Tylenoler/Hyperion/视觉素材/无标题的项目 (2).png

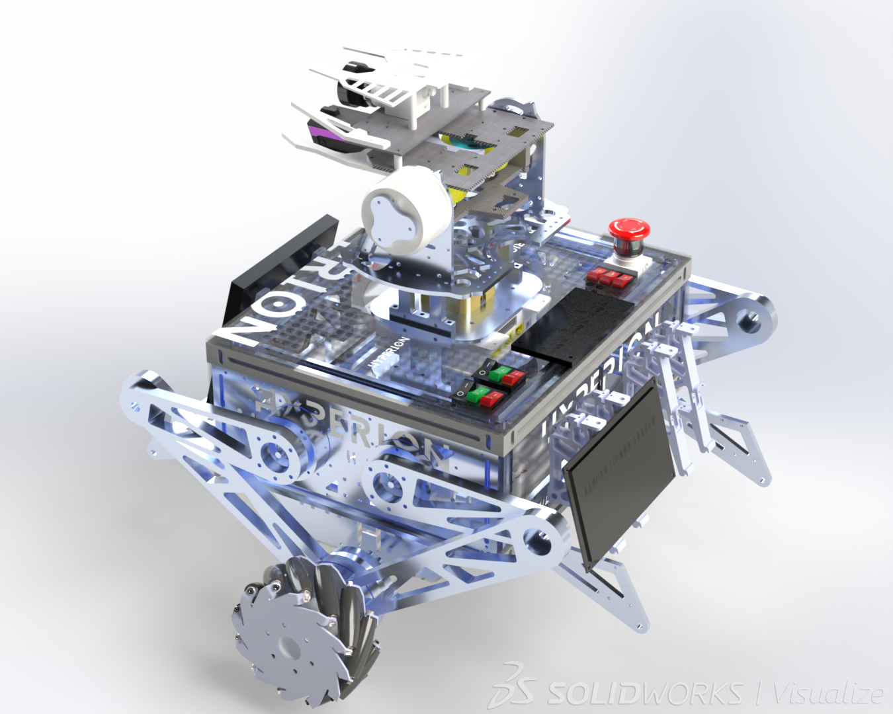
视觉素材/无标题的项目 (2).png
