Tylenoler/Hyperion/机械方面/电气部分/emergency-stop-switch-2.snapshot.23/EMERGENCY-STOP-STOP.fw.png

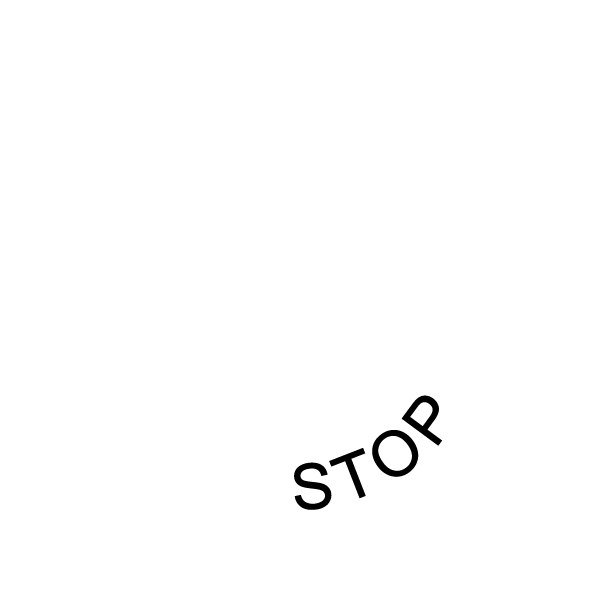
机械方面/电气部分/emergency-stop-switch-2.snapshot.23/EMERGENCY-STOP-STOP.fw.png
