Tylenoler/Hyperion/机械方面/电气部分/rocker-switch-34.snapshot.8 (2)/Rocker Switch_Render.png

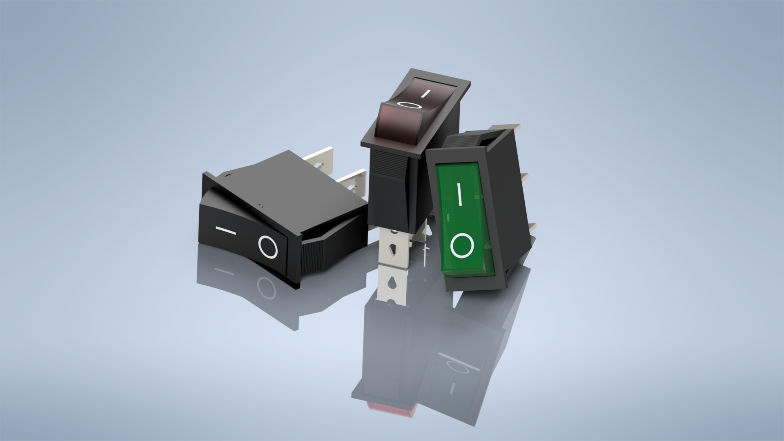
机械方面/电气部分/rocker-switch-34.snapshot.8 (2)/Rocker Switch_Render.png
