Tylenoler/Hyperion/机械方面/配图/24V电池-质量与官方相同.png

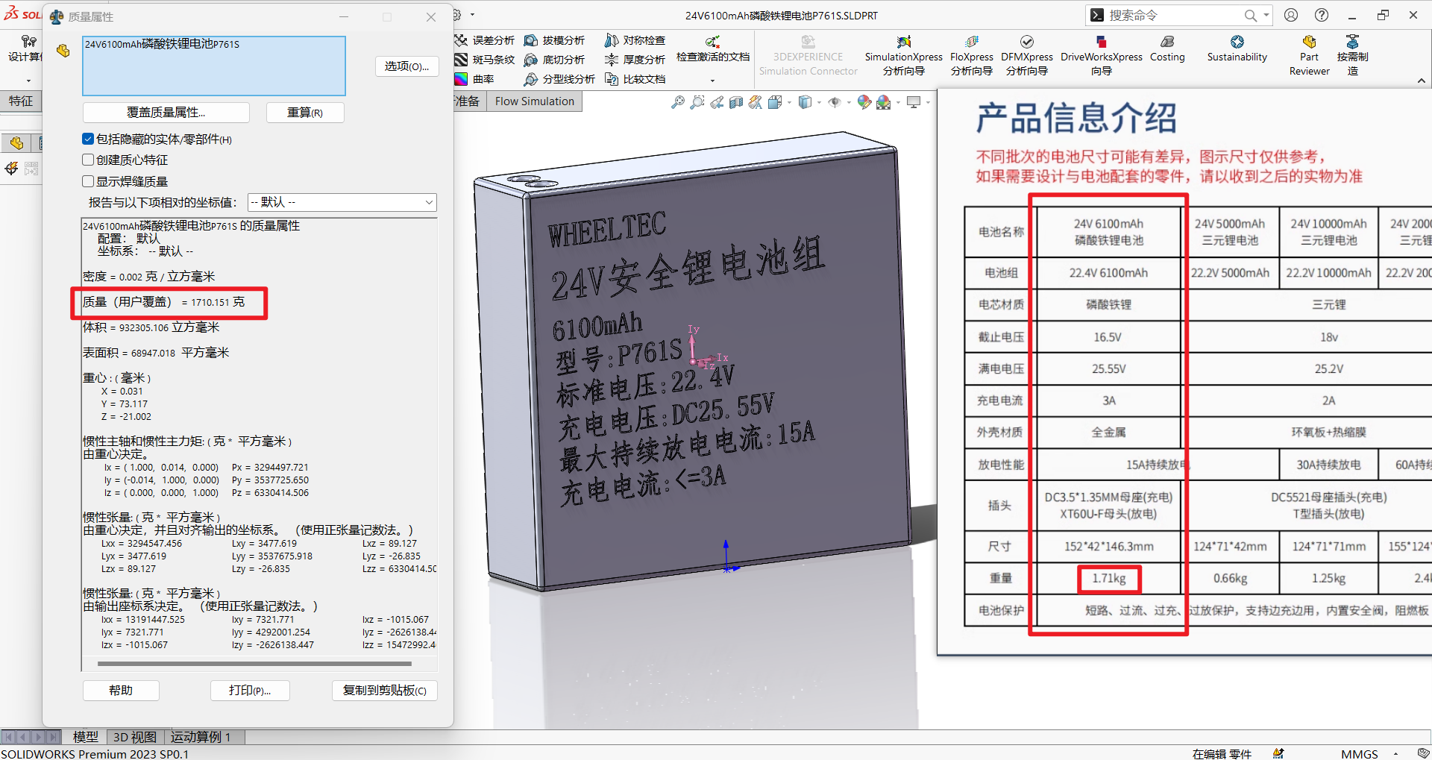
机械方面/配图/24V电池-质量与官方相同.png
