Tylenoler/Hyperion/机械方面/配图/稀土磁三相内转子57无刷电机-质量与官方一致.png

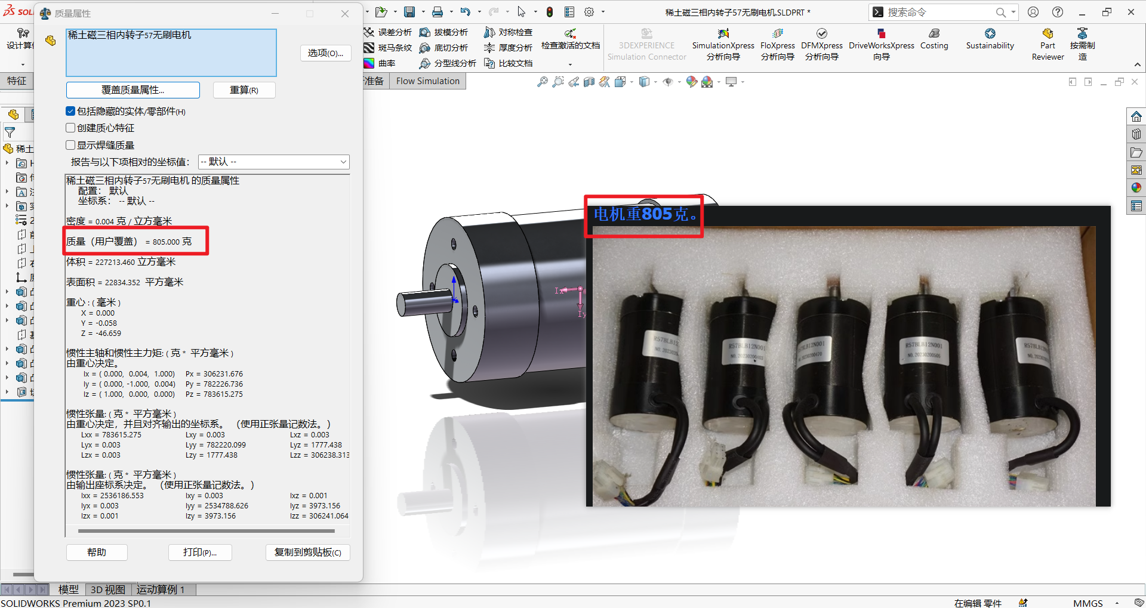
机械方面/配图/稀土磁三相内转子57无刷电机-质量与官方一致.png
