Tylenoler/Hyperion/视觉素材/DJI/R-C.png

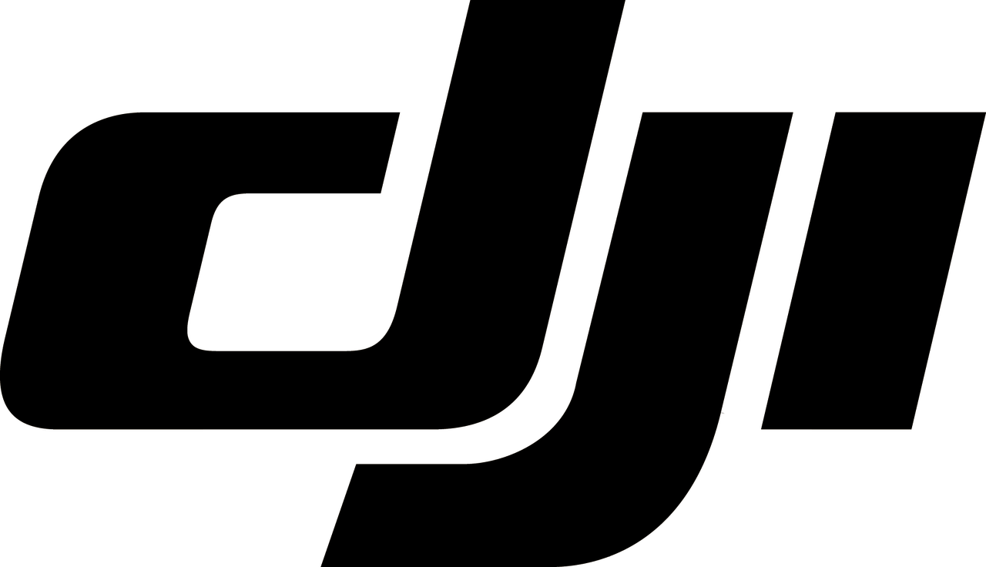
视觉素材/DJI/R-C.png
