Tylenoler/Hyperion/视觉素材/DJI/未标题-4.png

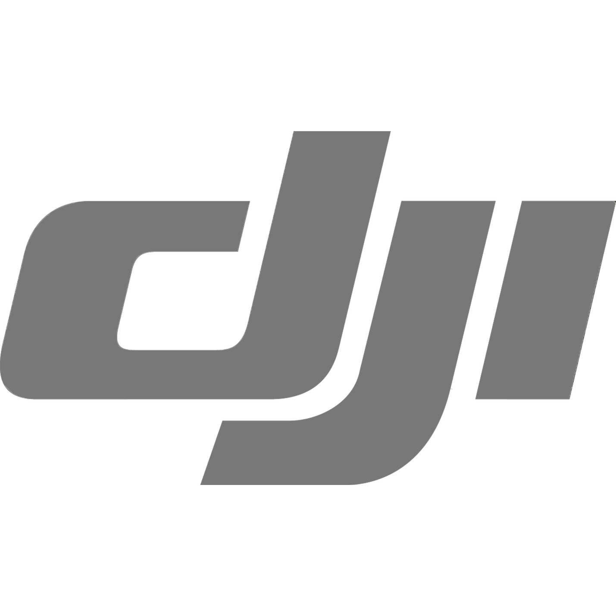
视觉素材/DJI/未标题-4.png
