Tylenoler/Hyperion/视觉素材/mmexport1707235157882.png

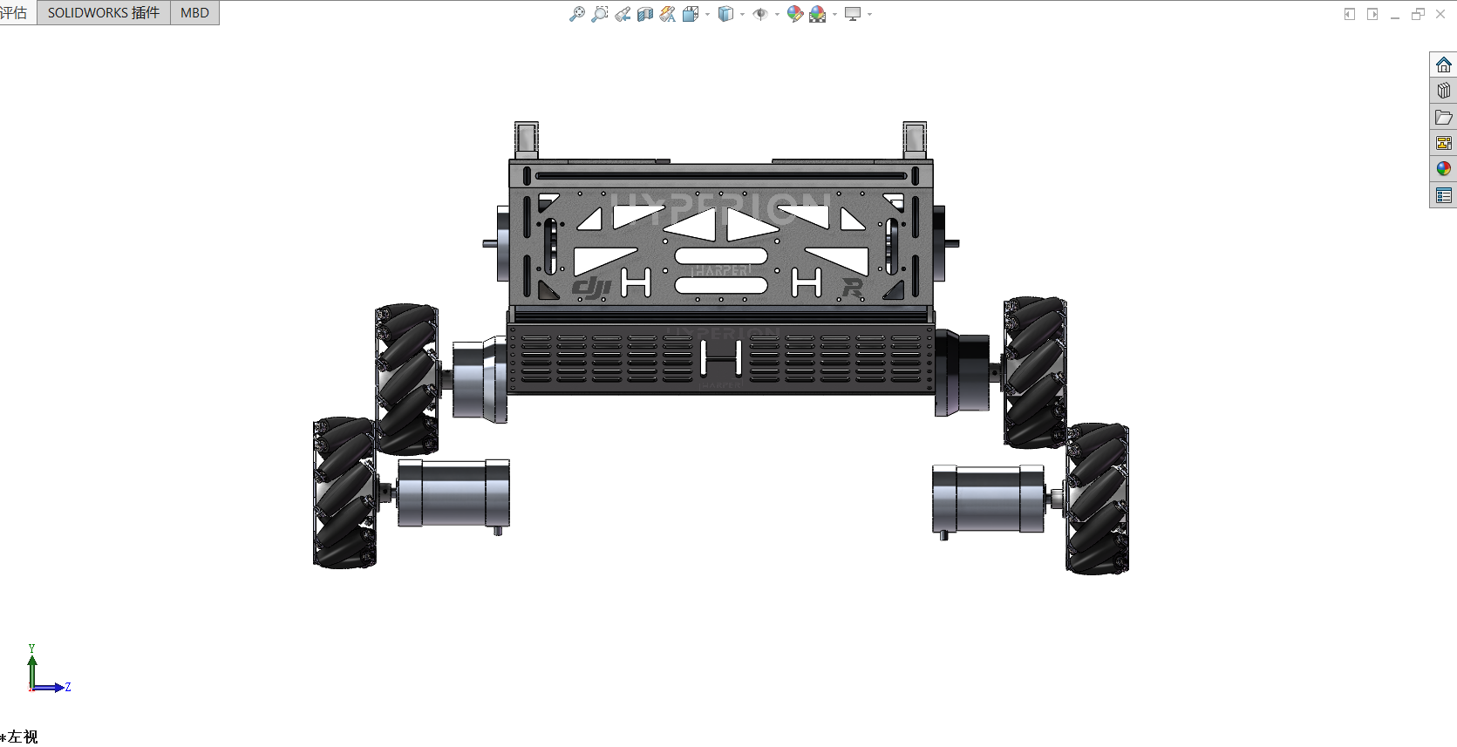
视觉素材/mmexport1707235157882.png
