Tylenoler/Hyperion/视觉素材/mmexport1707281538152.png

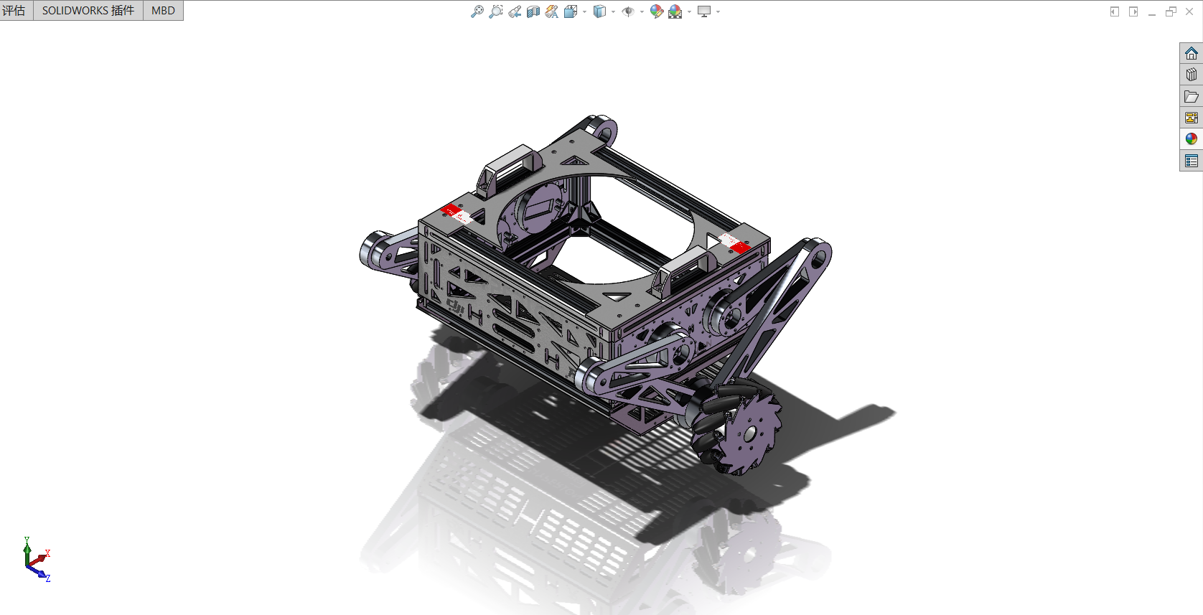
视觉素材/mmexport1707281538152.png
