Tylenoler/Hyperion/视觉素材/mmexport1707281540015.png

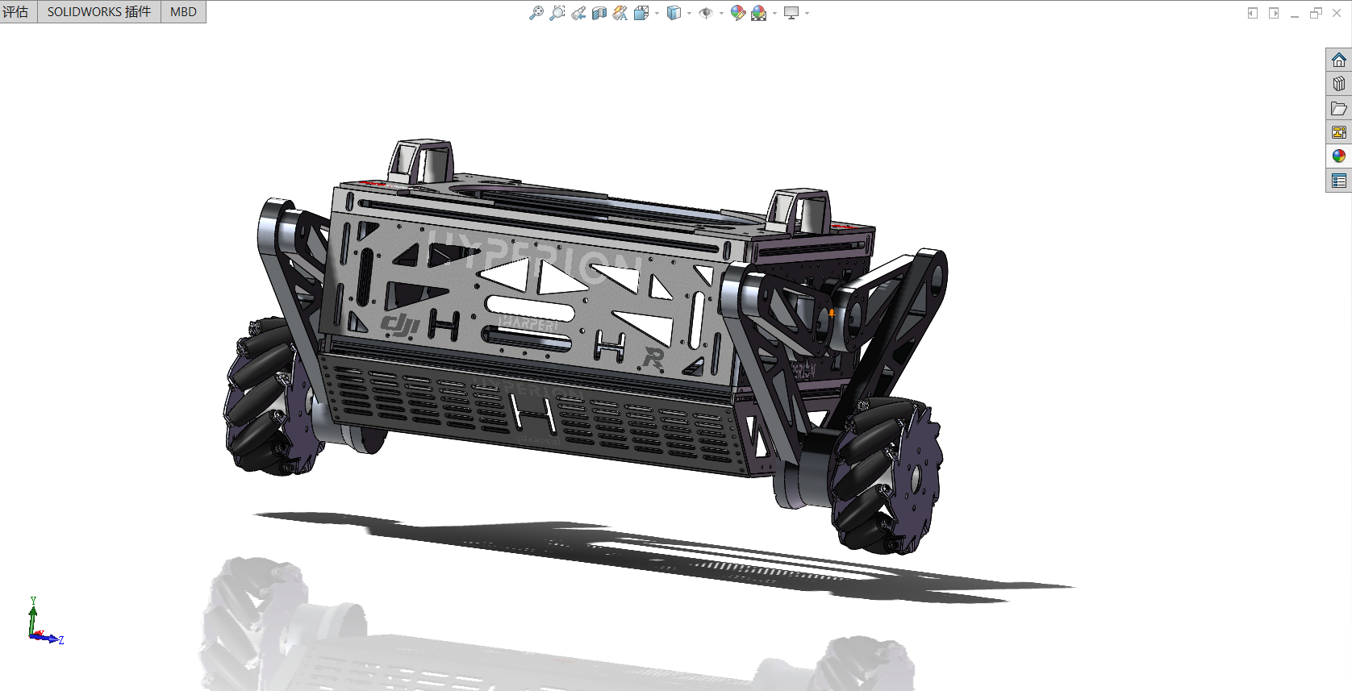
视觉素材/mmexport1707281540015.png
