Tylenoler/Hyperion/视觉素材/mmexport1707281541714.png

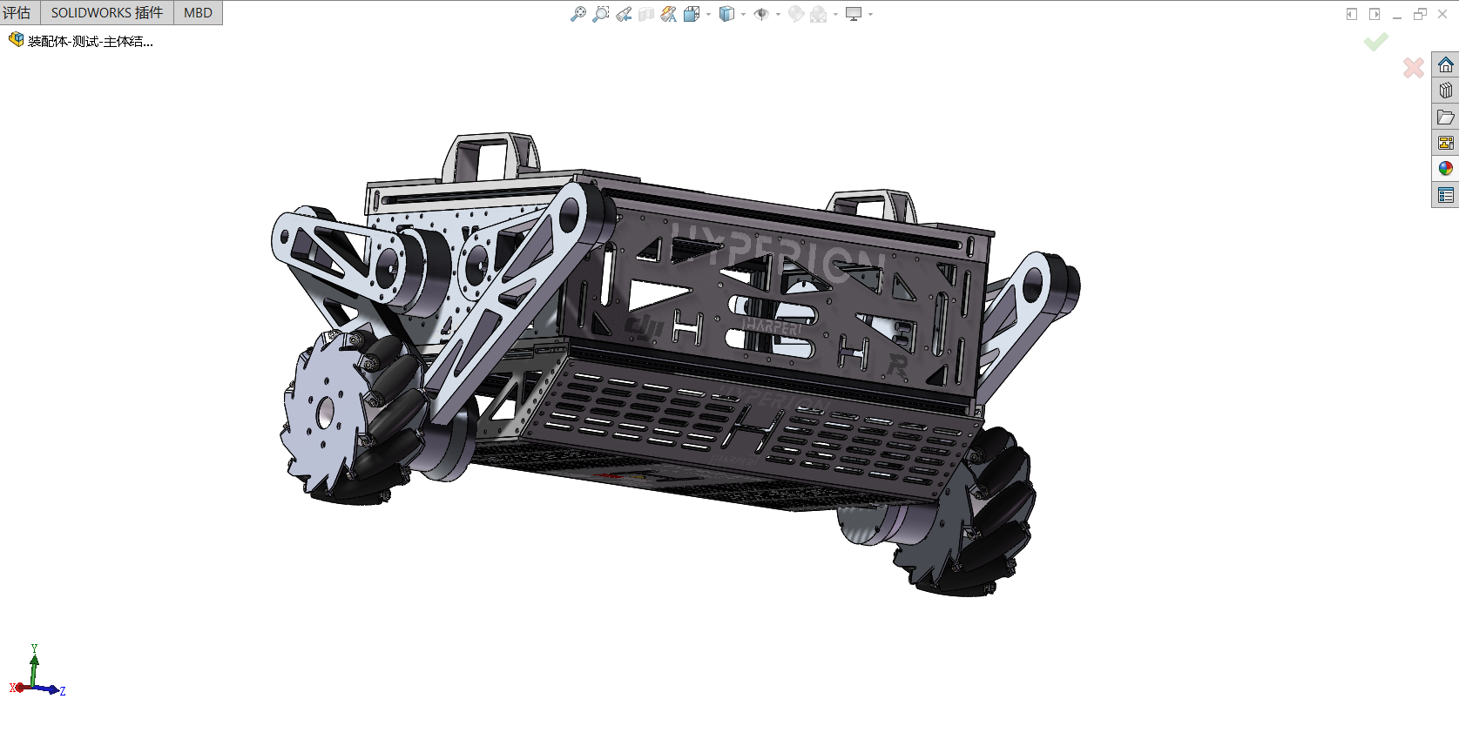
视觉素材/mmexport1707281541714.png
