Tylenoler/Hyperion/视觉素材/mmexport1707281543466.png

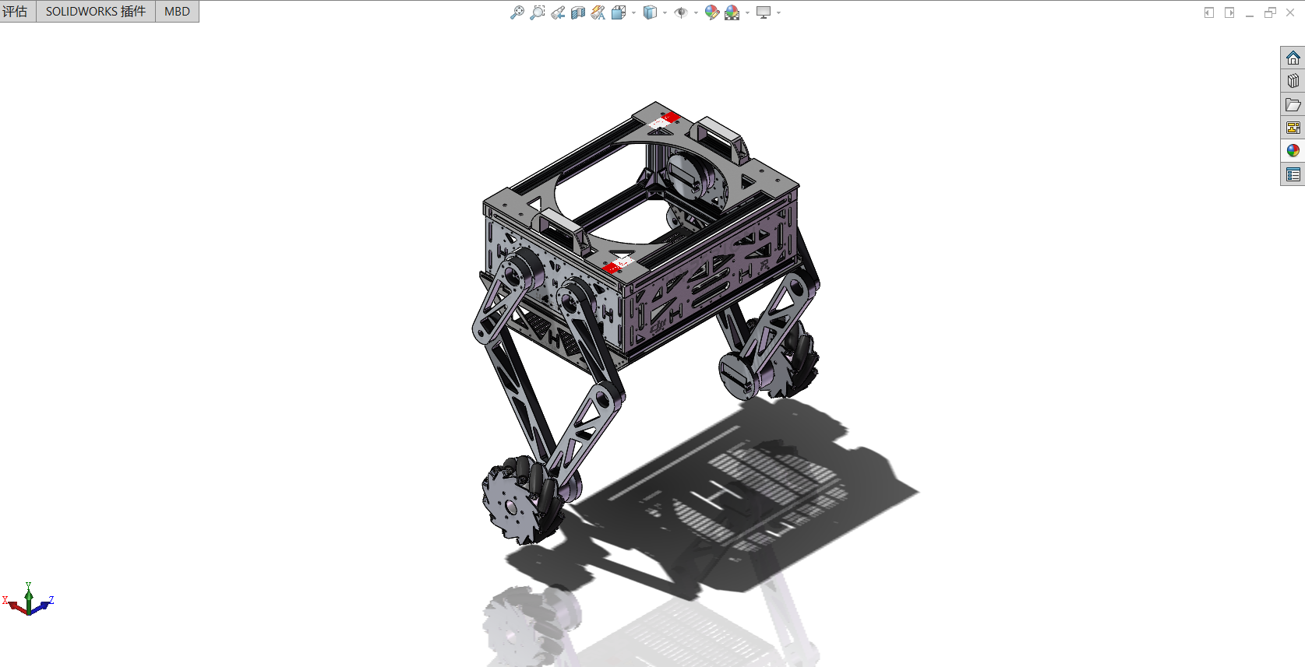
视觉素材/mmexport1707281543466.png
