Tylenoler/Hyperion/视觉素材/mmexport1707281544917.png

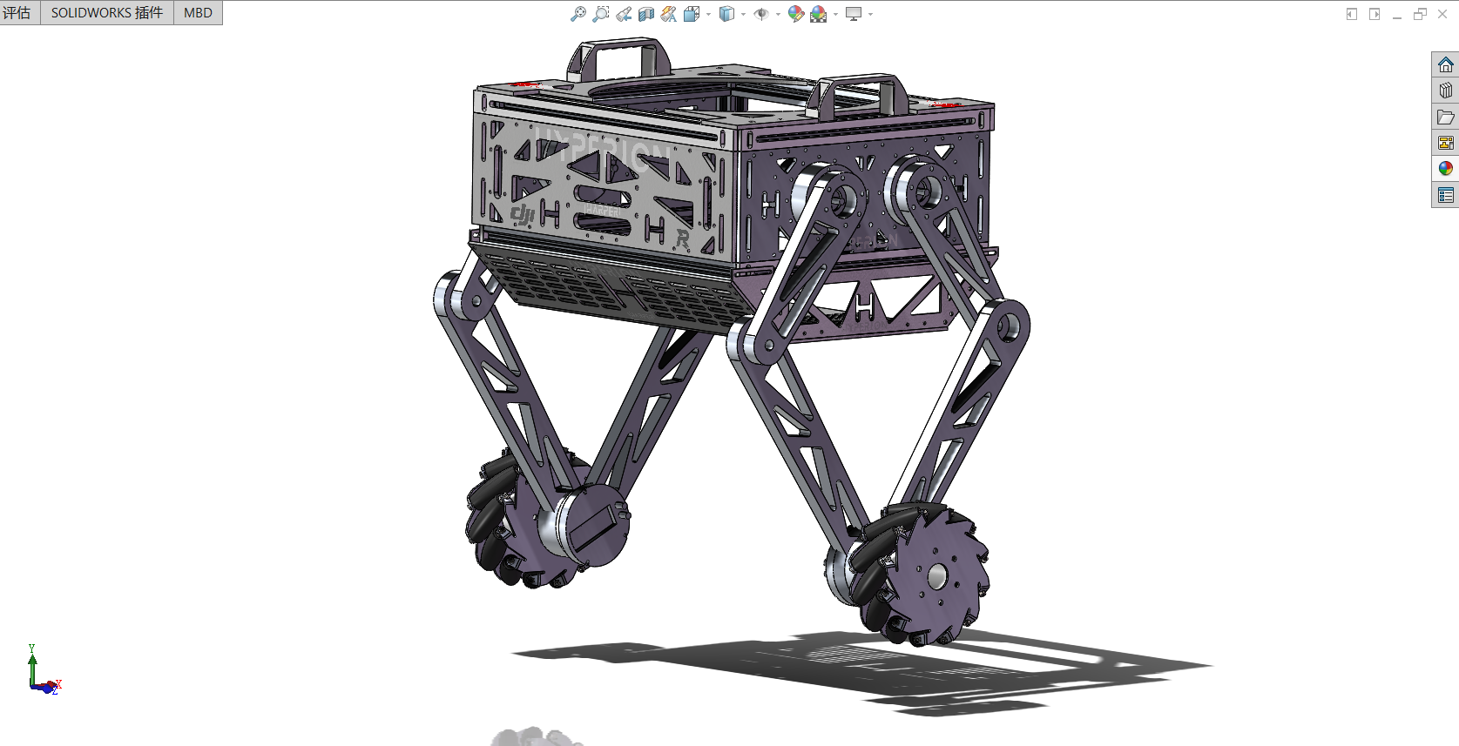
视觉素材/mmexport1707281544917.png
