Tylenoler/Hyperion/视觉素材/mmexport1707289371114.jpg

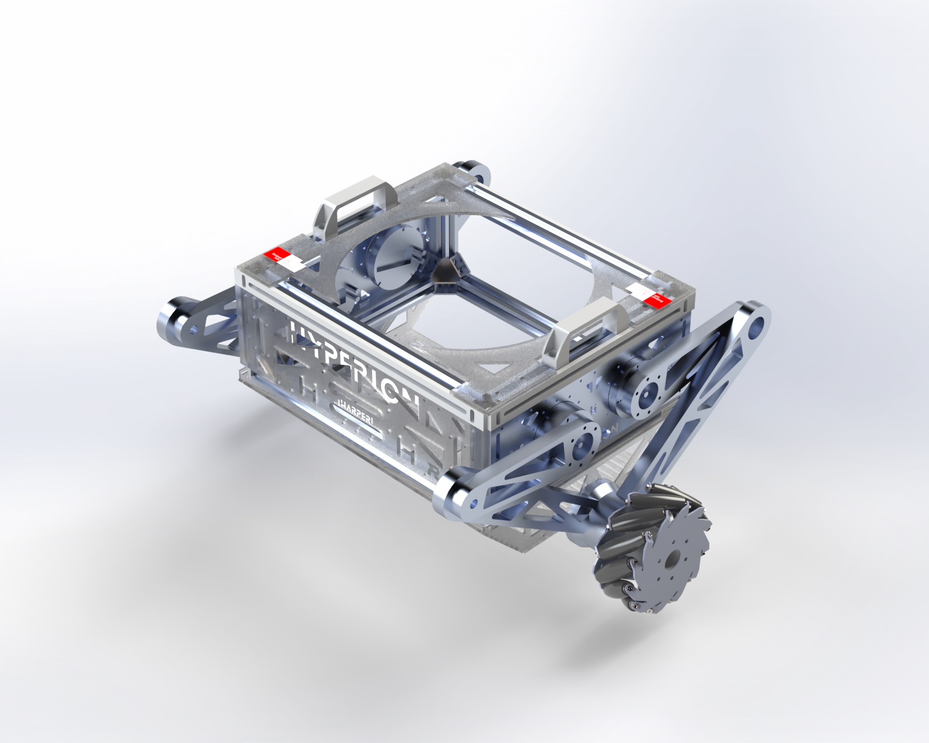
视觉素材/mmexport1707289371114.jpg
