Tylenoler/Hyperion/视觉素材/mmexport1707289372315.jpg

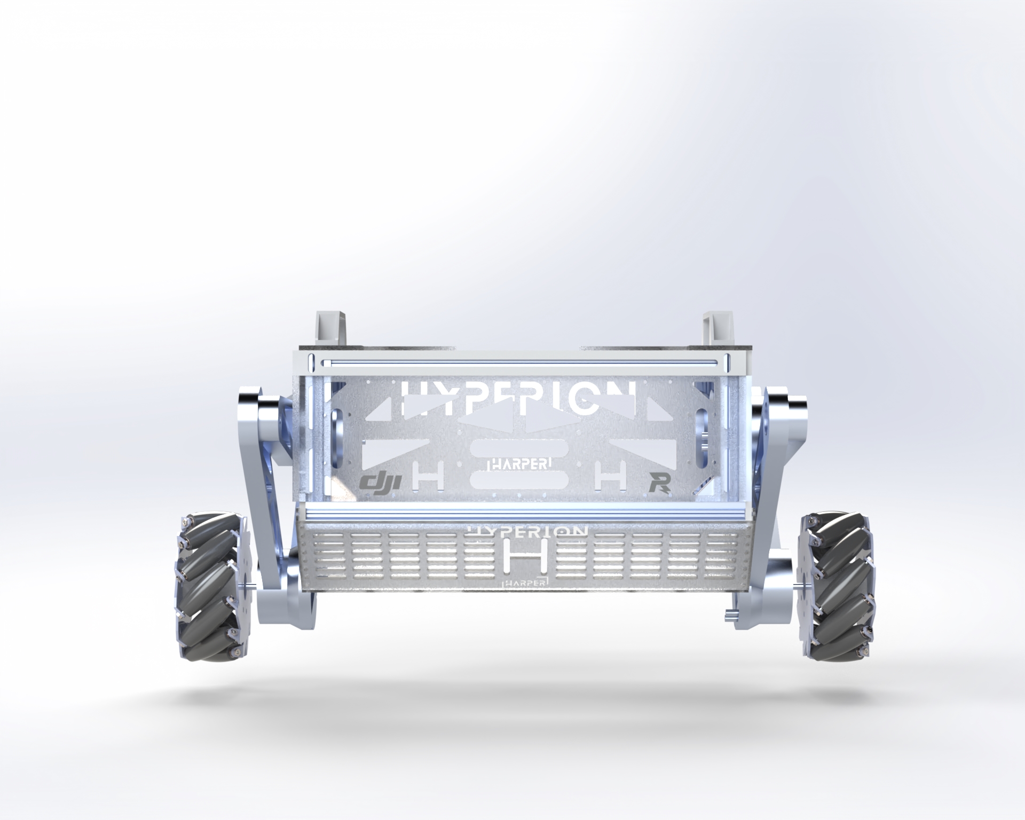
视觉素材/mmexport1707289372315.jpg
