Tylenoler/Hyperion/视觉素材/mmexport1707289373260.jpg

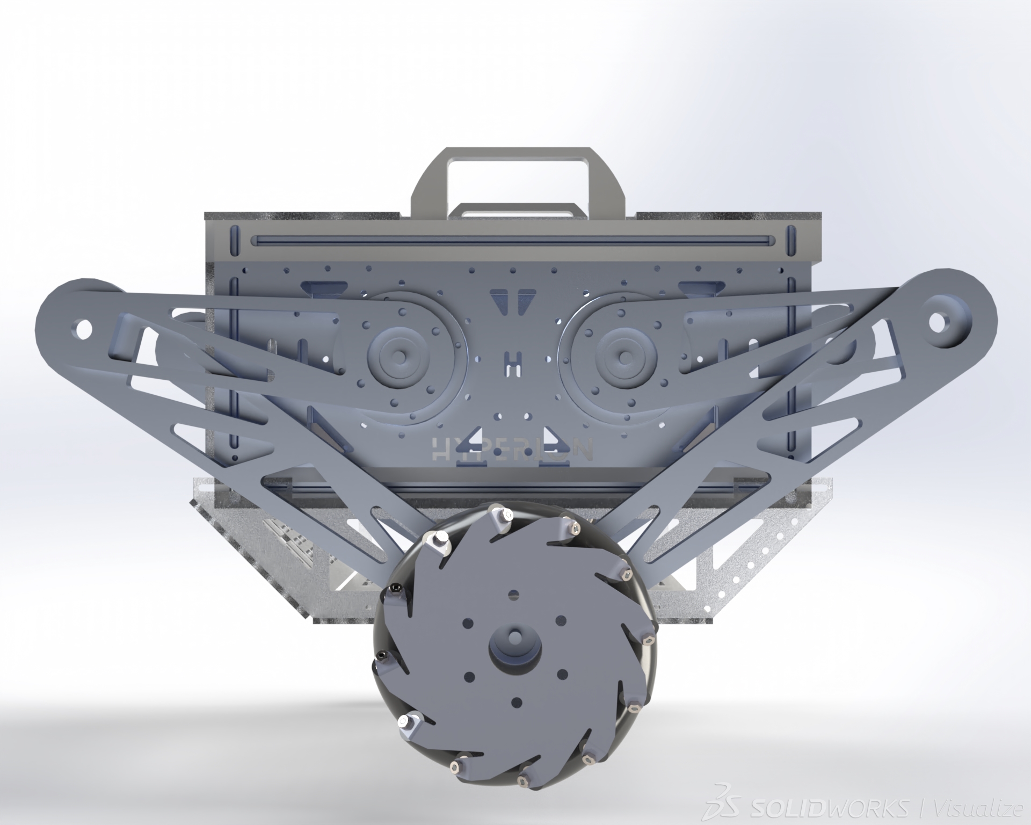
视觉素材/mmexport1707289373260.jpg
