Tylenoler/Hyperion/视觉素材/mmexport1707289374171.jpg

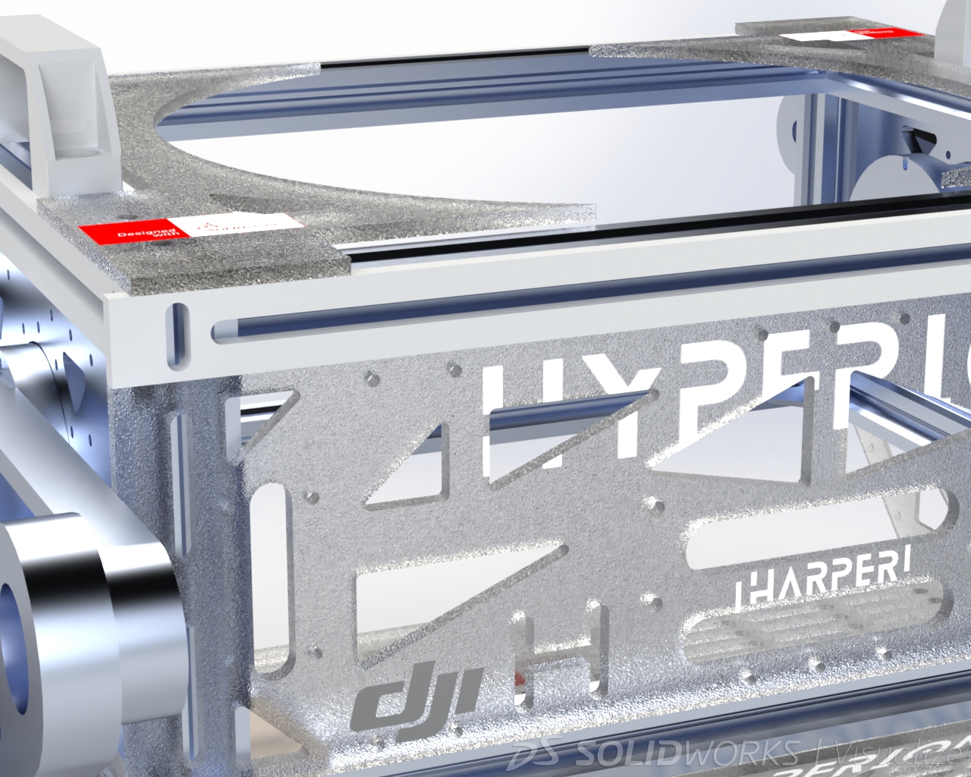
视觉素材/mmexport1707289374171.jpg
