Tylenoler/Hyperion/视觉素材/mmexport1707310739543.jpg

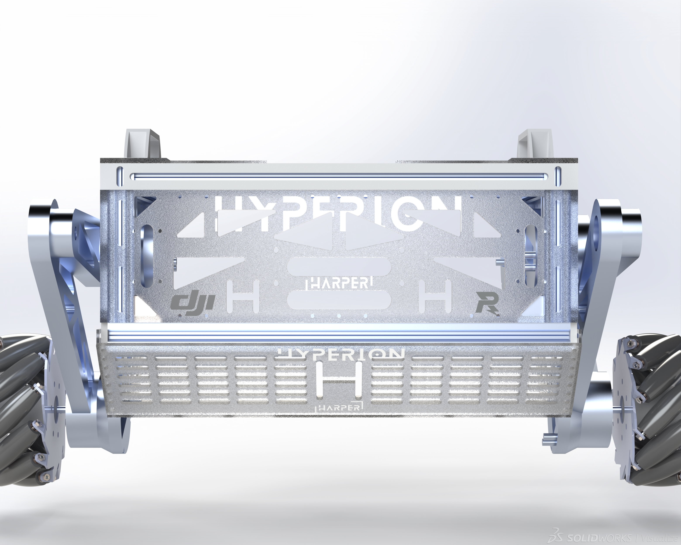
视觉素材/mmexport1707310739543.jpg
