Tylenoler/Hyperion/视觉素材/mmexport1707310748048.jpg

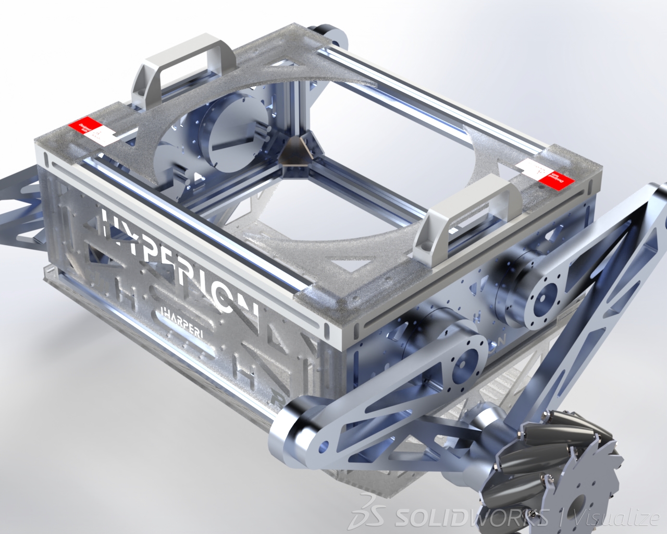
视觉素材/mmexport1707310748048.jpg
