Tylenoler/Hyperion/视觉素材/Robomaster/未标题-2 - 副本.png

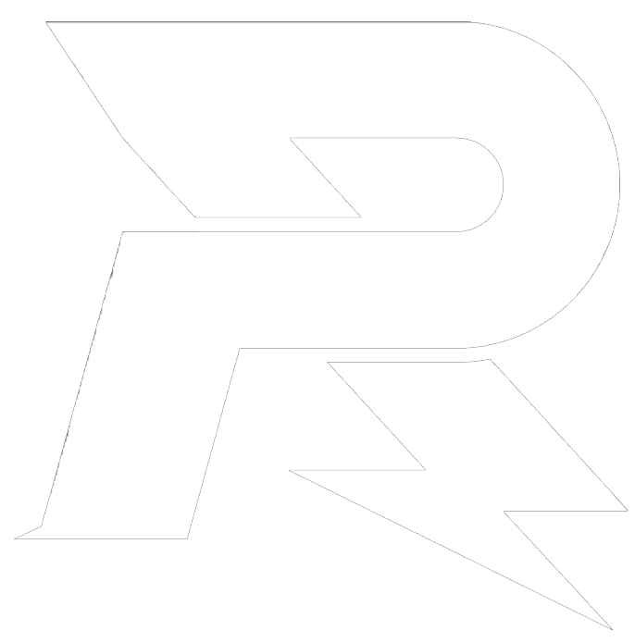
视觉素材/Robomaster/未标题-2 - 副本.png
