Tylenoler/Hyperion/视觉素材/Robomaster/未标题-2.png

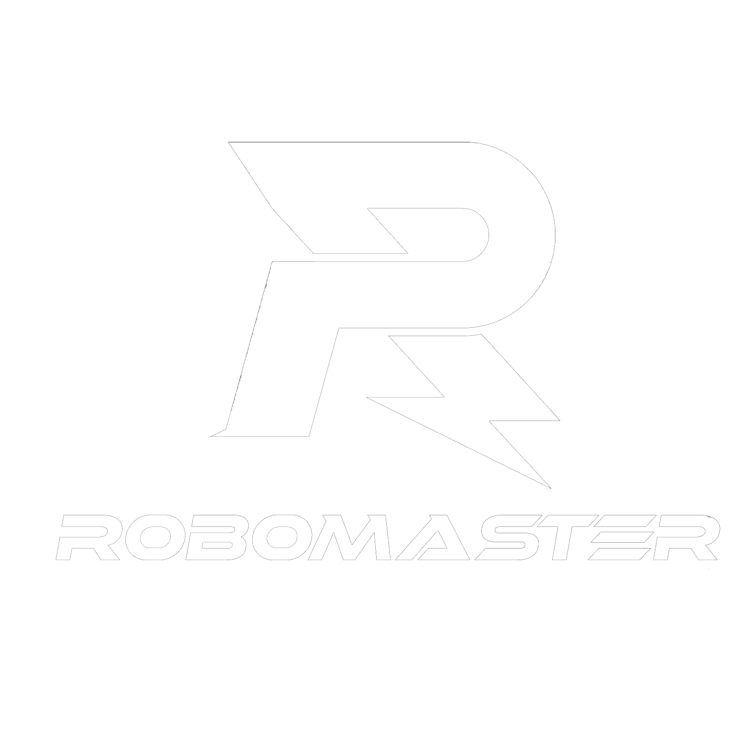
视觉素材/Robomaster/未标题-2.png
