Tylenoler/Hyperion/视觉素材/Snipaste_2024-02-10_00-50-37.png

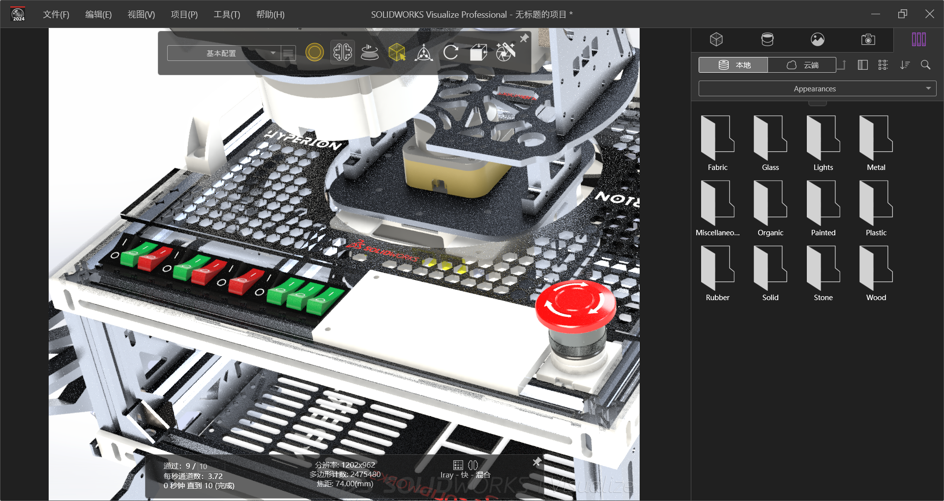
视觉素材/Snipaste_2024-02-10_00-50-37.png
