Tylenoler/Hyperion/视觉素材/无标题的项目2215.png

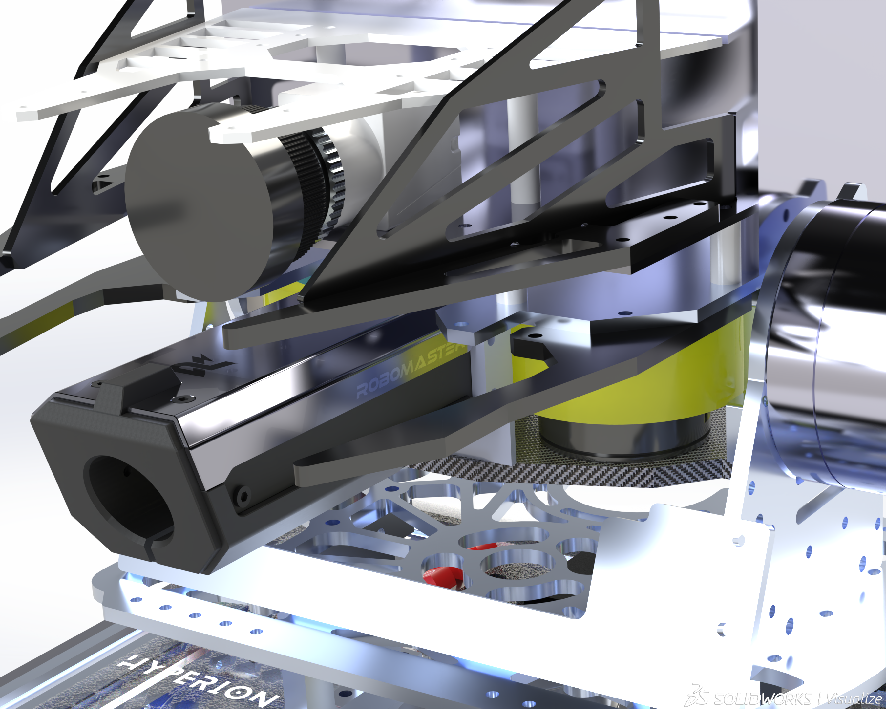
视觉素材/无标题的项目2215.png
