Tylenoler/Hyperion/视觉素材/无标题的项目2309.png

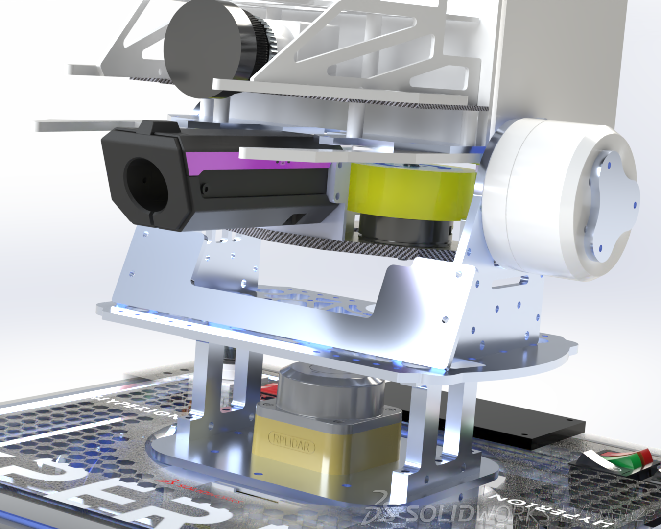
视觉素材/无标题的项目2309.png
