Tylenoler/Hyperion/规划购买物品清单.xlsx

规划购买物品清单
 |  |  |  |  |  | 202401272155
分组 | 购买批次 | 类别 | 物品名称 | 物品型号 | 购买渠道 | 购买链接 | 已买 | 个数 | 单价 | 运费 | 已花费 | 总价 | 备注
电控 | TB-20240225103155 | 控制器 | 触想RK3568开发板 | RK3568[4G+128G] | 淘宝 | https://m.tb.cn/h.5rhroDwYNpdvMTq?tk=WwFsW82kTrk CZ0001 「触想RK3568/RK3588/I3/I5/I7工控主板双网口工业级智能自动化设备」 | 1 | 1 | 358 | 20 | 378 | 358
 | NO | 控制器 | 正点原子STM32F103RCT6 |  | 无 | 无 | 1 | 1 | 0 | 0 | 0 | 0
 |  | 控制器 | RT-thread ART-PI开发板(STM32H750XBH6) | ART-PI | 淘宝 | https://m.tb.cn/h.5JtJTWvxy74sQGD?tk=0ZWCW82O1yg CZ0001 「RT-Thread ART-Pi STM32H750XBH6开发板 H750开发板」 |  | 1 | 338 |  | 0 | 338
 |  | 扩展板 | RT-thread ART-PI 工业扩展板 | ART-PI | 淘宝 | https://m.tb.cn/h.5JtrkfJJTXbez5p?tk=cFZOW82NhZV CZ0001 「RT-Thread ART-Pi 工业扩展板」 |  | 1 | 168 |  | 0 | 168
 |  | 控制器 | STM32F407VET6 | STM32F407VET6 | 淘宝 | https://m.tb.cn/h.5Ip2N8qNzeaMJ1B?tk=L0p9W82oVz3 CZ0001 「STM32F407VET6开发板带CAN嵌入式RS485学习USB核心WiFi阿里云魔女」 |  | 1 | 115 |  | 0 | 115
 |  | 供电 | E326S大容量电池 | 12V5000mah | 淘宝 | https://m.tb.cn/h.5szMvq20eVcioYR?tk=ABDxWjjro8Y CA6496 「E326S带保护外壳12V智能小车机器人18650锂电池组2600mah E318S」 |  | 1 | 114 |  | 0 | 114
 |  | 供电 | E327S大容量电池 | 24V6100mah | 淘宝 | https://m.tb.cn/h.5szotgjRpqZJSQA?tk=VCCnWjjsZNx CZ3452 「24V 6100mah磷酸铁锂电池10000mah锂电池组防过充过放保护A品电芯」 |  | 1 | 305 |  | 0 | 305
 |  | 雷达 | 思岚激光雷达RPLIDAR C1 | RPLIDAR C1 | 淘宝 | https://m.tb.cn/h.5Ip9rH7C4OnzRTp?tk=PcpkW82zRmB CZ0000 「思岚官方RPLIDAR激光雷达传感器ROS小车SLAM导航建图测距A1 S2 C1」 |  | 1 | 371 |  | 0 | 371
 |  | 屏幕 | 微雪LED点阵显示屏RGB全彩 | LED-RGB-P2.5-64×64 | 淘宝 | https://m.tb.cn/h.5rSfaOEwPQ36tKw?tk=w3dPW8dZJTe CZ0000 「微雪 树莓派LED点阵显示屏 RGB全彩显示模块 亮度可调 支持级联」 |  | 1 | 119 |  | 0 | 119
 |  | 屏幕 | 陶晶驰串口屏T14.3寸 | T1-4.3寸电阻触摸 | 淘宝 | https://m.tb.cn/h.5rEIOPdba05Em6L?tk=Uuf9W8LrcYl CZ0000 「淘晶驰T1系列4.3寸串口屏IPS全视角tft液晶屏HMI触摸屏tft显示屏」 |  | 1 | 43 |  | 0 | 43
 |  | 屏幕 | 陶晶驰串口屏X5-10.1寸 | X5-10.1寸电阻触摸 | 淘宝 | https://m.tb.cn/h.5sdM6KuLke7JtPQ?tk=pyghW8LJKjd CZ0001 「X5系列淘晶驰10.1寸触摸屏 高清串口显示屏 HMI触摸屏 支持音视频」 |  | 1 | 241 |  | 0 | 241
 |  | 深度相机 | 奥比中光大白PRO | 大白pro | 闲鱼 | https://m.tb.cn/h.5IJf5qT?tk=CiDFWjjrcTY CZ3456 「快来捡漏【全新奥比中光大白pro深度相机DaBai 3D双目结构光深度】」 |  | 1 | 280 |  | 0 | 280
 |  |  |  |  |  |  | 已买 | 总 |  |  | 已花费 | 总价
 |  |  |  |  |  |  | 2 | 12 |  |  | 378 | 2452
分组 | 购买批次 | 类别 | 物品名称 | 物品型号 | 购买渠道 | 购买链接 | 已买 | 个数 | 单价 | 运费 | 已花费 | 总价 | 备注
机械 |  | 轮子 | 麦克纳姆轮-127mm×4 | 麦克纳姆轮 | 淘宝 | https://m.tb.cn/h.5rhBTrlZoYVPzyP?tk=57C3W82tnQa CZ0000 「一组4个麦克纳姆轮 麦轮60mm 75 100 127 152mm轮子mecanum wheel」 |  | 0 | 520 |  | 0 | 0
 |  | 轮子 | 麦克纳姆轮-152mm×4 | 麦克纳姆轮 | 淘宝 | https://m.tb.cn/h.5rhBTrlZoYVPzyP?tk=57C3W82tnQa CZ0000 「一组4个麦克纳姆轮 麦轮60mm 75 100 127 152mm轮子mecanum wheel」 |  | 0 | 690 |  | 0 | 0
 |  | 轮子 | 汽车工艺实心橡胶承重轮-125mm×2 |  | 淘宝 | https://m.tb.cn/h.5GJ7UreAPAjxVxJ?tk=t0VWWPviCrL CZ3458 「实心橡胶承重轮主动轮智能小车轮子机器人耐磨驱动轮胎无人车AGV」 |  | 0 | 59 |  | 0 | 0
 |  | 电机 | 5065-320kv有感无刷直流电机 | 5065 | 淘宝 | https://m.tb.cn/h.5sWdzUG7bvV0BkN?tk=yhH1W8pfbVf CZ0001 「5065-320KV有感无感无刷大功率直流减速电机四轮遥控滑板调速马达」 |  | 0 | 154 |  | 0 | 0
 |  | 联轴器 | 抱紧式联轴器 |  | 淘宝 | https://m.tb.cn/h.5GswZzrbuvSMmMQ?tk=wE7eWPDsA2h HU9196 「抱紧式联轴器外径28mm可选孔径5 6 8mm56.8mm可选孔径6 8 10 12mm」 |  | 6 | 54 |  | 0 | 324
 |  | 电调 | ROBOMASTER萝马集市电调中心板2 | ROBOMASTER | 淘宝 | https://m.tb.cn/h.5rEvEikoK7E0kCC?tk=fEqDW82qbS5 CZ0001 「ROBOMASTER萝马集市 电调中心板2」 |  | 1 | 95 |  | 0 | 95
 |  | 电机 | B5665M内转子无刷电机 | B5665M | 淘宝 | https://m.tb.cn/h.5siwf7WFewdej7e?tk=FWqgW8wqEnG CZ0000 「赛车游戏 B5665M 内转子无刷电机 DC24V 3600转 带主动散热风扇」 |  | 0 | 36.8 |  | 0 | 0
 | TB-20240225102803 | 电机 | 空心杯转子铷强磁无刷电机 | 74mm×45.5mm | 淘宝 | https://m.tb.cn/h.5ILcqkBR3QIzFJA?tk=lDPnW8wBjKT CZ0000 「空心杯转子钕强磁无刷电机 12-24V大扭矩静音大功率密封无刷电机」 | 2 | 6 | 45 | 7 | 97 | 270
 |  | 电机 | 稀土磁三相内转子57无刷电机 | 57 | 淘宝 | https://m.tb.cn/h.5I2HBYvbfIyoIdH?tk=Abu5WjjzSQZ CZ3458 「稀土磁三相内转子57无刷电机 24V-60V带霍尔低速无刷电机DIY发电」 |  | 2 | 38 |  | 0 | 76
 |  |  |  |  |  |  | 已买 | 总 |  |  | 已花费 | 总价
 |  |  |  |  |  |  | 2 | 15 |  |  | 97 | 765
分组 | 购买批次 | 类别 | 物品名称 | 物品型号 | 购买渠道 | 购买链接 | 已买 | 个数 | 单价 | 运费 | 已花费 | 总价 | 备注
其他 | TB-20240225102803 | 散热 | 静音散热风机 |  | 淘宝 | https://m.tb.cn/h.5FkFmDnrCNANyk2?tk=yQgCWPvmQOH CZ8908 「全新5010静音散热风机 5V-12V无刷风机风扇带散热铝合金散热片组」 | 1 | 1 | 4.5 | 0 | 4.5
 |  | 护目镜 | ROBOMASTER防冲击安全护目镜 | ROBOMASTER | 淘宝 | https://m.tb.cn/h.5Ip4ZQNvcaKcnFQ?tk=T5vpW82rN5K CZ0000 「ROBOMASTER RoboMaster S1防冲击安全护目镜」 |  | 1 | 29 |  | 0 | 29
 |  | RFID | ROBOMASTER-RFID标签卡TC02 | ROBOMASTER | 淘宝 | https://m.tb.cn/h.5rhCgpH82en7P4O?tk=b7RdW82rL5F CZ0001 「ROBOMASTER萝马集市 RFID 标签卡TC02（2张）」 |  | 1 | 45 |  | 0 | 45
 |  |  |  |  |  |  | 已买 | 总 |  |  | 已花费 | 总价
 |  |  |  |  |  |  | 1 | 2 |  |  | 4.5 | 74
分组 | 购买批次 | 类别 | 物品名称 | 物品型号 | 购买渠道 | 购买链接 | 已买 | 个数 | 单价 | 运费 | 已花费 | 总价 | 备注
3D打印
 |  |  |  |  |  |  | 已买 | 总数 |  |  | 已花费 | 总价
 |  |  |  |  |  |  |  | 29 |  |  | 479.5 | 3291
