Tylenoler/Hyperion/机械方面/轮腿结构/麦克纳姆轮组部分/装配体-152mm麦克纳姆轮组.SLDASM

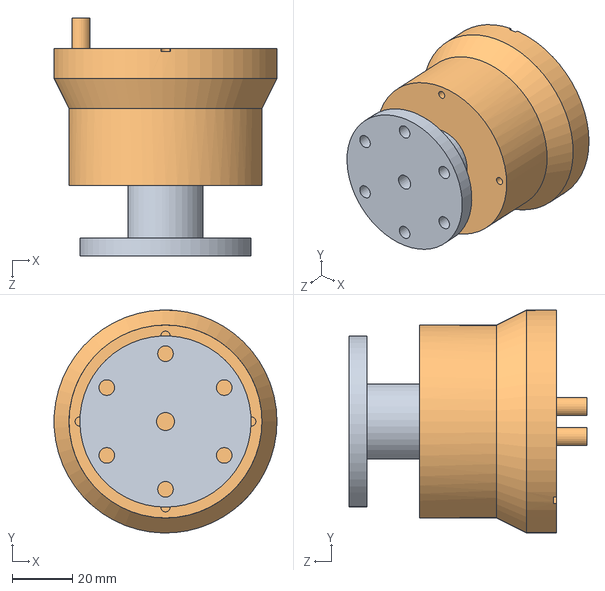
[picture p165: CAD file, 2024-02-28]
机械方面/轮腿结构/麦克纳姆轮组部分/装配体-152mm麦克纳姆轮组.SLDASM
74.0 x 74.0 x 78.9 mm
零件-电机-12-24V空心杯转子钕强磁无刷电机
零件-联轴器-6-56.8mm
