Tylenoler/Hyperion/机械方面/轮腿结构/麦克纳姆轮组部分/装配体-127mm麦克纳姆轮.SLDASM

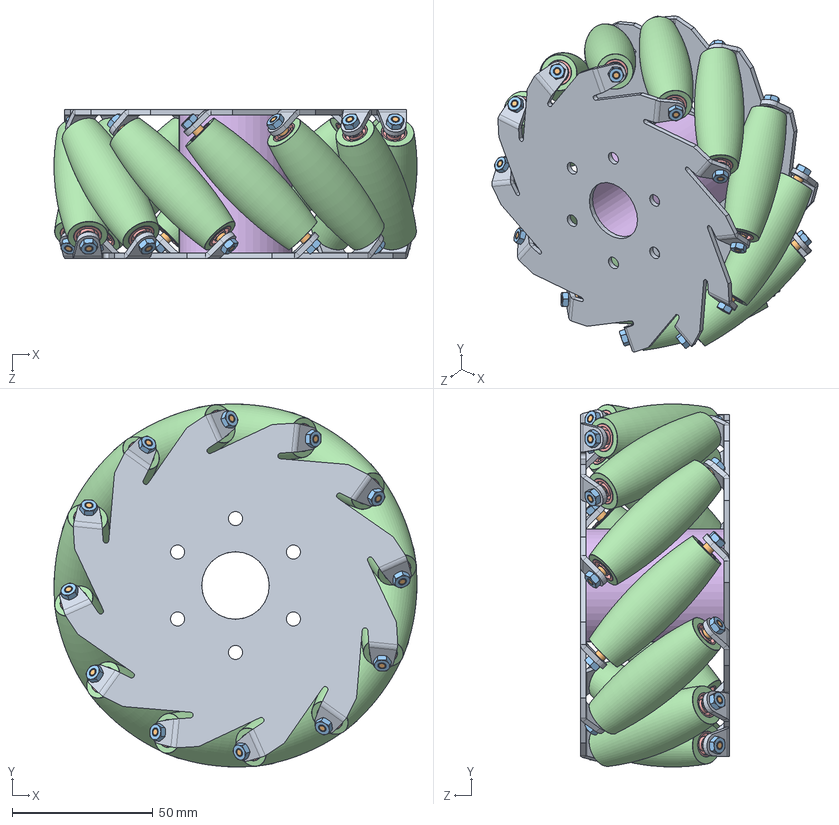
[picture p166: CAD file, 2024-02-06]
机械方面/轮腿结构/麦克纳姆轮组部分/装配体-127mm麦克纳姆轮.SLDASM
128.9 x 128.9 x 52.9 mm
Mecanum Sneh plate x 2
Rollers-Axis x 12
hex nut style 1_am x 24
Rollers x 12
radial ball bearing_68_am x 24
Spacer
