Tylenoler/Hyperion/机械方面/云台机构/发射机构(对抗赛通用单枪)/舵机装配体.SLDASM

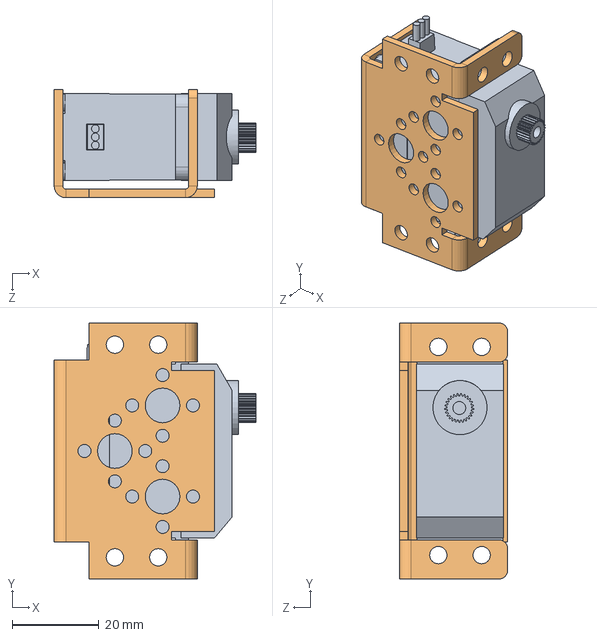
[picture p167: CAD file, 2024-02-18]
机械方面/云台机构/发射机构(对抗赛通用单枪)/舵机装配体.SLDASM
46.5 x 59.0 x 25.0 mm
单轴舵机
多功能支架
