Tylenoler/Hyperion/机械方面/主架部分/零件-车架-快装板20X290.SLDPRT

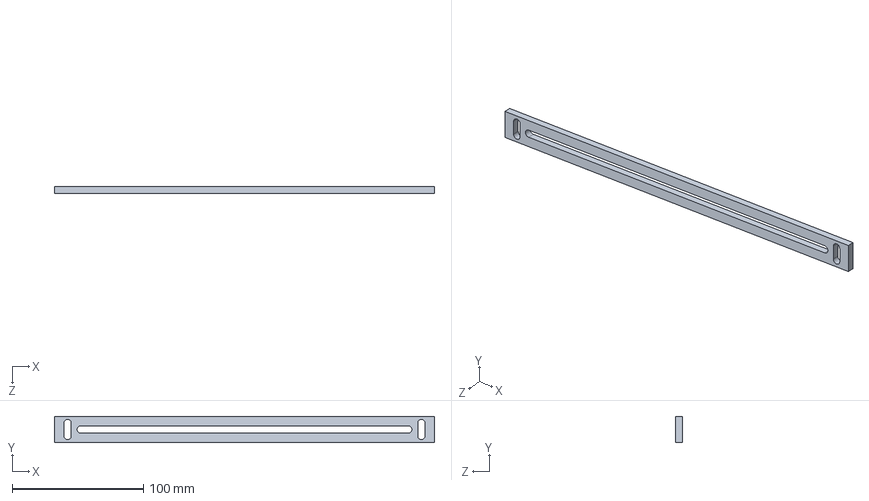
[picture p168: CAD file, 2024-02-28]
机械方面/主架部分/零件-车架-快装板20X290.SLDPRT
290.0 x 20.0 x 5.00 mm
