Tylenoler/Hyperion/机械方面/云台机构/Pitch轴/零件-电机-6020 直流无刷电机.SLDPRT

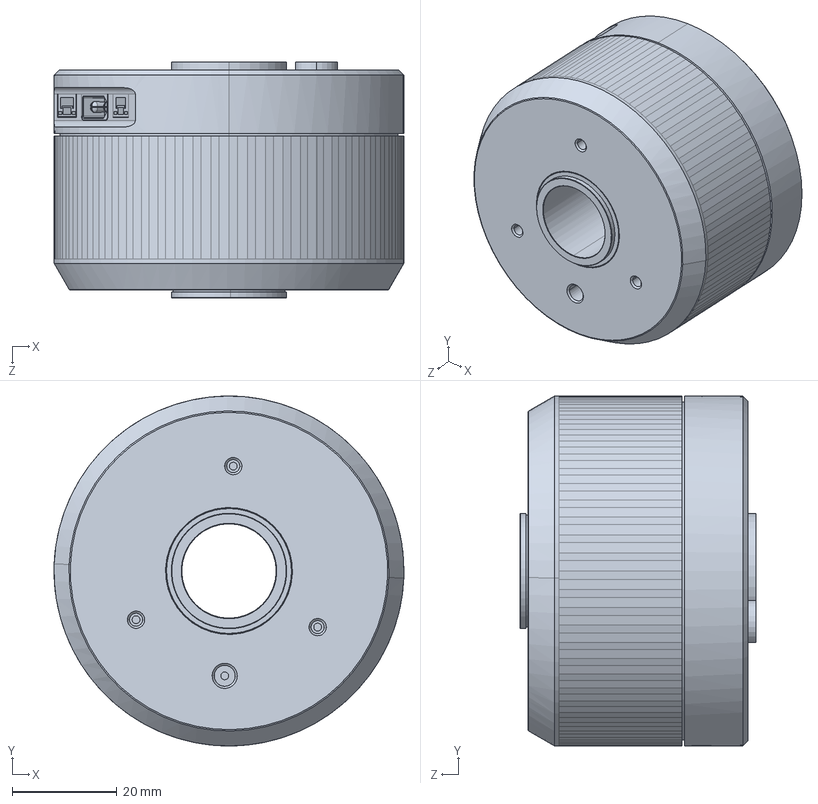
[picture p169: CAD file, 2024-02-18]
机械方面/云台机构/Pitch轴/零件-电机-6020 直流无刷电机.SLDPRT
66.7 x 66.7 x 45.0 mm
