Tylenoler/Hyperion/机械方面/云台机构/walksnail-avatar-hd-pro-camera-1.snapshot.2/Walksnail HD Pro Camera v1.step

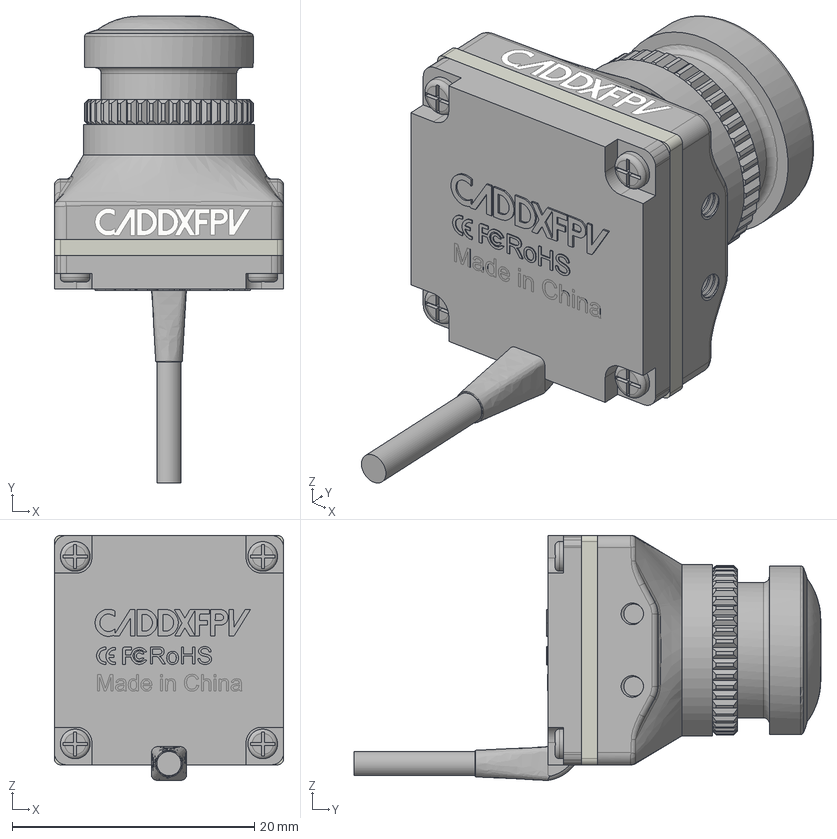
[picture p170: CAD file, 2024-02-25]
机械方面/云台机构/walksnail-avatar-hd-pro-camera-1.snapshot.2/Walksnail HD Pro Camera v1.step
19.0 x 38.6 x 20.2 mm
Lens Unit
Board
Back Plate
Main Housing
9cm MIPI Cable
