Tylenoler/Hyperion/机械方面/云台机构/发射机构(对抗赛通用单枪)/零件-发射机构-5mm基板.SLDPRT

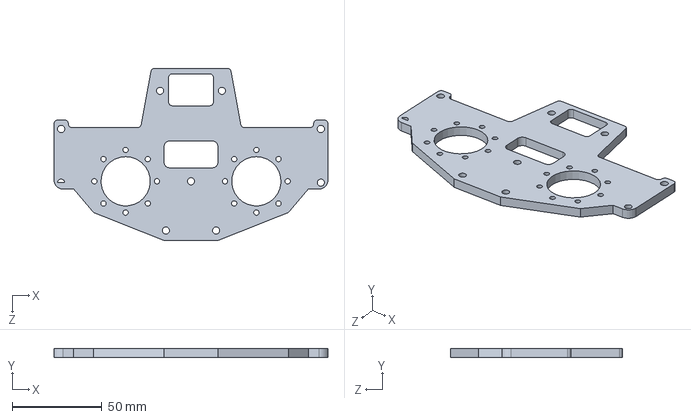
[picture p171: CAD file, 2024-02-28]
机械方面/云台机构/发射机构(对抗赛通用单枪)/零件-发射机构-5mm基板.SLDPRT
153.0 x 5.00 x 96.1 mm
