Tylenoler/Hyperion/机械方面/供电部分/零件-电池-24V6100mAh磷酸铁锂电池P761S.SLDPRT

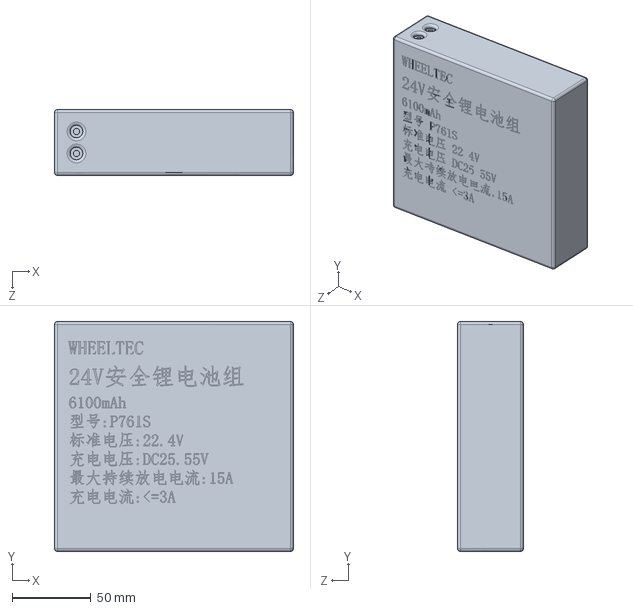
[picture p172: CAD file, 2024-02-03]
机械方面/供电部分/零件-电池-24V6100mAh磷酸铁锂电池P761S.SLDPRT
152.0 x 146.3 x 42.0 mm
