Tylenoler/Hyperion/机械方面/电机/零件-电机-稀土磁三相内转子57无刷电机.SLDPRT

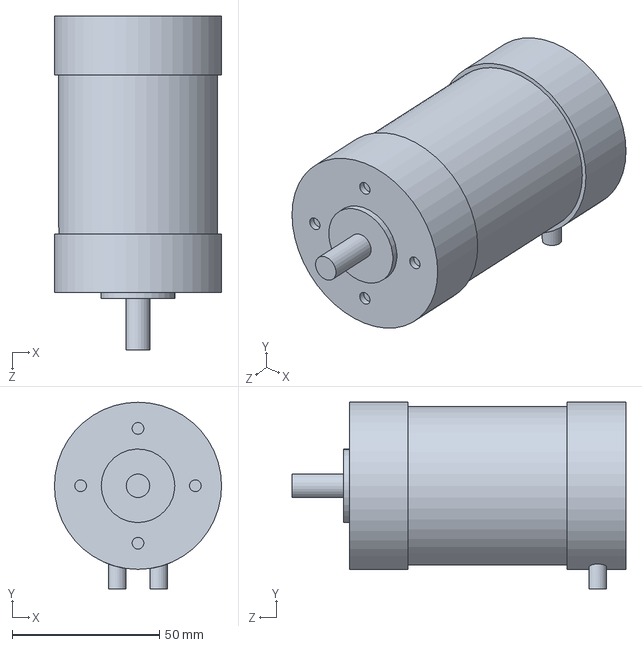
[picture p173: CAD file, 2024-02-05]
机械方面/电机/零件-电机-稀土磁三相内转子57无刷电机.SLDPRT
56.8 x 63.4 x 113.5 mm
