Tylenoler/Hyperion/机械方面/电气部分/emergency-stop-switch-2.snapshot.23/EMERGENCY-STOP.SLDPRT

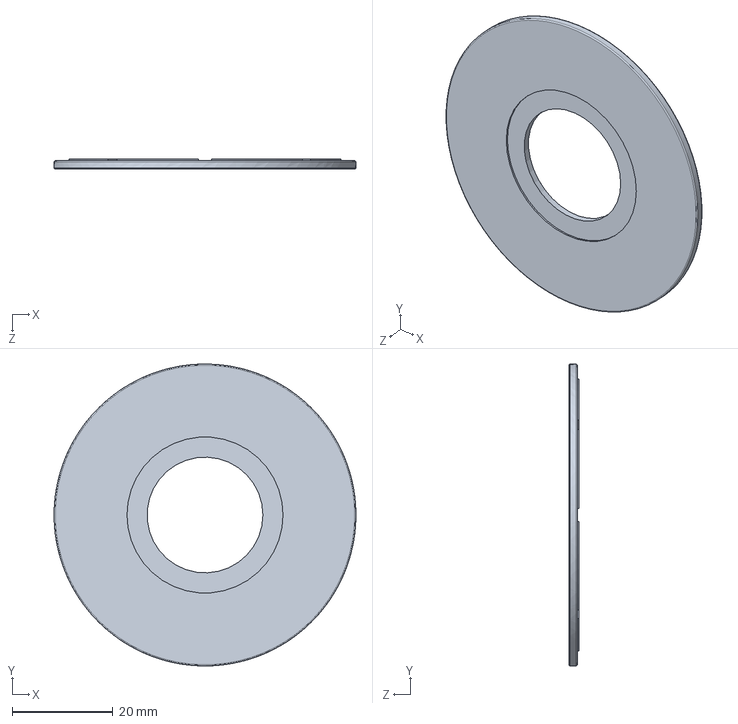
[picture p174: CAD file, 2024-02-10]
机械方面/电气部分/emergency-stop-switch-2.snapshot.23/EMERGENCY-STOP.SLDPRT
60.0 x 60.0 x 2.00 mm
