Tylenoler/Hyperion/机械方面/电气部分/rocker-switch-34.snapshot.8 (2)/Rocker Switch_Black.stp

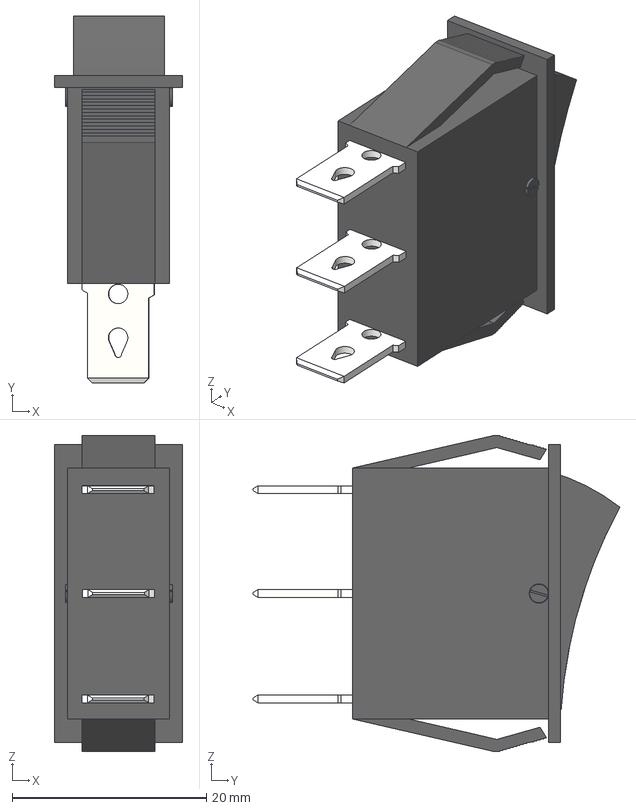
[picture p175: CAD file, 2024-02-10]
机械方面/电气部分/rocker-switch-34.snapshot.8 (2)/Rocker Switch_Black.stp
13.2 x 37.7 x 32.5 mm
Rocker Switch1
Rocker Switch2 x 3
Rocker Switch3_Black
