Tylenoler/Hyperion/机械方面/电气部分/零件-屏幕-淘晶驰X5系列 7寸IPS触摸屏 全视角显示屏.SLDPRT

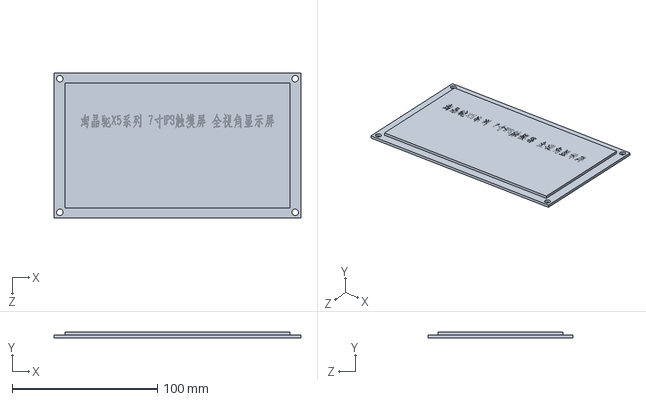
[picture p176: CAD file, 2024-02-18]
机械方面/电气部分/零件-屏幕-淘晶驰X5系列 7寸IPS触摸屏 全视角显示屏.SLDPRT
170.0 x 4.00 x 100.0 mm
