Tylenoler/Hyperion/机械方面/轮腿结构/零件-联轴器-6-56.8mm.SLDPRT

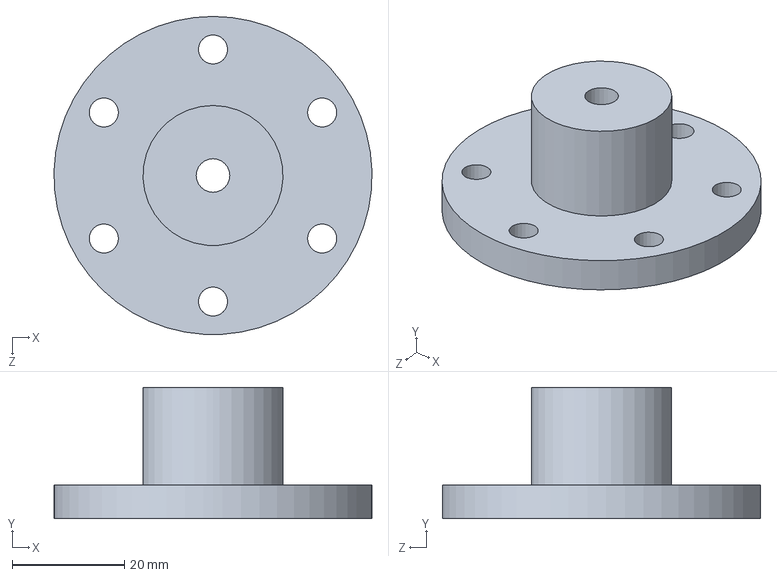
[picture p177: CAD file, 2024-02-28]
机械方面/轮腿结构/零件-联轴器-6-56.8mm.SLDPRT
56.8 x 23.4 x 56.8 mm
