Tylenoler/Hyperion/机械方面/轮腿结构/麦克纳姆轮组部分/Mecanum Final/Rollers-Axis.SLDPRT

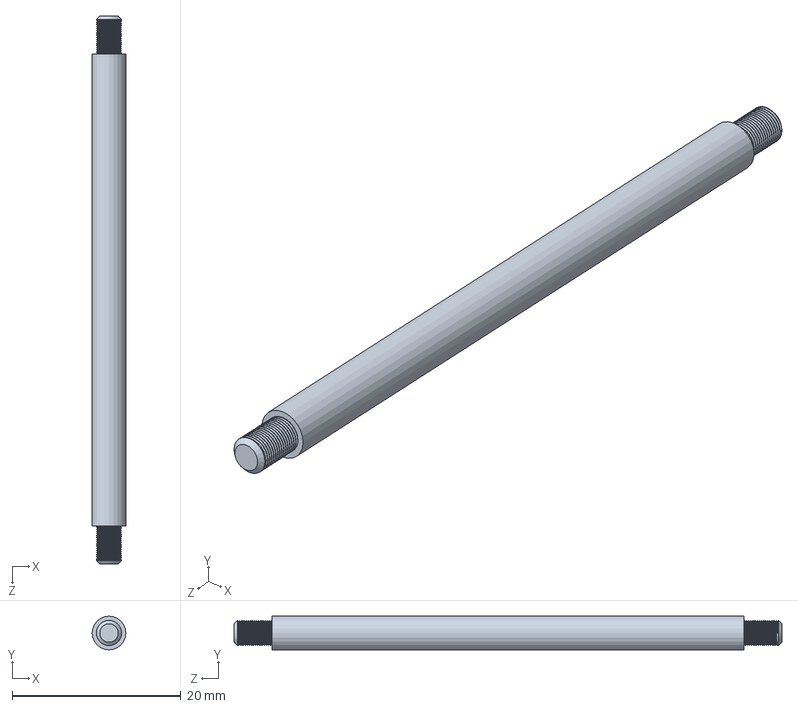
[picture p178: CAD file, 2024-02-08]
机械方面/轮腿结构/麦克纳姆轮组部分/Mecanum Final/Rollers-Axis.SLDPRT
4.00 x 4.00 x 65.0 mm
