Tylenoler/Hyperion/机械方面/主架部分/零件-车架-底部-后斜装甲板.SLDPRT

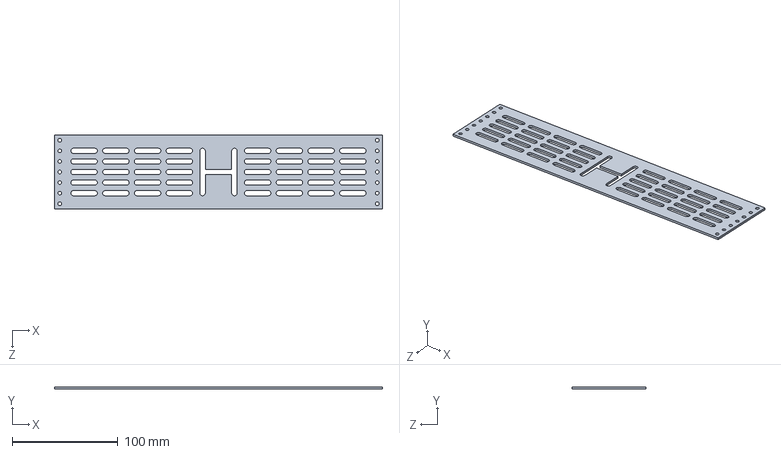
[picture p179: CAD file, 2024-02-28]
机械方面/主架部分/零件-车架-底部-后斜装甲板.SLDPRT
310.0 x 2.00 x 70.0 mm
