Tylenoler/Hyperion/机械方面/云台机构/yaw轴/轴承内圈加工.SLDPRT

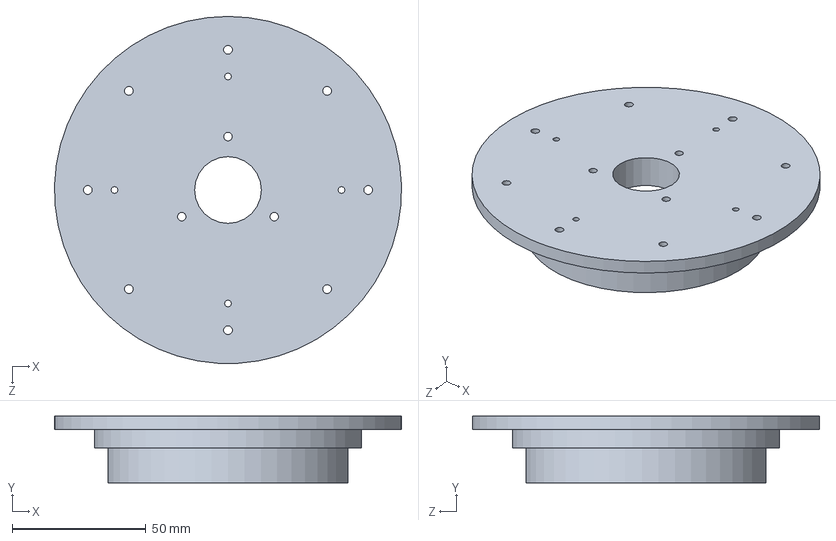
[picture p180: CAD file, 2024-02-18]
机械方面/云台机构/yaw轴/轴承内圈加工.SLDPRT
129.9 x 25.0 x 130.0 mm
