Tylenoler/Hyperion/机械方面/云台机构/发射机构(对抗赛通用单枪)/图传底板.SLDPRT

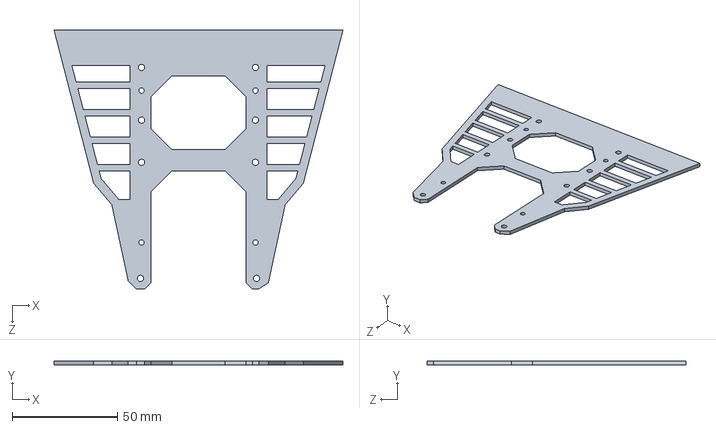
[picture p181: CAD file, 2024-02-28]
机械方面/云台机构/发射机构(对抗赛通用单枪)/图传底板.SLDPRT
137.0 x 2.00 x 122.7 mm
