Tylenoler/Hyperion/机械方面/云台机构/电气/NUC/M3×16铜柱-2.SLDPRT

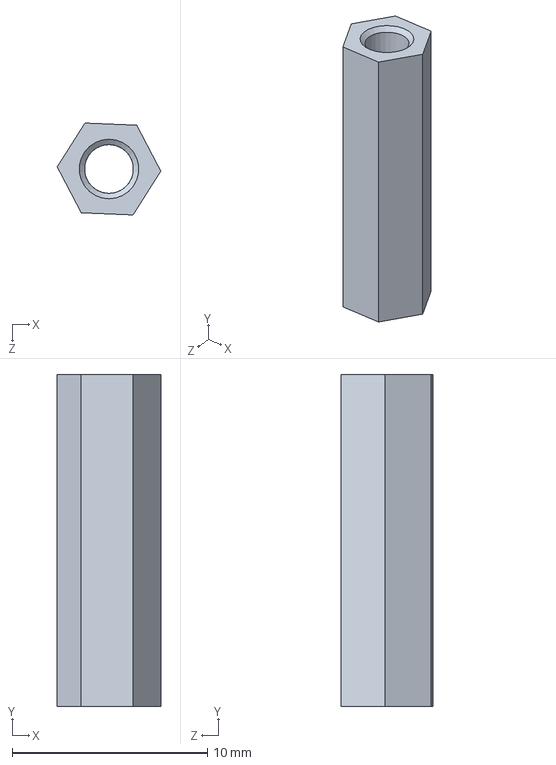
[picture p182: CAD file, 2024-02-10]
机械方面/云台机构/电气/NUC/M3×16铜柱-2.SLDPRT
5.31 x 17.0 x 4.71 mm
