Tylenoler/Hyperion/机械方面/供电部分/零件-电池-12V2600mAh安全电池E326S.SLDPRT

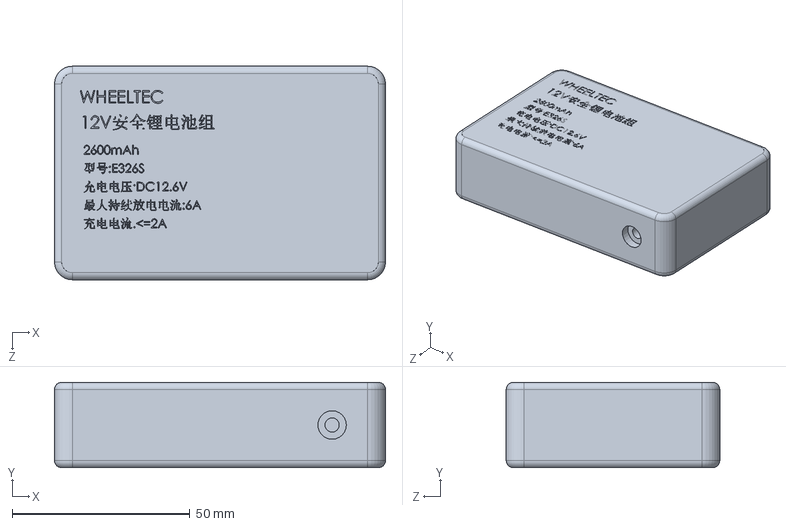
[picture p183: CAD file, 2024-02-03]
机械方面/供电部分/零件-电池-12V2600mAh安全电池E326S.SLDPRT
93.0 x 24.0 x 60.0 mm
