Tylenoler/Hyperion/机械方面/电气部分/emergency-stop-switch-2.snapshot.23/PORCA-CROMO.SLDPRT

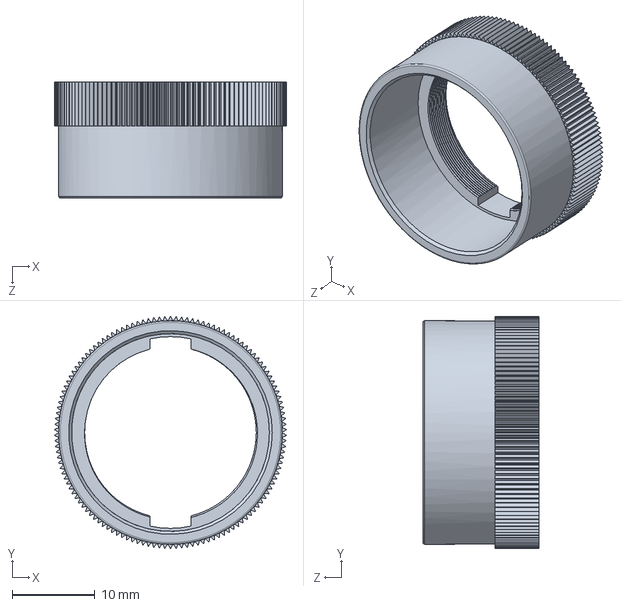
[picture p184: CAD file, 2024-02-10]
机械方面/电气部分/emergency-stop-switch-2.snapshot.23/PORCA-CROMO.SLDPRT
28.0 x 28.0 x 14.0 mm
