Tylenoler/Hyperion/机械方面/轮腿结构/麦克纳姆轮组部分/Mecanum Final/Rollers.SLDPRT

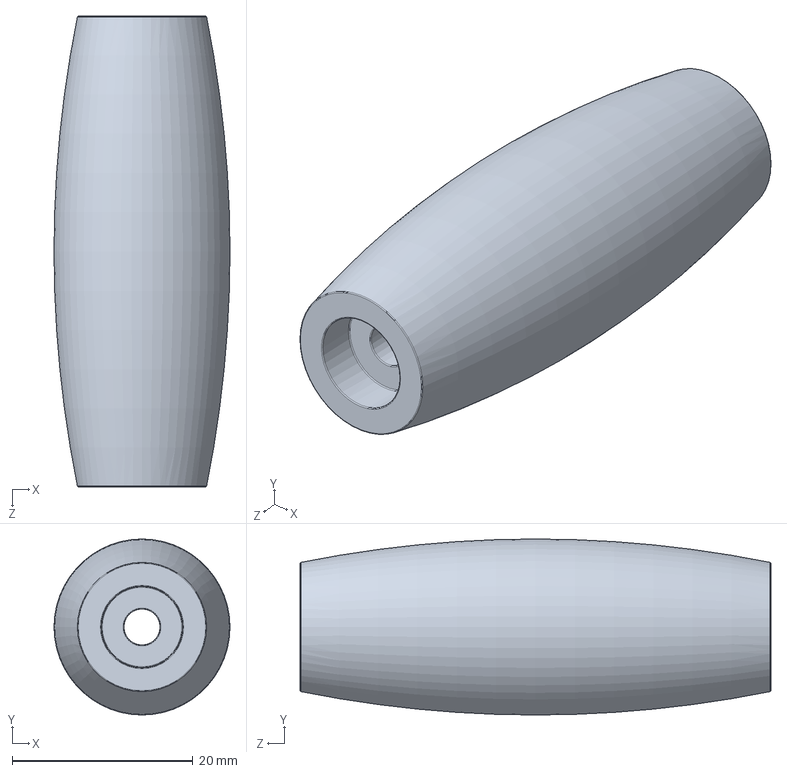
[picture p185: CAD file, 2024-02-08]
机械方面/轮腿结构/麦克纳姆轮组部分/Mecanum Final/Rollers.SLDPRT
19.4 x 19.4 x 52.0 mm
