Tylenoler/Hyperion/机械方面/轮腿结构/麦克纳姆轮组部分/麦克纳姆轮/148mm麦轮左.SLDPRT

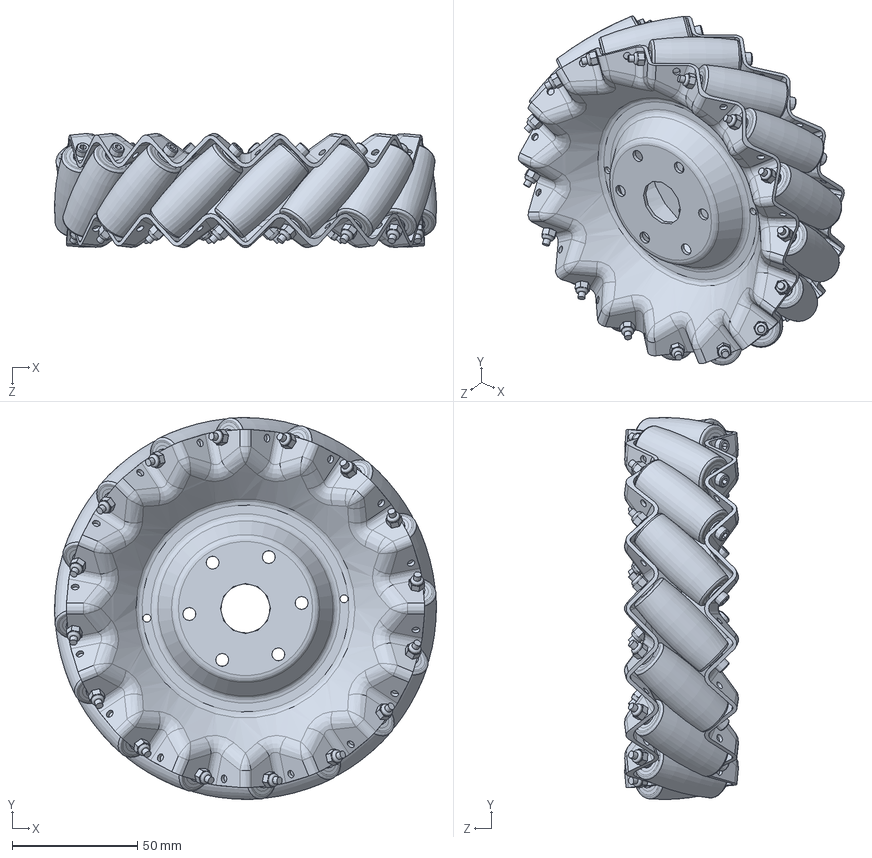
[picture p186: CAD file, 2024-02-06]
机械方面/轮腿结构/麦克纳姆轮组部分/麦克纳姆轮/148mm麦轮左.SLDPRT
152.4 x 152.4 x 45.5 mm
