Tylenoler/Hyperion/机械方面/主架部分/零件-车架-前后万向轮安装板.SLDPRT

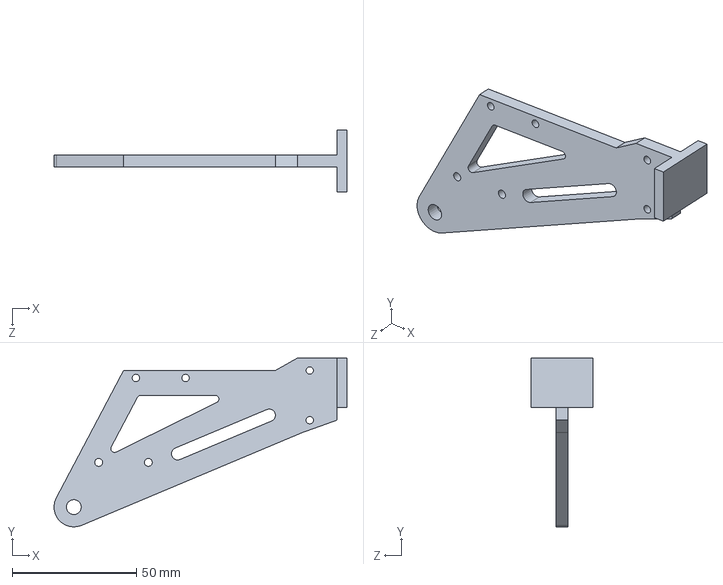
[picture p187: CAD file, 2024-02-28]
机械方面/主架部分/零件-车架-前后万向轮安装板.SLDPRT
118.0 x 68.0 x 25.0 mm
