Tylenoler/Hyperion/机械方面/云台机构/Pitch轴/零件-发射机构防护前板.SLDPRT

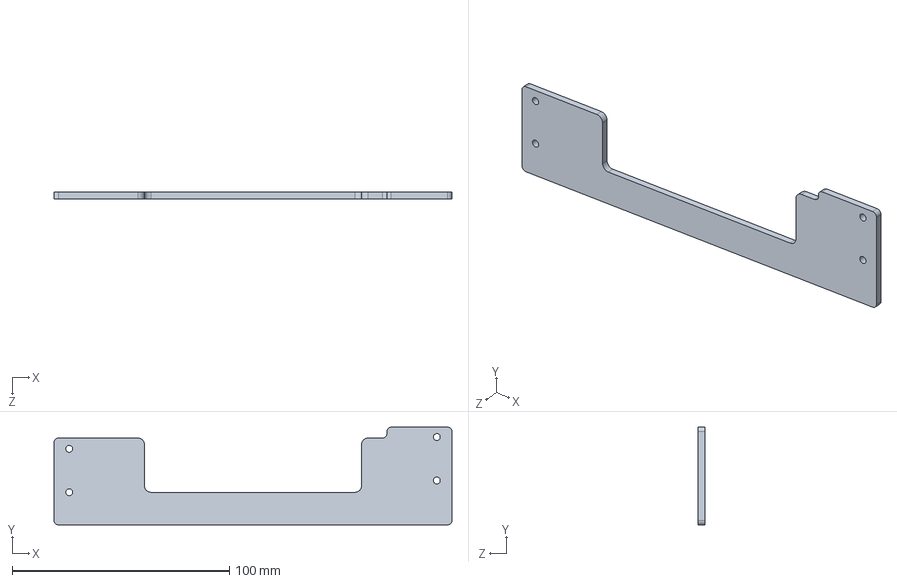
[picture p188: CAD file, 2024-02-18]
机械方面/云台机构/Pitch轴/零件-发射机构防护前板.SLDPRT
183.3 x 45.0 x 3.00 mm
