Tylenoler/Hyperion/机械方面/云台机构/yaw轴/GM6020 直流无刷电机.SLDPRT

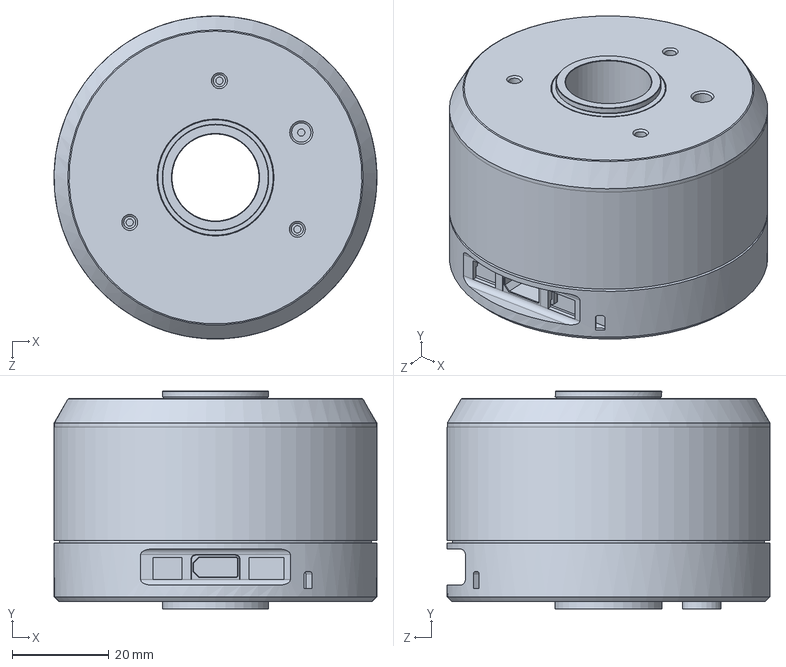
[picture p189: CAD file, 2024-02-10]
机械方面/云台机构/yaw轴/GM6020 直流无刷电机.SLDPRT
66.7 x 45.0 x 66.7 mm
