Tylenoler/Hyperion/机械方面/云台机构/发射机构(对抗赛通用单枪)/双枪步兵图传安装板.SLDPRT

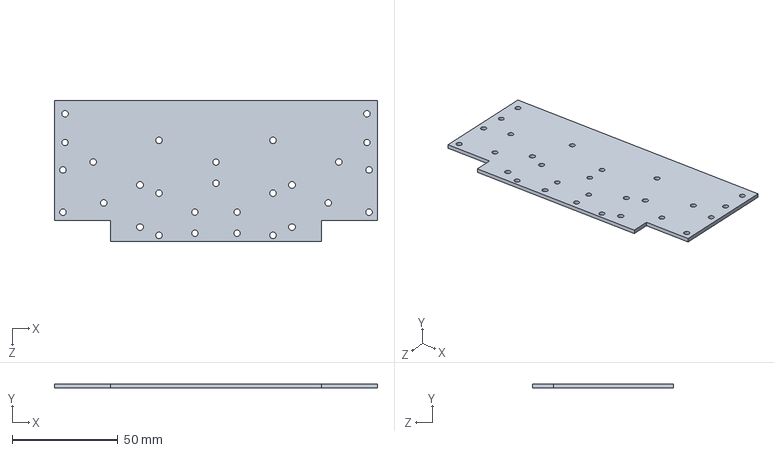
[picture p190: CAD file, 2024-02-28]
机械方面/云台机构/发射机构(对抗赛通用单枪)/双枪步兵图传安装板.SLDPRT
153.0 x 2.00 x 67.0 mm
