Tylenoler/Hyperion/机械方面/云台机构/发射机构/零件-测速模块.SLDPRT

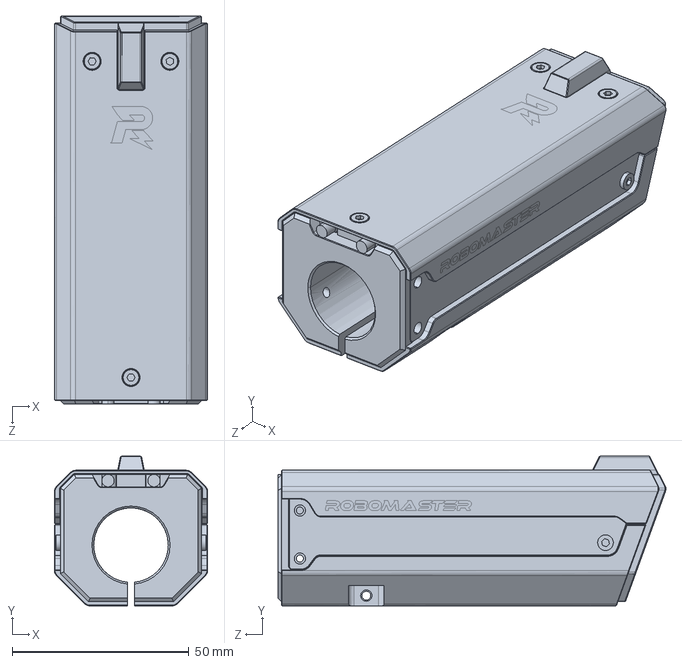
[picture p191: CAD file, 2024-02-18]
机械方面/云台机构/发射机构/零件-测速模块.SLDPRT
43.4 x 42.4 x 109.8 mm
