Tylenoler/Hyperion/机械方面/云台机构/电气/NUC/进风板-2.SLDPRT

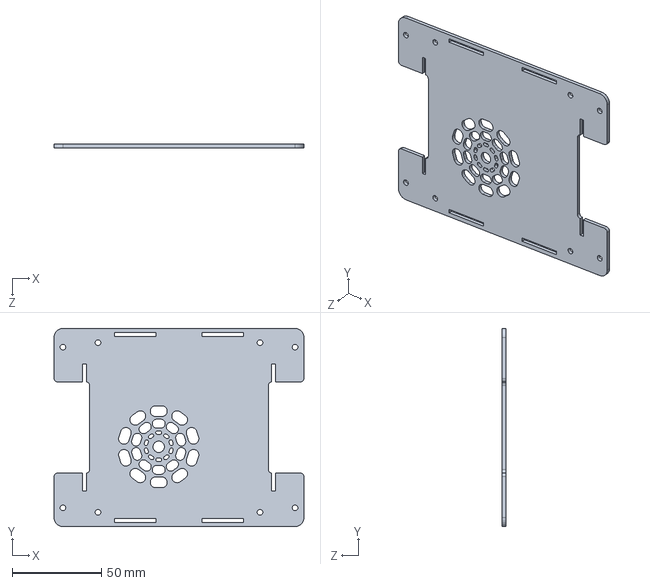
[picture p192: CAD file, 2024-02-10]
机械方面/云台机构/电气/NUC/进风板-2.SLDPRT
140.0 x 111.0 x 2.00 mm
