Tylenoler/Hyperion/机械方面/电气部分/零件-停止开关.STEP

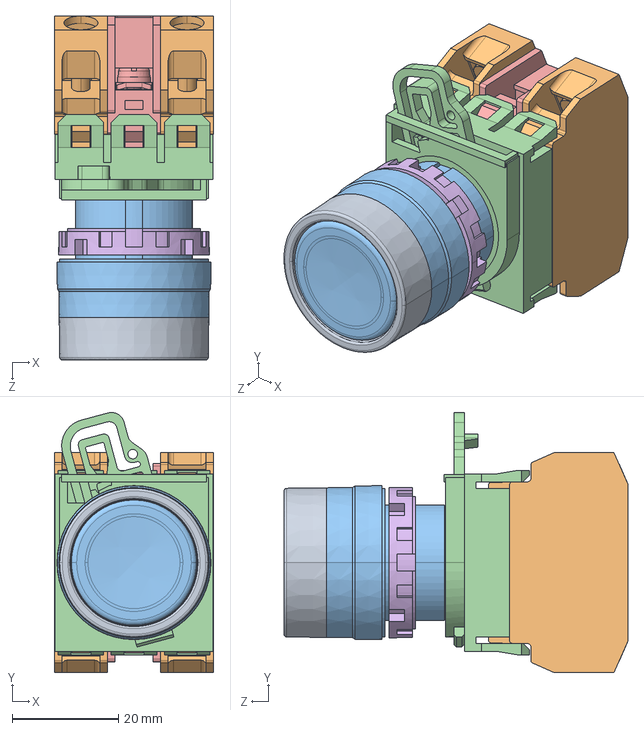
[picture p193: CAD file, 2024-02-10]
机械方面/电气部分/零件-停止开关.STEP
30.0 x 49.0 x 64.8 mm
