Tylenoler/Hyperion/机械方面/轮腿结构/麦克纳姆轮组部分/Mecanum Final/Spacer.SLDPRT

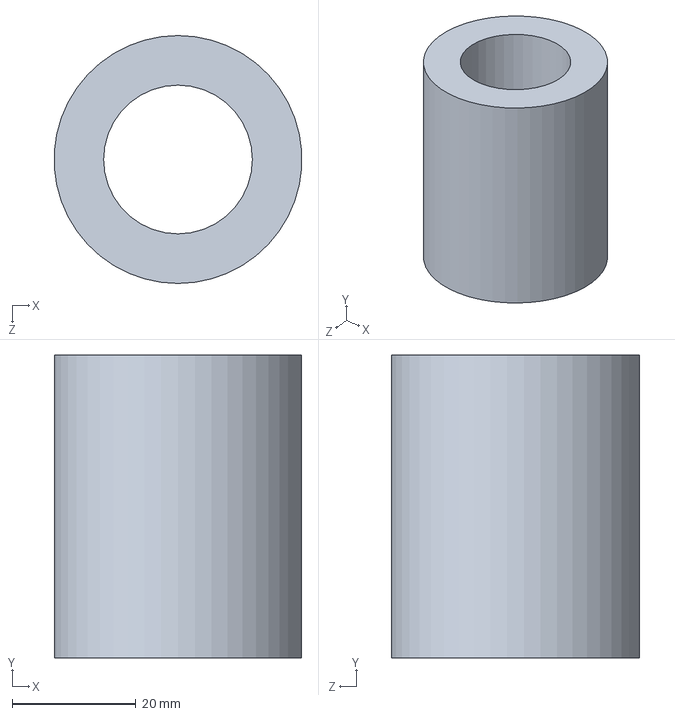
[picture p194: CAD file, 2024-02-08]
机械方面/轮腿结构/麦克纳姆轮组部分/Mecanum Final/Spacer.SLDPRT
39.9 x 48.9 x 40.0 mm
