Tylenoler/Hyperion/机械方面/云台机构/Pitch轴/零件-Yaw轴云台架底座.SLDPRT

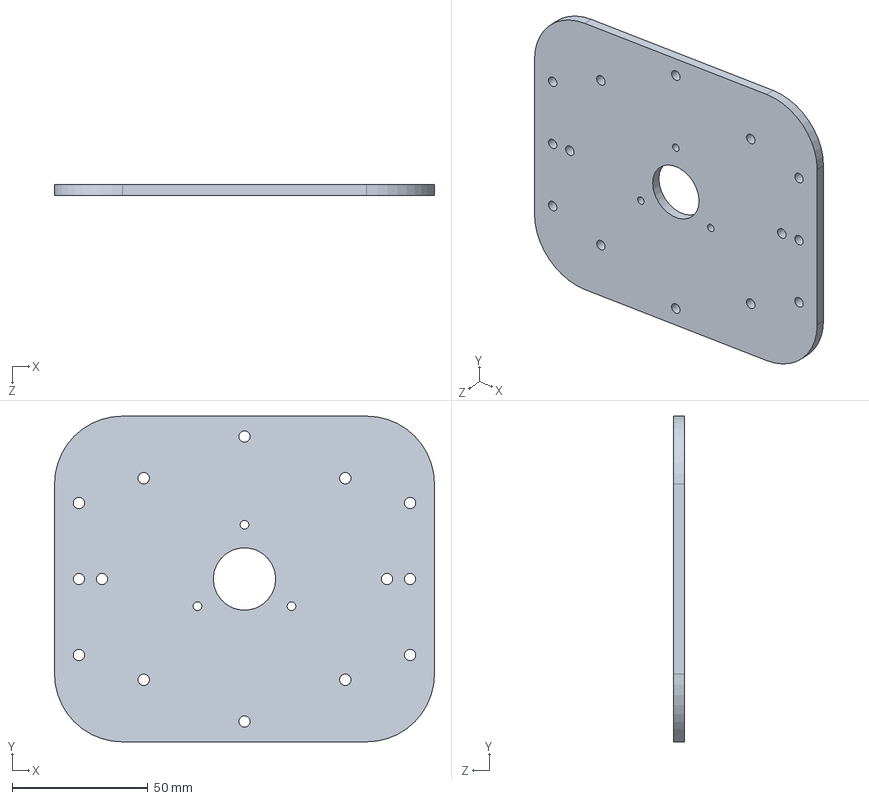
[picture p195: CAD file, 2024-02-10]
机械方面/云台机构/Pitch轴/零件-Yaw轴云台架底座.SLDPRT
140.0 x 120.0 x 4.00 mm
