Tylenoler/Hyperion/机械方面/云台机构/yaw轴/轴承内圈压片.SLDPRT

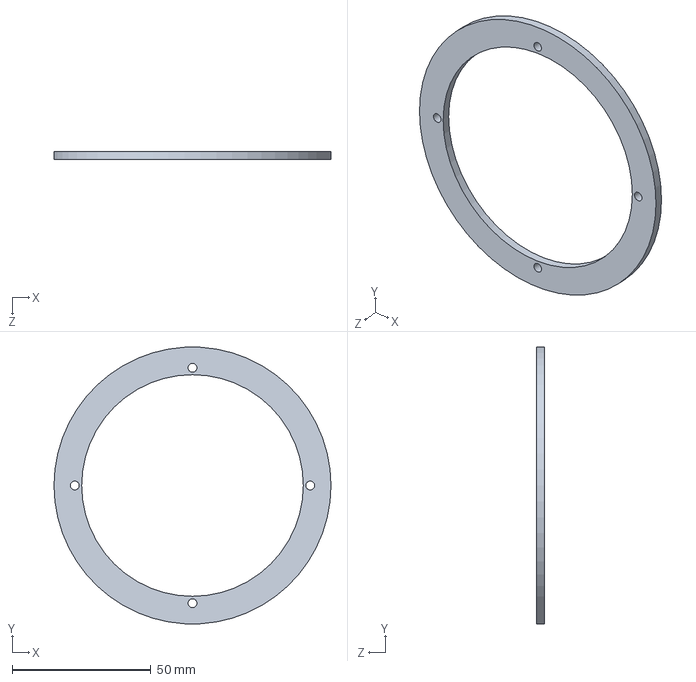
[picture p196: CAD file, 2024-02-10]
机械方面/云台机构/yaw轴/轴承内圈压片.SLDPRT
100.0 x 99.8 x 3.00 mm
