Tylenoler/Hyperion/机械方面/云台机构/发射机构(对抗赛通用单枪)/炮管接头.SLDPRT

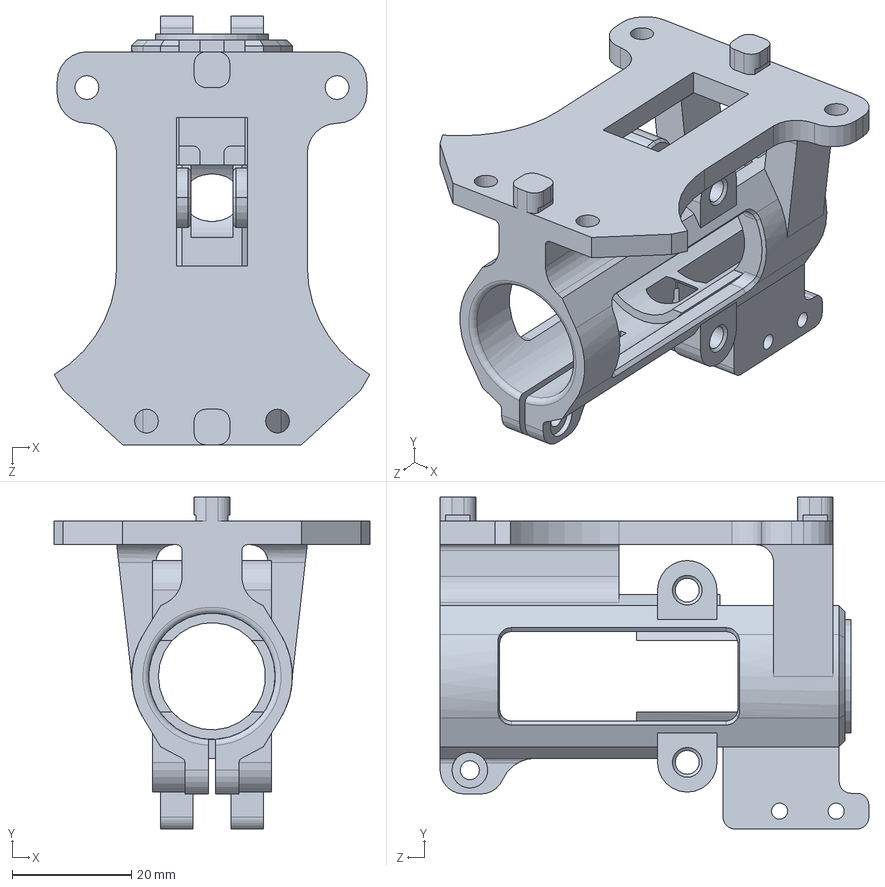
[picture p197: CAD file, 2024-02-18]
机械方面/云台机构/发射机构(对抗赛通用单枪)/炮管接头.SLDPRT
53.0 x 55.7 x 72.0 mm
