Tylenoler/Hyperion/机械方面/云台机构/发射机构/零件-拨盘连接板向后3mm.SLDPRT

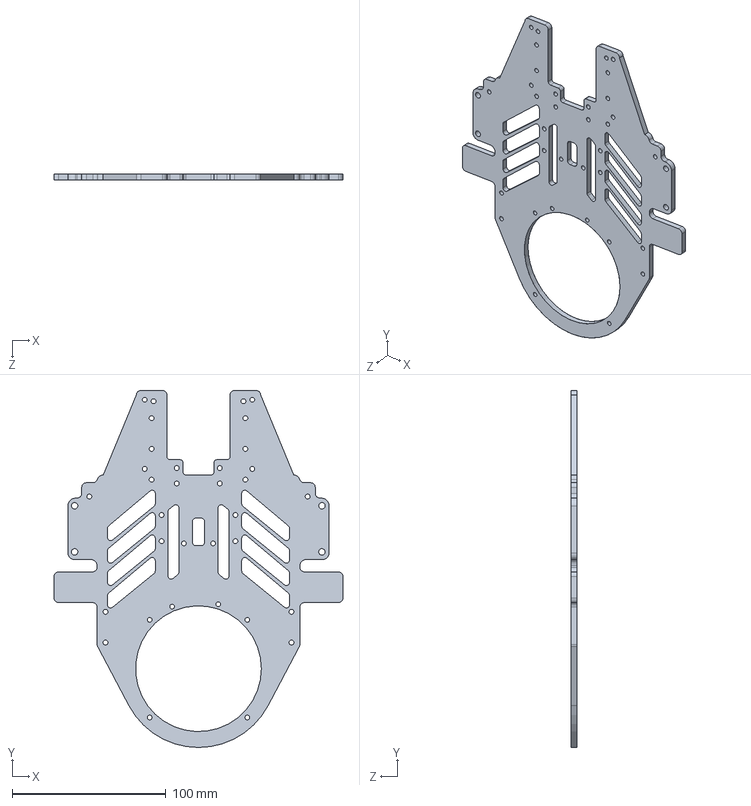
[picture p198: CAD file, 2024-02-18]
机械方面/云台机构/发射机构/零件-拨盘连接板向后3mm.SLDPRT
188.0 x 232.3 x 4.00 mm
