Tylenoler/Hyperion/机械方面/云台机构/电气/NUC/侧板-2.SLDPRT

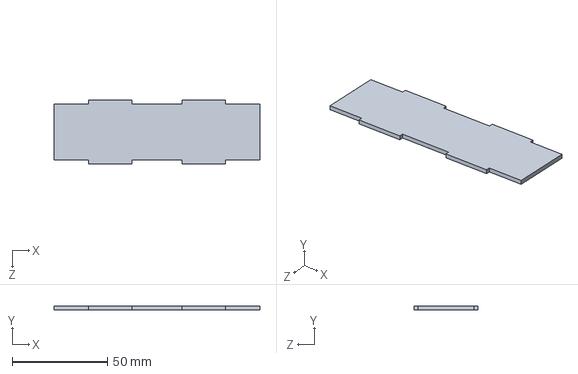
[picture p199: CAD file, 2024-02-10]
机械方面/云台机构/电气/NUC/侧板-2.SLDPRT
107.9 x 2.00 x 33.5 mm
