Tylenoler/Hyperion/机械方面/电气部分/零件-开关-施耐德急停开关.SLDPRT

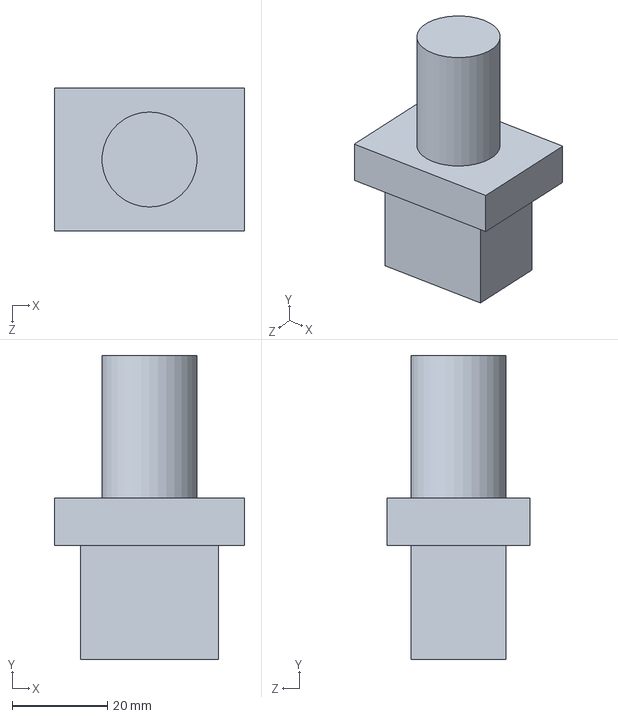
[picture p200: CAD file, 2024-02-10]
机械方面/电气部分/零件-开关-施耐德急停开关.SLDPRT
40.0 x 64.0 x 30.0 mm
