Tylenoler/Hyperion/机械方面/轮腿结构/零件-电机-12-24V空心杯转子钕强磁无刷电机.SLDPRT

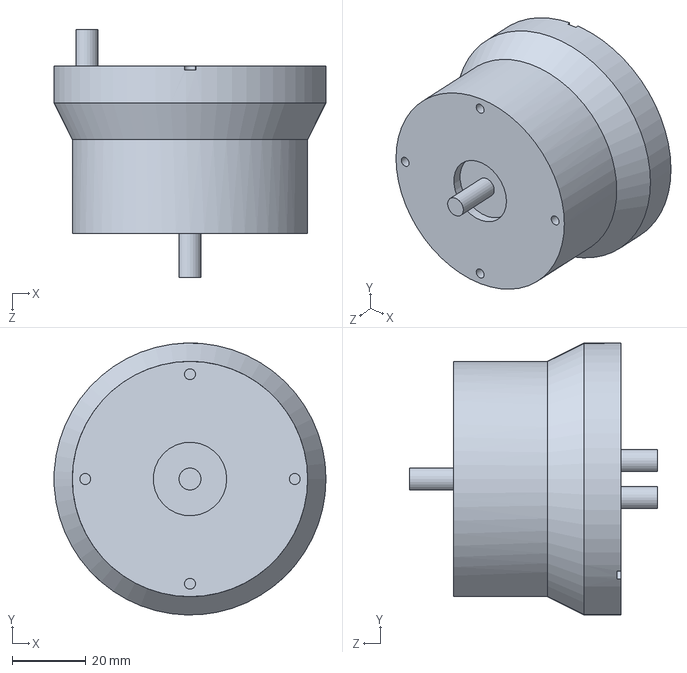
[picture p201: CAD file, 2024-02-28]
机械方面/轮腿结构/零件-电机-12-24V空心杯转子钕强磁无刷电机.SLDPRT
74.0 x 74.0 x 67.5 mm
