Tylenoler/Hyperion/机械方面/轮腿结构/麦克纳姆轮组部分/Mecanum Final/Mecanum Sneh plate.SLDPRT

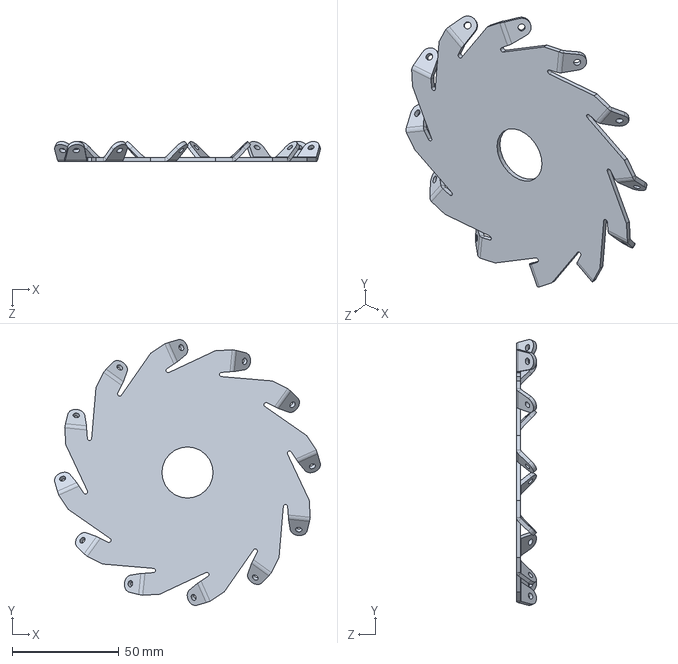
[picture p202: CAD file, 2024-02-08]
机械方面/轮腿结构/麦克纳姆轮组部分/Mecanum Final/Mecanum Sneh plate.SLDPRT
124.9 x 124.9 x 9.41 mm
