Tylenoler/Hyperion/机械方面/主架部分/零件-车架-底层-底板.SLDPRT

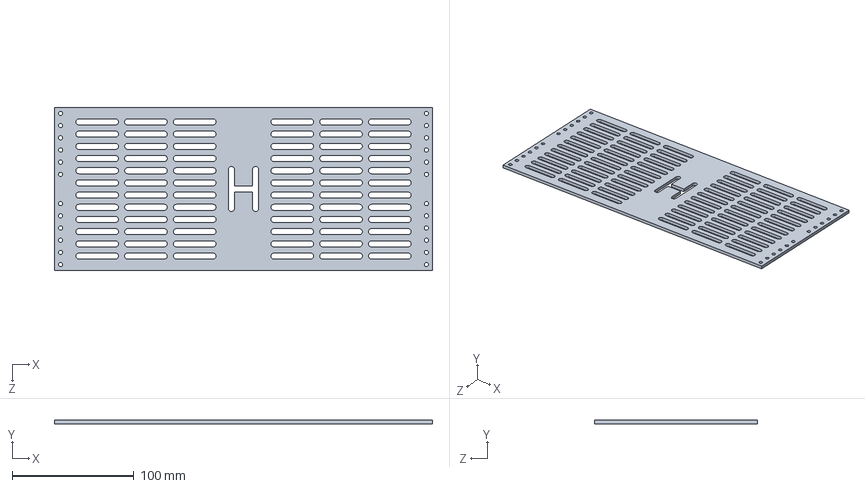
[picture p203: CAD file, 2024-02-28]
机械方面/主架部分/零件-车架-底层-底板.SLDPRT
310.0 x 3.00 x 134.0 mm
