Tylenoler/Hyperion/机械方面/云台机构/Pitch轴/零件-Pitch转轴转接-2.SLDPRT

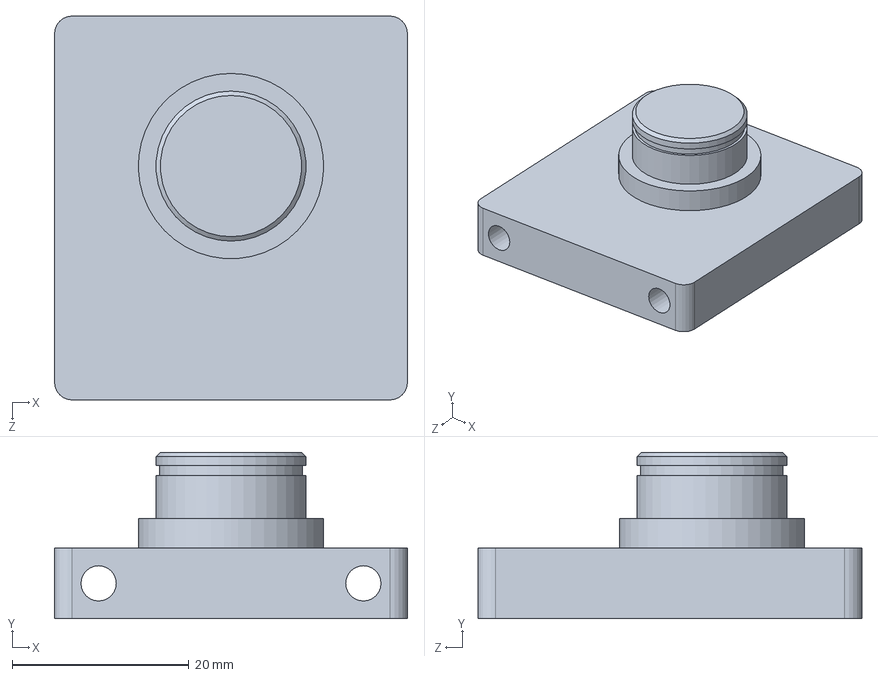
[picture p204: CAD file, 2024-02-10]
机械方面/云台机构/Pitch轴/零件-Pitch转轴转接-2.SLDPRT
40.0 x 18.9 x 43.5 mm
