Tylenoler/Hyperion/机械方面/云台机构/yaw轴/轴承外圈压片.SLDPRT

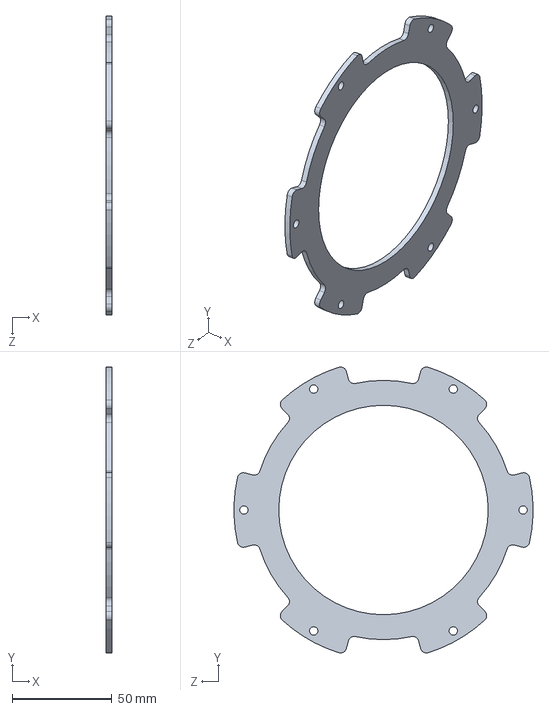
[picture p205: CAD file, 2024-02-10]
机械方面/云台机构/yaw轴/轴承外圈压片.SLDPRT
3.00 x 143.4 x 149.9 mm
