Tylenoler/Hyperion/机械方面/云台机构/发射机构(对抗赛通用单枪)/2006 v1（拨弹轮）.SLDPRT

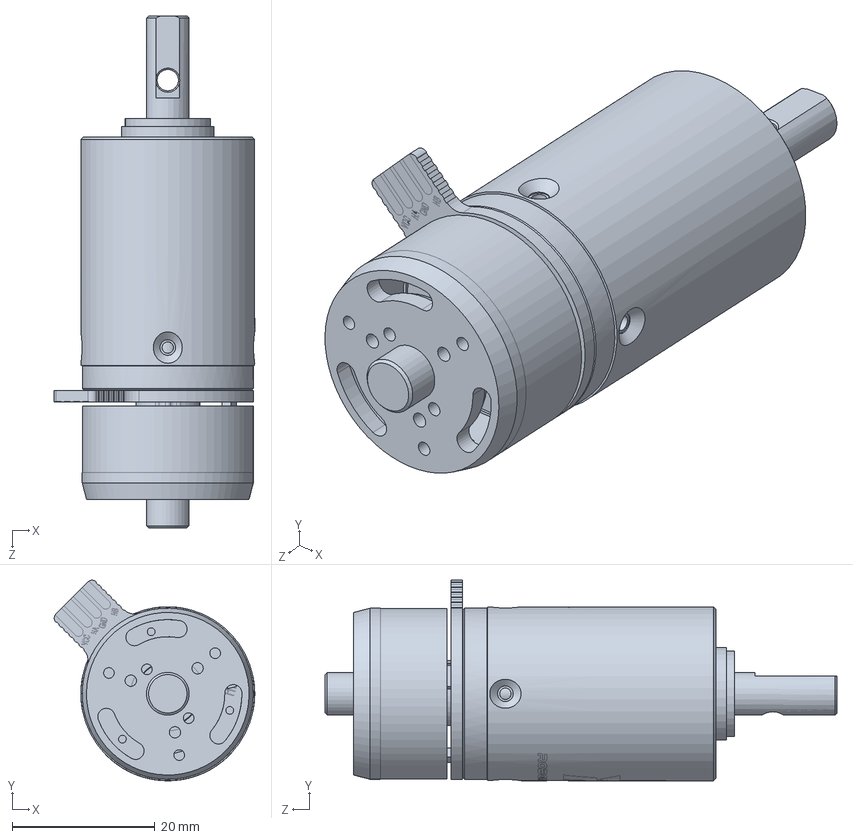
[picture p206: CAD file, 2024-02-18]
机械方面/云台机构/发射机构(对抗赛通用单枪)/2006 v1（拨弹轮）.SLDPRT
28.1 x 28.1 x 71.8 mm
