Tylenoler/Hyperion/机械方面/云台机构/发射机构/零件-转接件.SLDPRT

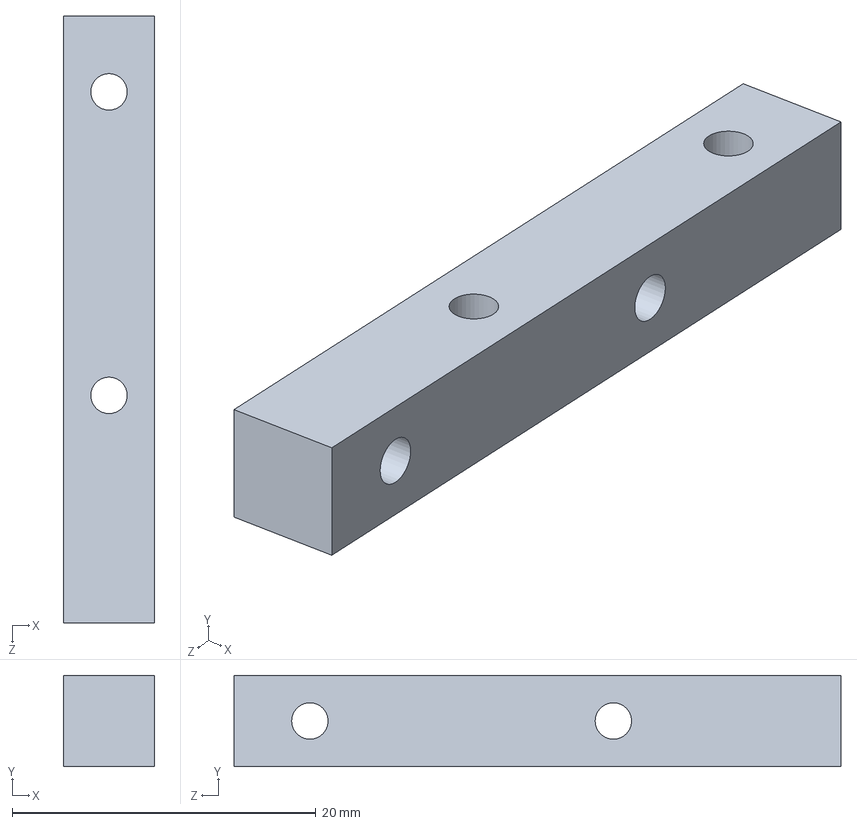
[picture p207: CAD file, 2024-02-10]
机械方面/云台机构/发射机构/零件-转接件.SLDPRT
6.00 x 6.00 x 40.0 mm
