Tylenoler/Hyperion/机械方面/云台机构/电气/NUC/M3×10铜柱-2.SLDPRT

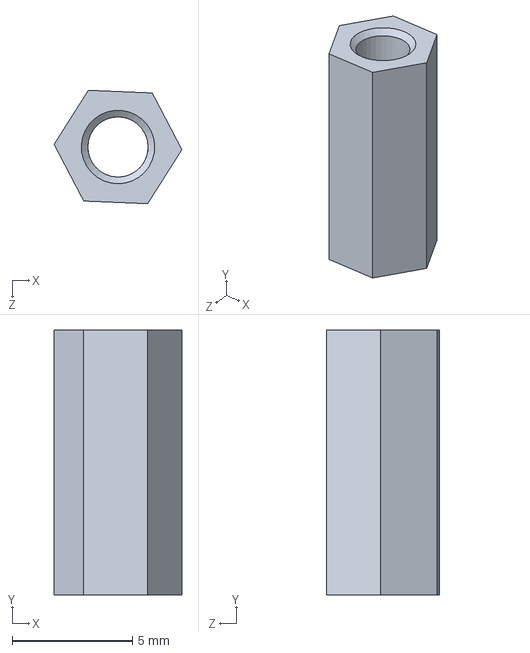
[picture p208: CAD file, 2024-02-10]
机械方面/云台机构/电气/NUC/M3×10铜柱-2.SLDPRT
5.31 x 11.0 x 4.71 mm
