Tylenoler/Hyperion/机械方面/电气部分/零件-屏幕-陶晶驰T1系列4.3寸串口屏.SLDPRT

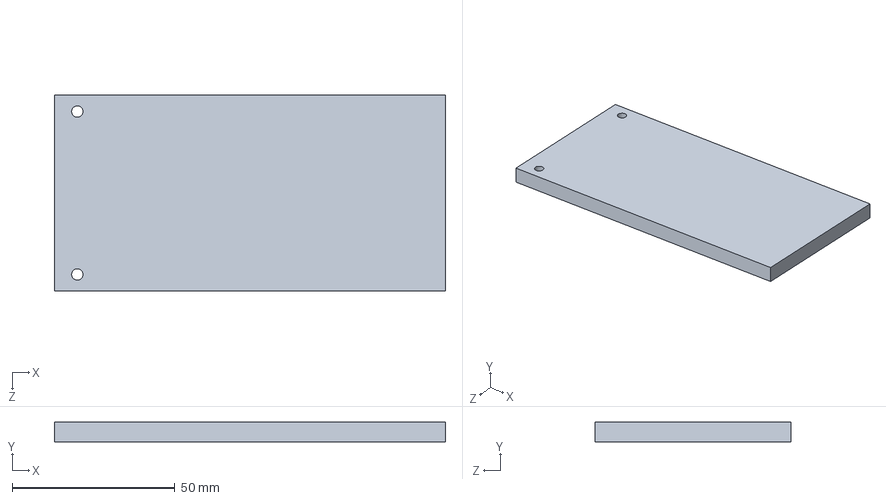
[picture p209: CAD file, 2024-02-10]
机械方面/电气部分/零件-屏幕-陶晶驰T1系列4.3寸串口屏.SLDPRT
120.0 x 6.00 x 60.0 mm
