Tylenoler/Hyperion/机械方面/轮腿结构/麦克纳姆轮组部分/零件-8mm Flanged Shaft Coupler.step

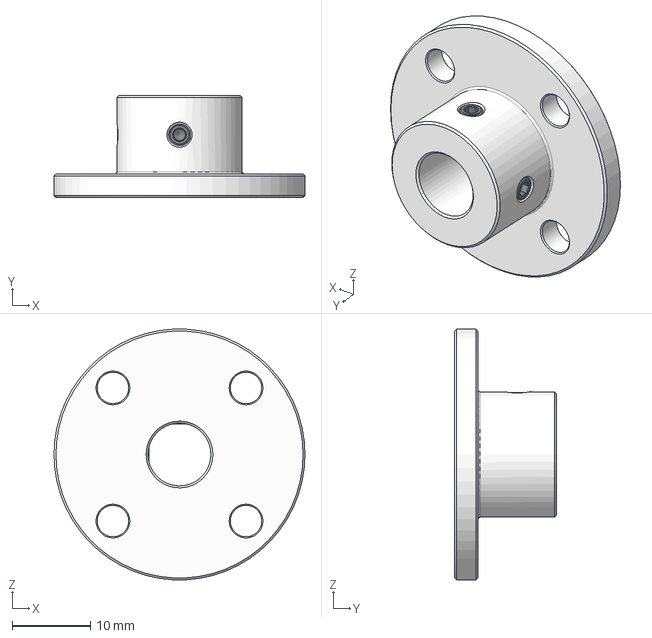
[picture p210: CAD file, 2024-02-06]
机械方面/轮腿结构/麦克纳姆轮组部分/零件-8mm Flanged Shaft Coupler.step
32.0 x 13.0 x 32.0 mm
M3 x 4 Set Screw x 2
