Tylenoler/Hyperion/机械方面/主架部分/零件-车架-快装板20X350.SLDPRT

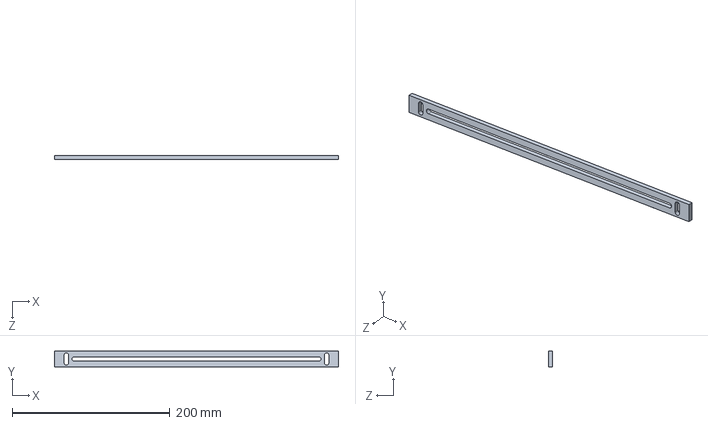
[picture p211: CAD file, 2024-02-28]
机械方面/主架部分/零件-车架-快装板20X350.SLDPRT
360.0 x 20.0 x 5.00 mm
