Tylenoler/Hyperion/机械方面/云台机构/Pitch轴/零件-法兰轴承 17x26x5-2.SLDPRT

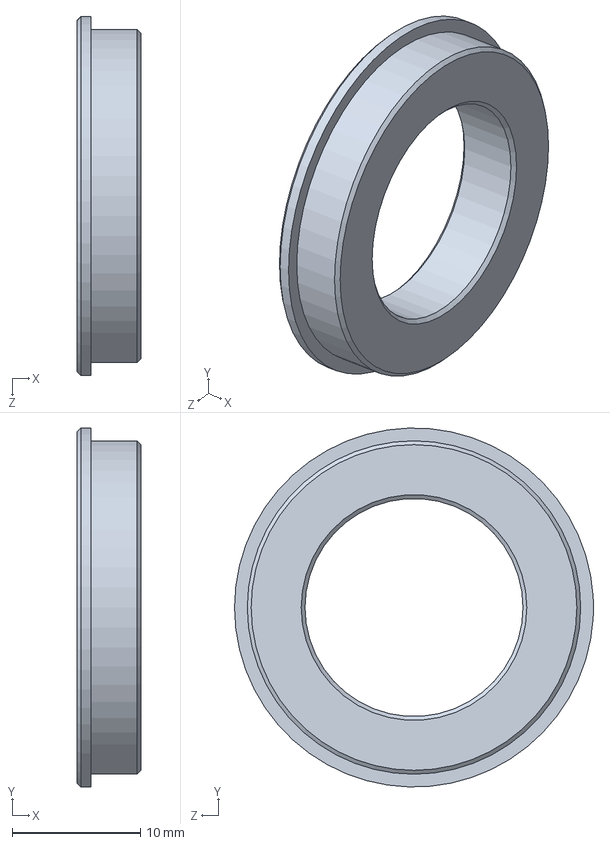
[picture p212: CAD file, 2024-02-10]
机械方面/云台机构/Pitch轴/零件-法兰轴承 17x26x5-2.SLDPRT
5.00 x 28.0 x 28.0 mm
