Tylenoler/Hyperion/机械方面/云台机构/yaw轴/M4防松螺母.SLDPRT

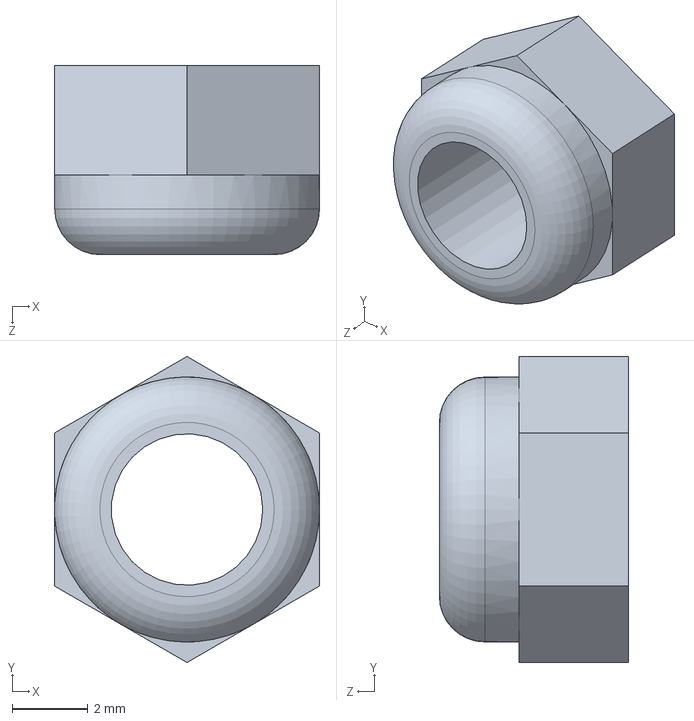
[picture p213: CAD file, 2024-02-10]
机械方面/云台机构/yaw轴/M4防松螺母.SLDPRT
7.00 x 8.08 x 5.00 mm
