Tylenoler/Hyperion/机械方面/云台机构/发射机构(对抗赛通用单枪)/C板包覆钣金件.SLDPRT

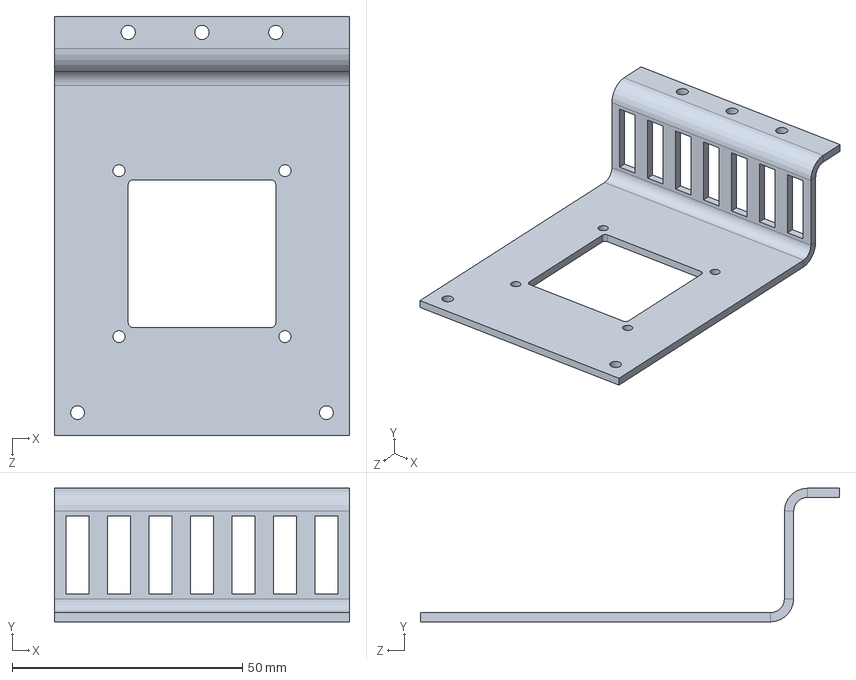
[picture p214: CAD file, 2024-02-18]
机械方面/云台机构/发射机构(对抗赛通用单枪)/C板包覆钣金件.SLDPRT
64.0 x 29.0 x 91.0 mm
