Tylenoler/Hyperion/机械方面/云台机构/发射机构/零件-RoboMaster M3508直流无刷减速电机.SLDPRT

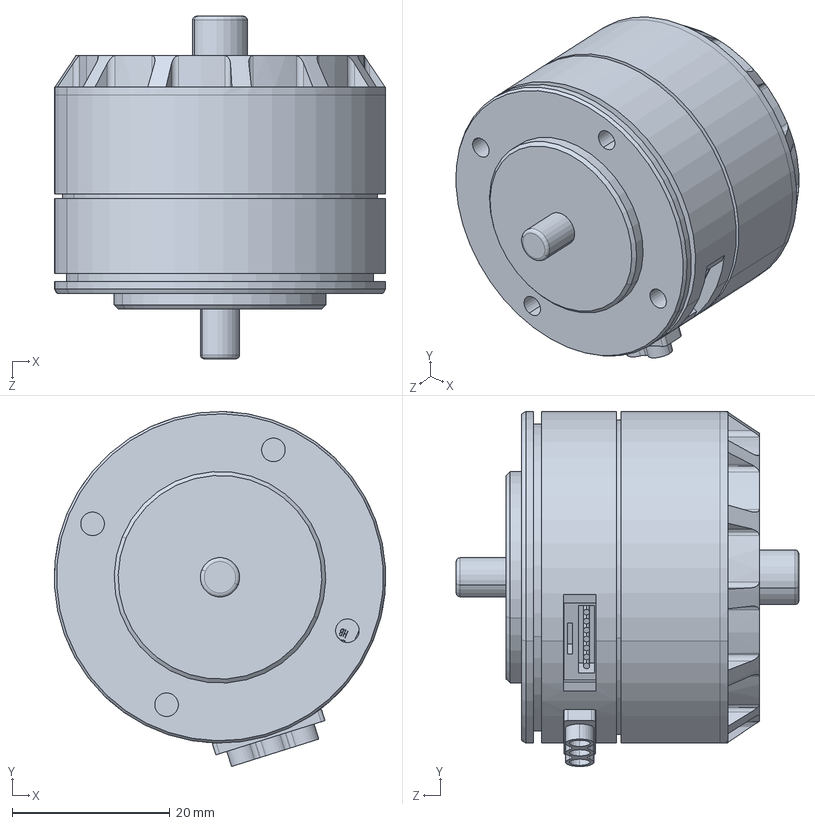
[picture p215: CAD file, 2024-02-10]
机械方面/云台机构/发射机构/零件-RoboMaster M3508直流无刷减速电机.SLDPRT
41.9 x 45.0 x 43.4 mm
