Tylenoler/Hyperion/机械方面/云台机构/电气/NUC/安装板-2.SLDPRT

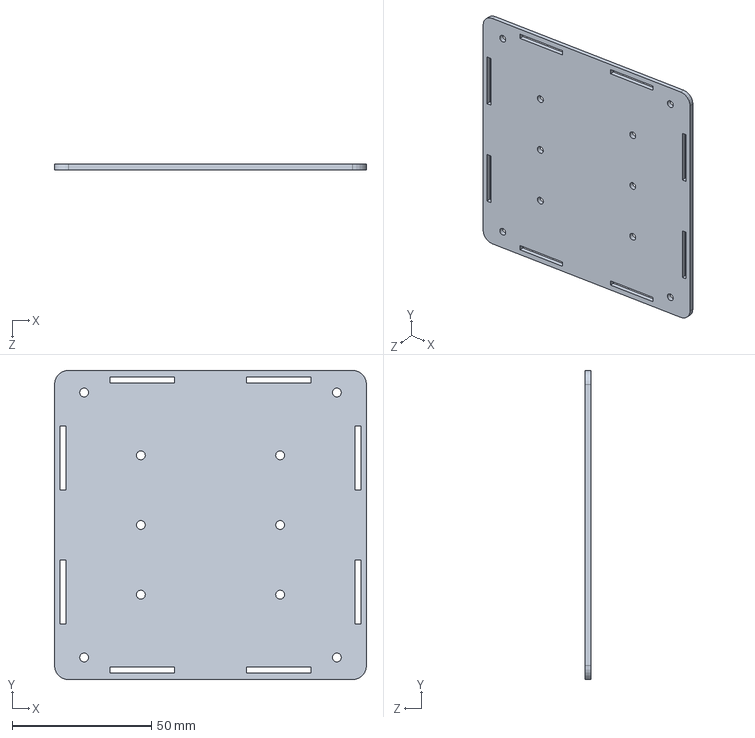
[picture p216: CAD file, 2024-02-10]
机械方面/云台机构/电气/NUC/安装板-2.SLDPRT
112.0 x 111.0 x 2.00 mm
