Tylenoler/Hyperion/机械方面/电气部分/emergency-stop-switch-2.snapshot.23/ANEL RETAINER.SLDPRT

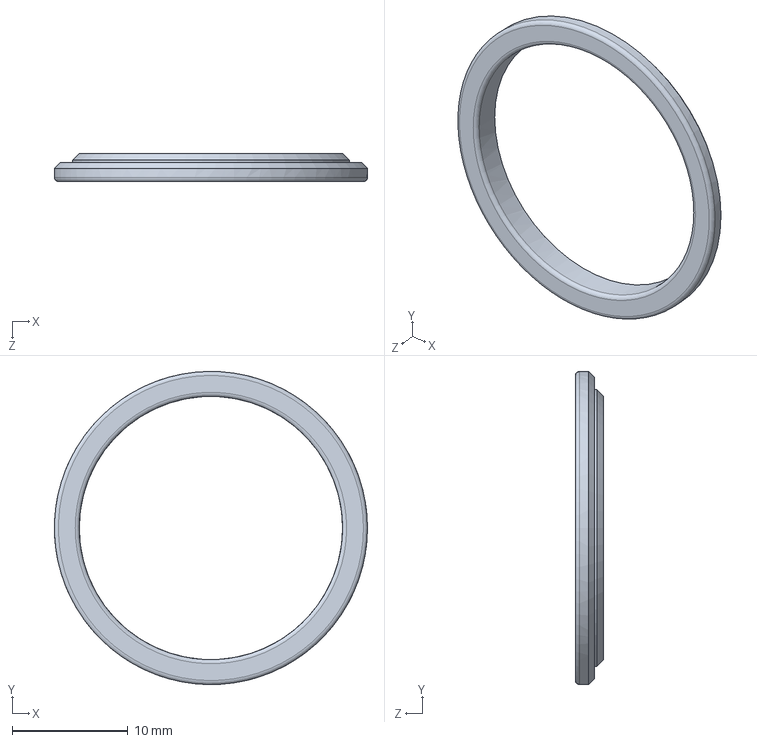
[picture p217: CAD file, 2024-02-10]
机械方面/电气部分/emergency-stop-switch-2.snapshot.23/ANEL RETAINER.SLDPRT
27.0 x 27.0 x 2.45 mm
