Tylenoler/Hyperion/机械方面/轮腿结构/零件-leg-wheel.SLDPRT

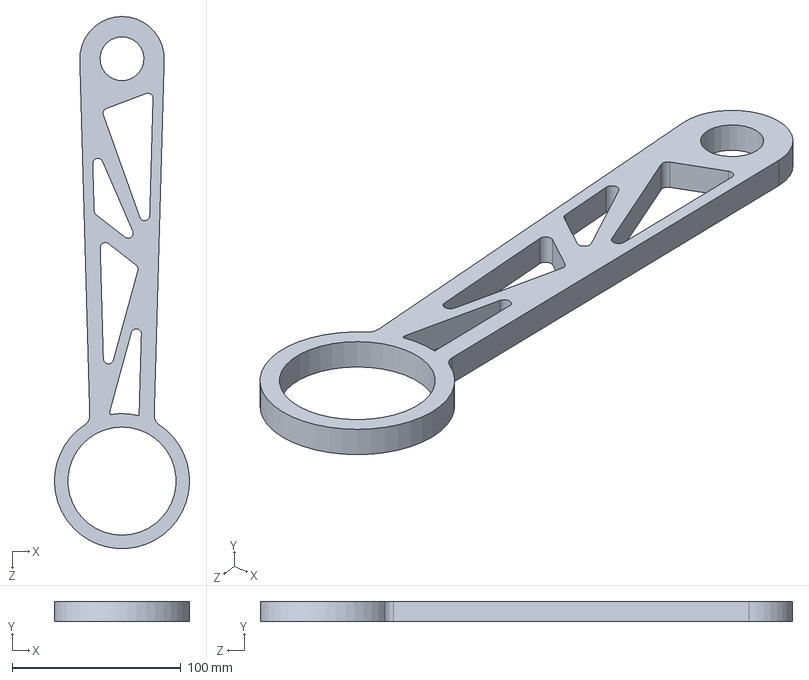
[picture p218: CAD file, 2024-02-18]
机械方面/轮腿结构/零件-leg-wheel.SLDPRT
80.0 x 12.0 x 314.9 mm
