Tylenoler/Hyperion/机械方面/主架部分/零件-车架-后装甲板-左.SLDPRT

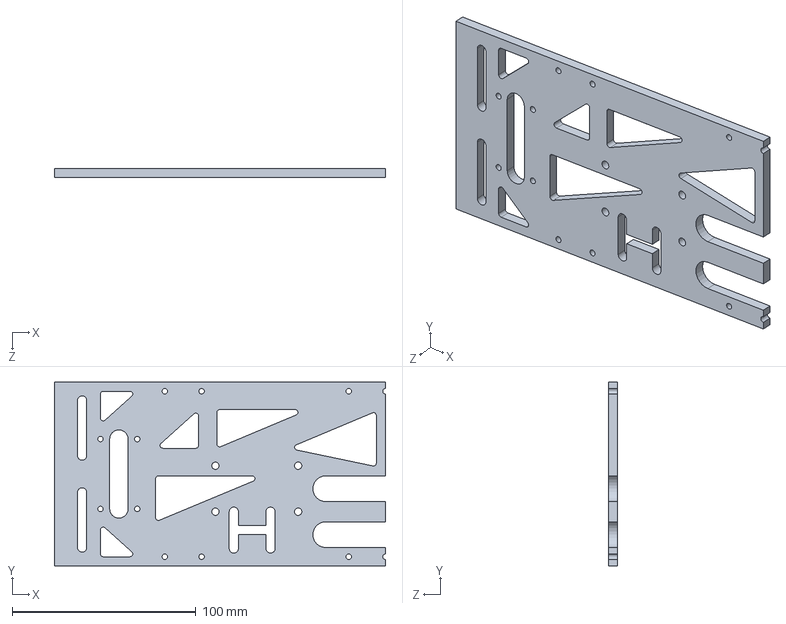
[picture p219: CAD file, 2024-02-28]
机械方面/主架部分/零件-车架-后装甲板-左.SLDPRT
180.0 x 100.0 x 5.00 mm
