Tylenoler/Hyperion/机械方面/云台机构/Pitch轴/零件-NUC上固定板.SLDPRT

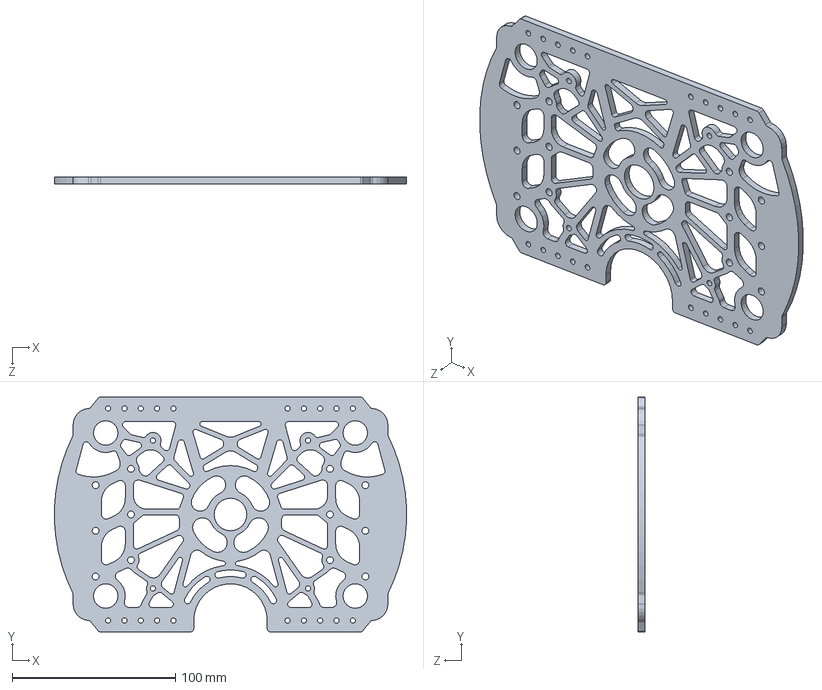
[picture p220: CAD file, 2024-02-10]
机械方面/云台机构/Pitch轴/零件-NUC上固定板.SLDPRT
215.8 x 144.0 x 4.00 mm
