Tylenoler/Hyperion/机械方面/云台机构/yaw轴/6818轴承.SLDPRT

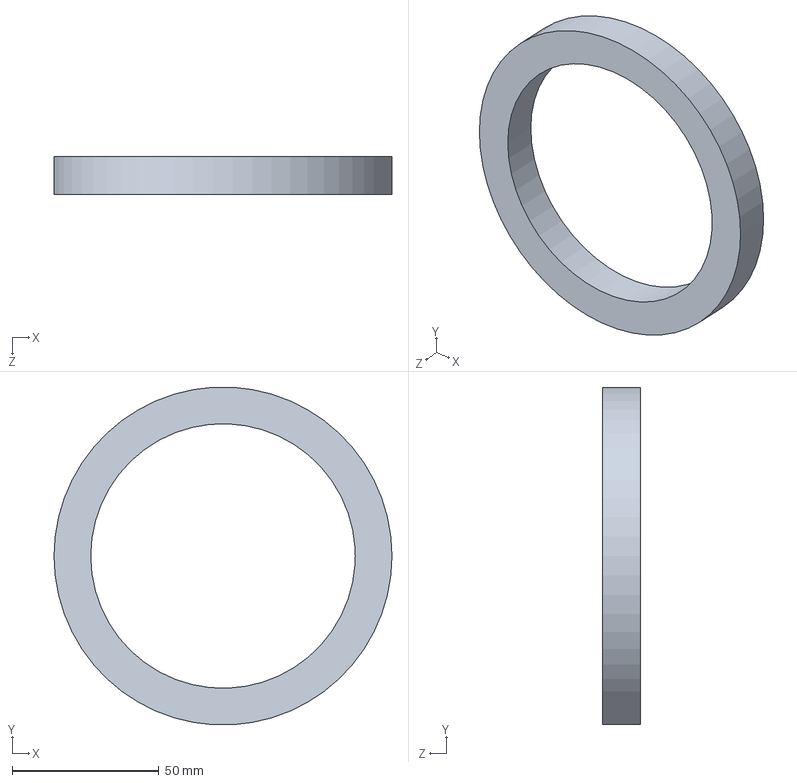
[picture p221: CAD file, 2024-02-10]
机械方面/云台机构/yaw轴/6818轴承.SLDPRT
115.0 x 114.8 x 13.0 mm
