Tylenoler/Hyperion/机械方面/云台机构/发射机构/零件-摩擦轮60mm.SLDPRT

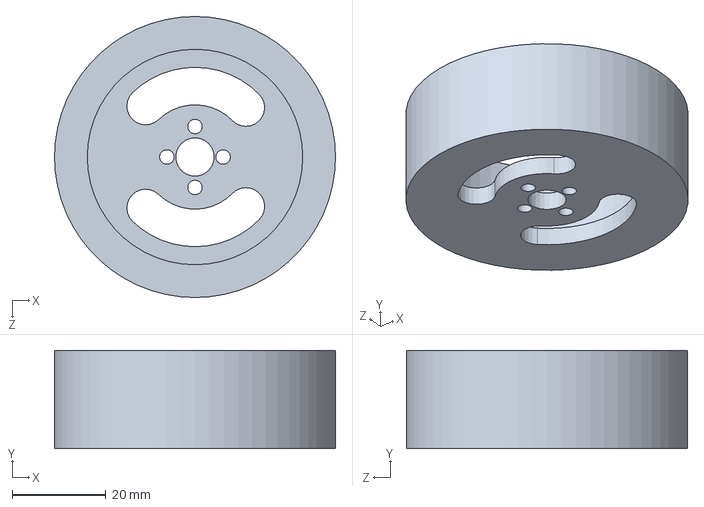
[picture p223: CAD file, 2024-02-10]
机械方面/云台机构/发射机构/零件-摩擦轮60mm.SLDPRT
60.0 x 21.0 x 60.0 mm
