Tylenoler/Hyperion/机械方面/云台机构/电气/NUC/通风板-2.SLDPRT

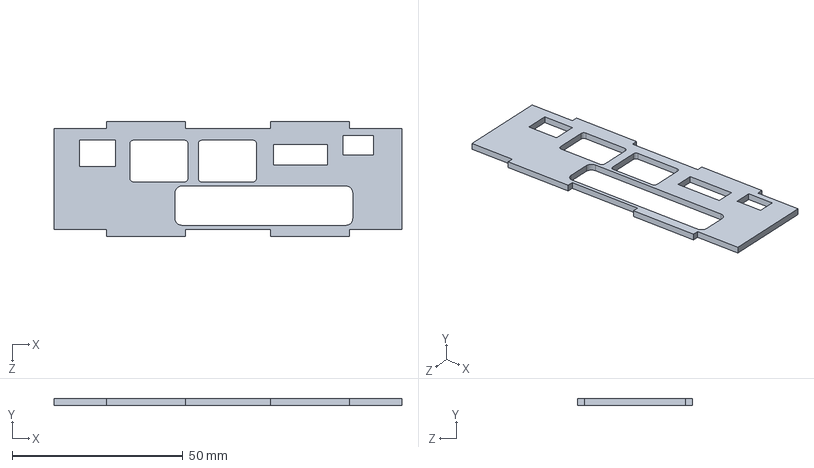
[picture p224: CAD file, 2024-02-10]
机械方面/云台机构/电气/NUC/通风板-2.SLDPRT
101.8 x 2.00 x 33.5 mm
