Tylenoler/Hyperion/机械方面/电气部分/emergency-stop-switch-2.snapshot.23/COVER-VERDE.SLDPRT

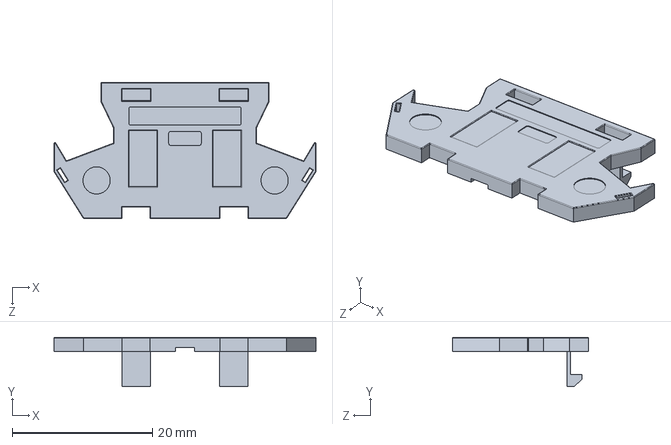
[picture p225: CAD file, 2024-02-10]
机械方面/电气部分/emergency-stop-switch-2.snapshot.23/COVER-VERDE.SLDPRT
37.4 x 7.00 x 19.4 mm
