Tylenoler/Hyperion/机械方面/电气部分/零件-屏幕-微雪LED点阵显示屏RGB-Matrix-P2.5-64x64.SLDPRT

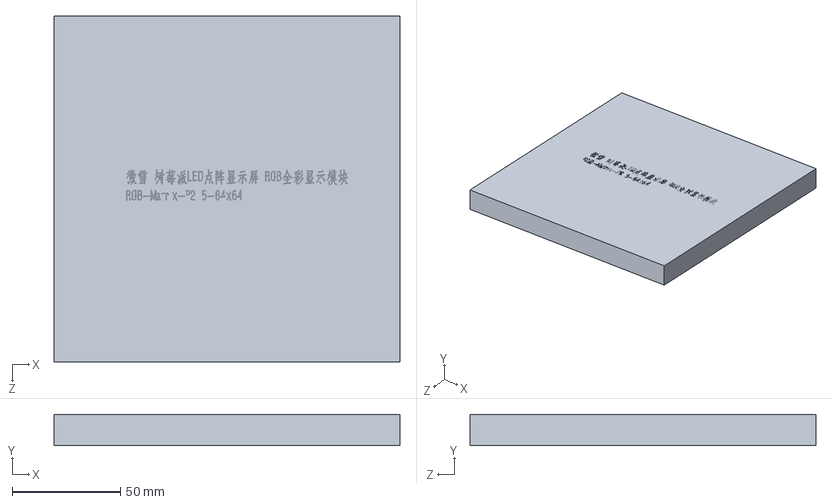
[picture p226: CAD file, 2024-02-10]
机械方面/电气部分/零件-屏幕-微雪LED点阵显示屏RGB-Matrix-P2.5-64x64.SLDPRT
160.0 x 14.5 x 160.0 mm
