Tylenoler/Hyperion/机械方面/轮腿结构/零件-leg-knee-motor.SLDPRT

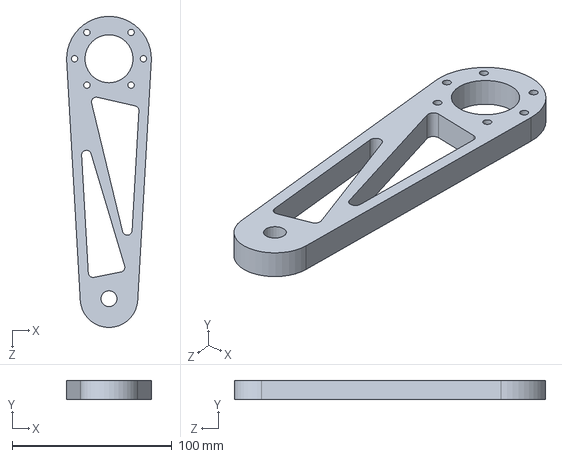
[picture p227: CAD file, 2024-02-18]
机械方面/轮腿结构/零件-leg-knee-motor.SLDPRT
52.9 x 12.0 x 194.4 mm
