Tylenoler/Hyperion/机械方面/主架部分/零件-车架-屏幕底部防护.SLDPRT

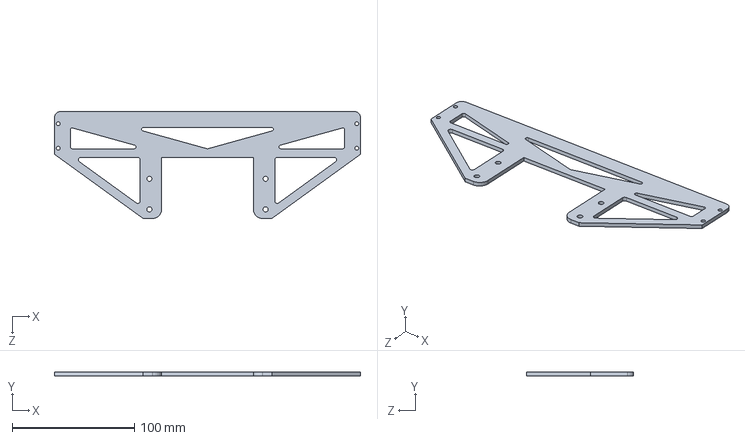
[picture p228: CAD file, 2024-02-28]
机械方面/主架部分/零件-车架-屏幕底部防护.SLDPRT
250.0 x 3.00 x 87.5 mm
