Tylenoler/Hyperion/机械方面/云台机构/Pitch轴/零件-pitch轴6020电机联轴器.SLDPRT

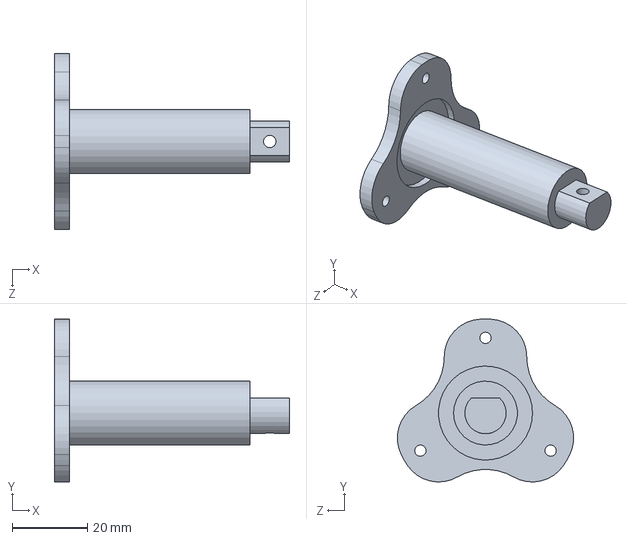
[picture p229: CAD file, 2024-02-10]
机械方面/云台机构/Pitch轴/零件-pitch轴6020电机联轴器.SLDPRT
62.5 x 43.3 x 46.8 mm
