Tylenoler/Hyperion/机械方面/云台机构/发射机构(对抗赛通用单枪)/PITCH轴转接件02.SLDPRT

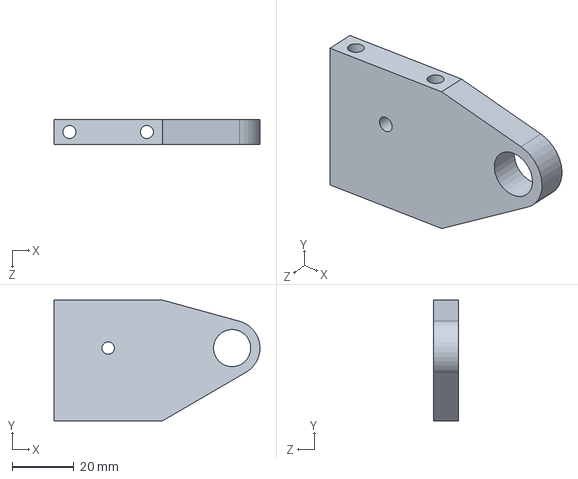
[picture p230: CAD file, 2024-02-18]
机械方面/云台机构/发射机构(对抗赛通用单枪)/PITCH轴转接件02.SLDPRT
66.5 x 39.0 x 8.00 mm
