Tylenoler/Hyperion/机械方面/云台机构/发射机构/零件-厚底板.SLDPRT

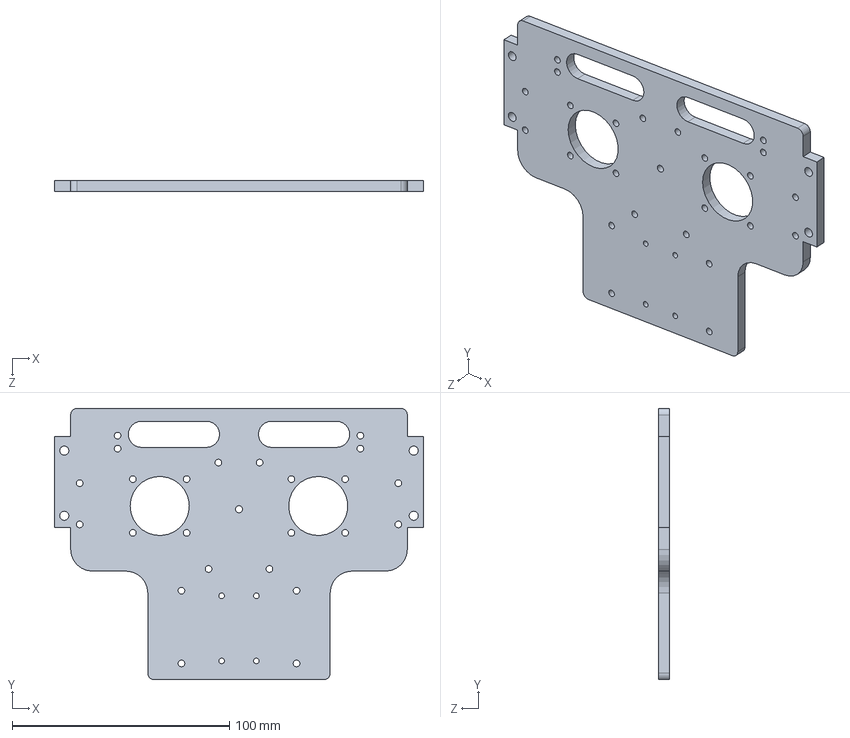
[picture p231: CAD file, 2024-02-10]
机械方面/云台机构/发射机构/零件-厚底板.SLDPRT
169.9 x 125.0 x 5.00 mm
