Tylenoler/Hyperion/机械方面/电气部分/emergency-stop-switch-2.snapshot.23/CONTRA-PORCA.SLDPRT

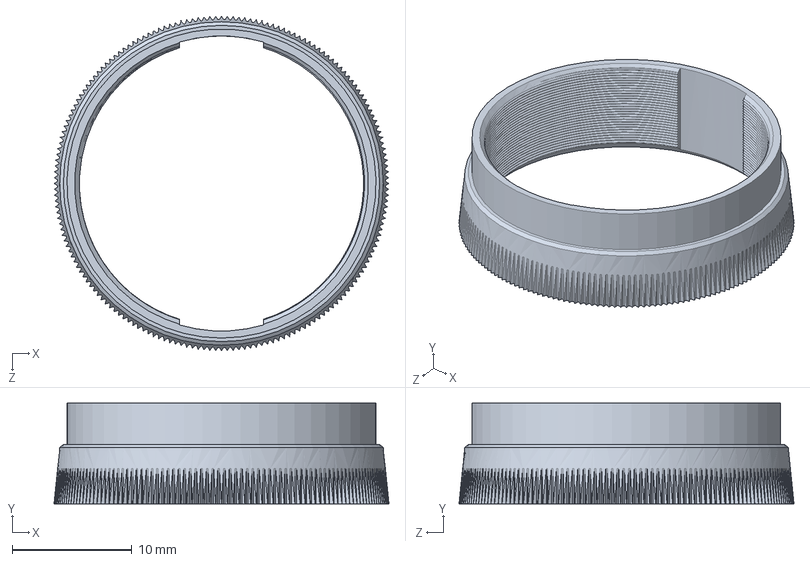
[picture p233: CAD file, 2024-02-10]
机械方面/电气部分/emergency-stop-switch-2.snapshot.23/CONTRA-PORCA.SLDPRT
28.0 x 8.41 x 28.0 mm
