Tylenoler/Hyperion/机械方面/电气部分/零件-屏幕-支架-微雪LED点阵屏幕.SLDPRT

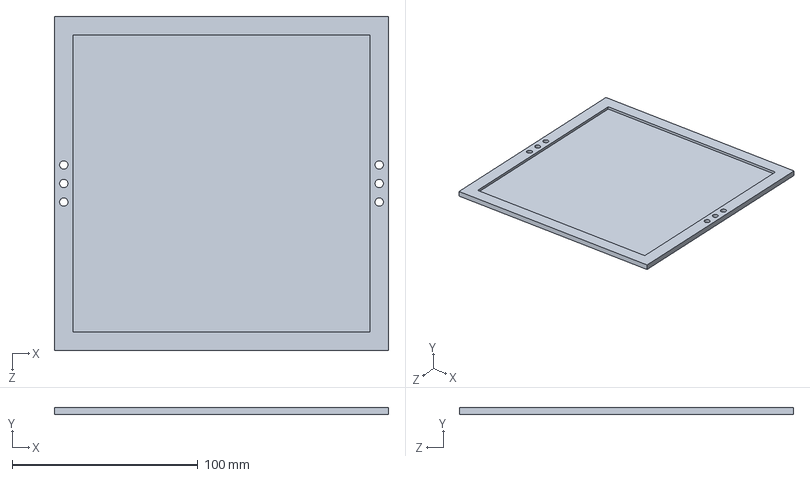
[picture p234: CAD file, 2024-02-08]
机械方面/电气部分/零件-屏幕-支架-微雪LED点阵屏幕.SLDPRT
180.0 x 4.00 x 180.0 mm
