Tylenoler/Hyperion/机械方面/轮腿结构/零件-leg-wheel-2.SLDPRT

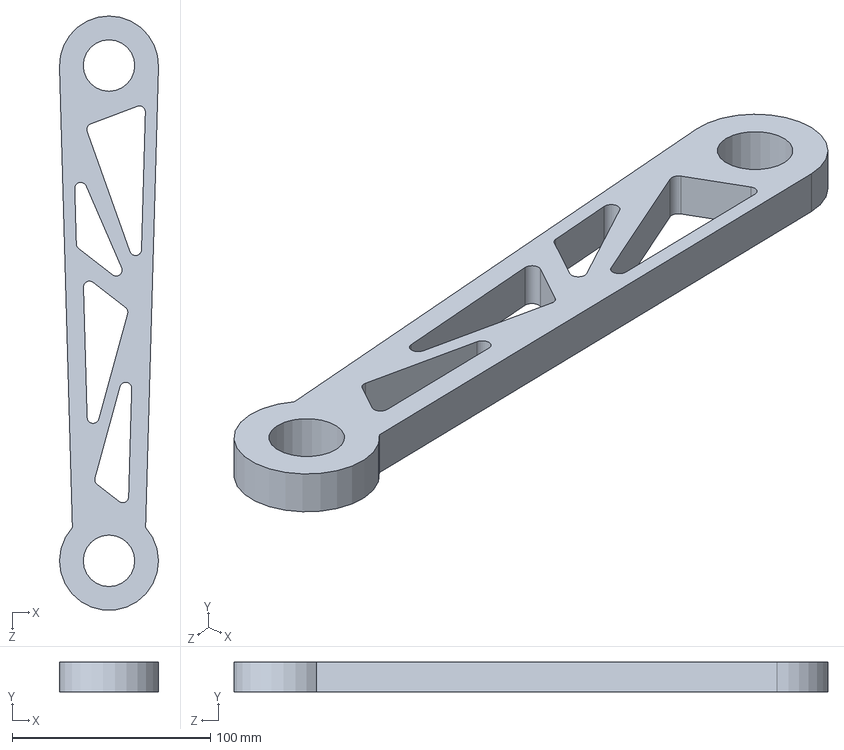
[picture p235: CAD file, 2024-02-08]
机械方面/轮腿结构/零件-leg-wheel-2.SLDPRT
50.0 x 15.0 x 299.8 mm
