Tylenoler/Hyperion/机械方面/主架部分/零件-车架-上层-顶壳(X2).SLDPRT

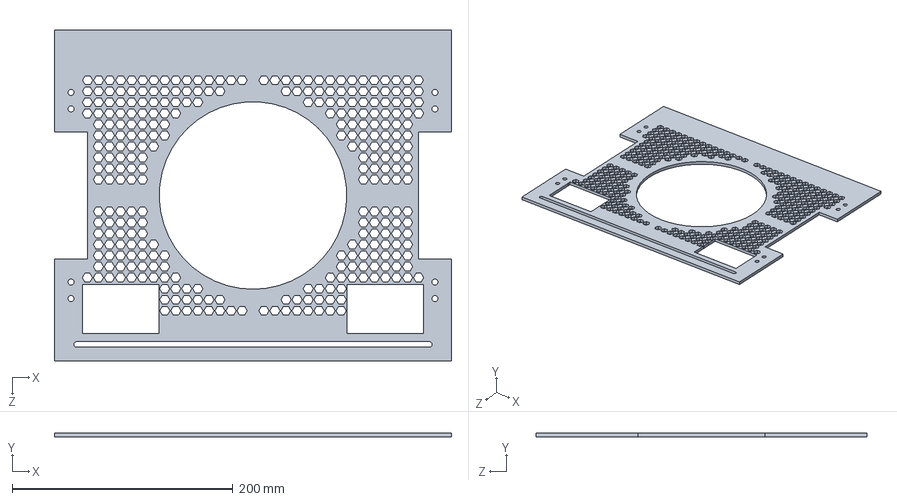
[picture p236: CAD file, 2024-02-28]
机械方面/主架部分/零件-车架-上层-顶壳(X2).SLDPRT
360.0 x 4.00 x 300.0 mm
