Tylenoler/Hyperion/机械方面/云台机构/Pitch轴/零件-6020连接转接零件.SLDPRT

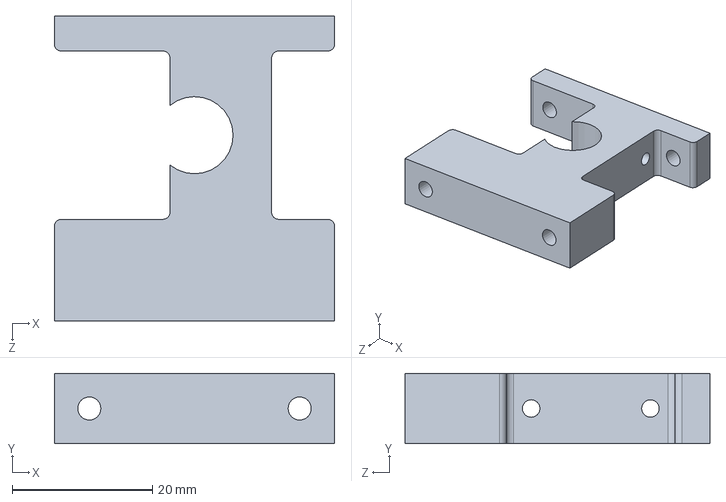
[picture p237: CAD file, 2024-02-10]
机械方面/云台机构/Pitch轴/零件-6020连接转接零件.SLDPRT
40.0 x 10.0 x 43.5 mm
