Tylenoler/Hyperion/机械方面/云台机构/yaw轴/yaw轴轴承座.SLDPRT

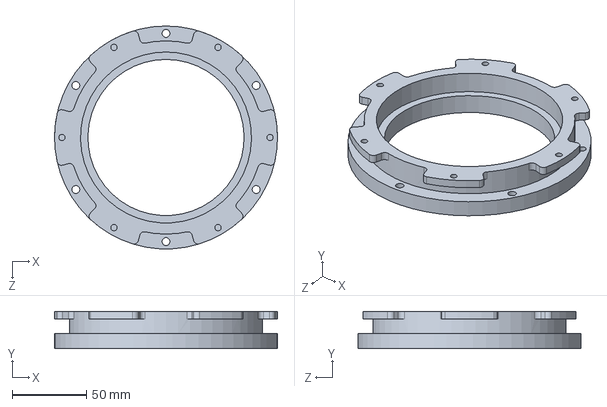
[picture p238: CAD file, 2024-02-10]
机械方面/云台机构/yaw轴/yaw轴轴承座.SLDPRT
150.0 x 25.0 x 150.0 mm
