Tylenoler/Hyperion/机械方面/云台机构/发射机构(对抗赛通用单枪)/后弹舱板（长）.SLDPRT

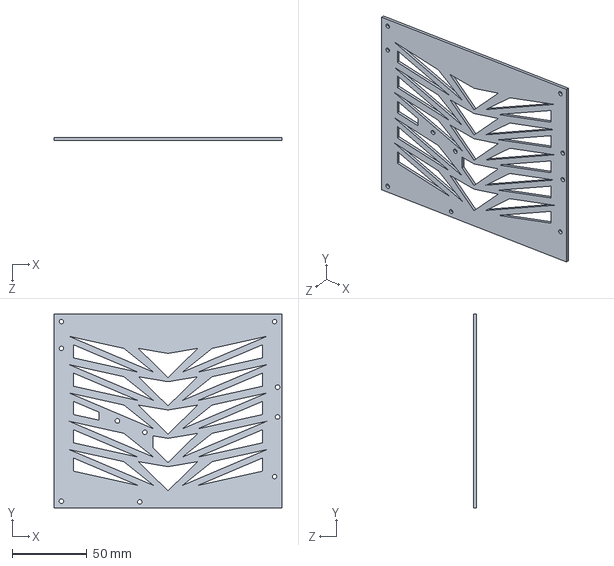
[picture p239: CAD file, 2024-02-18]
机械方面/云台机构/发射机构(对抗赛通用单枪)/后弹舱板（长）.SLDPRT
153.0 x 130.0 x 2.00 mm
