Tylenoler/Hyperion/机械方面/云台机构/发射机构/零件-2006连轴器压片.SLDPRT

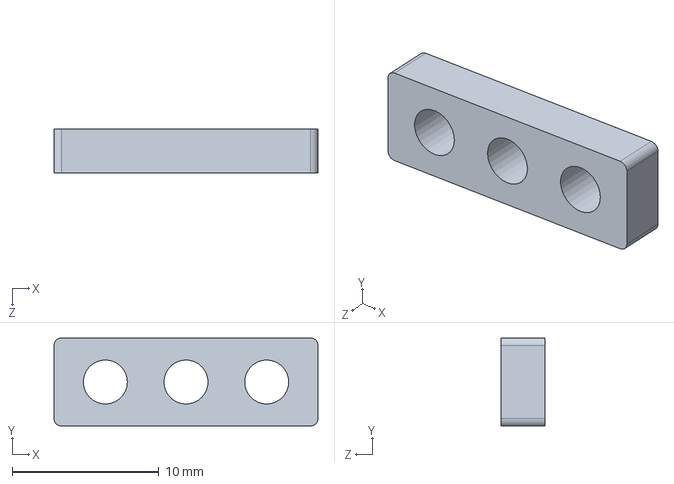
[picture p240: CAD file, 2024-02-10]
机械方面/云台机构/发射机构/零件-2006连轴器压片.SLDPRT
18.0 x 6.00 x 3.00 mm
