Tylenoler/Hyperion/机械方面/电气部分/emergency-stop-switch-2.snapshot.23/MOLA2.SLDPRT

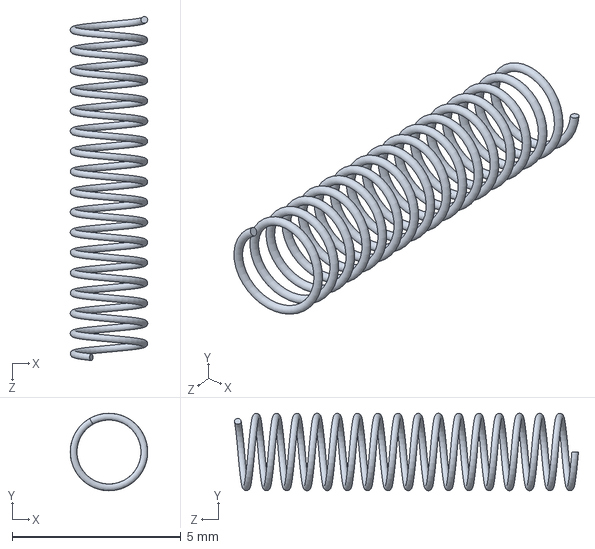
[picture p241: CAD file, 2024-02-10]
机械方面/电气部分/emergency-stop-switch-2.snapshot.23/MOLA2.SLDPRT
2.30 x 2.30 x 10.2 mm
