Tylenoler/Hyperion/机械方面/电气部分/零件-屏幕-支撑架.SLDPRT

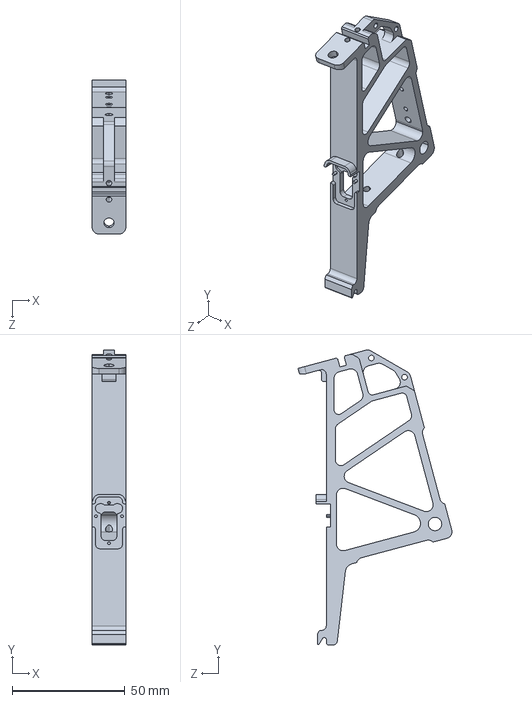
[picture p242: CAD file, 2024-02-08]
机械方面/电气部分/零件-屏幕-支撑架.SLDPRT
15.0 x 131.0 x 68.4 mm
