Tylenoler/Hyperion/机械方面/轮腿结构/零件-关节电机架(内).SLDPRT

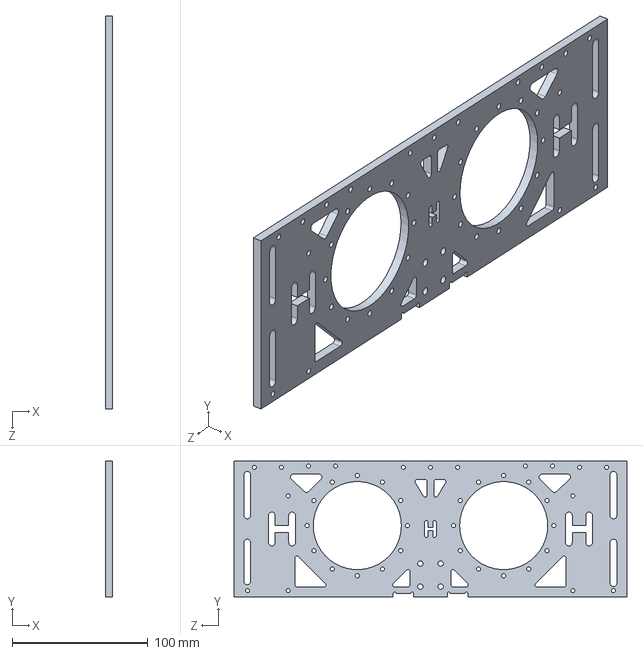
[picture p243: CAD file, 2024-02-08]
机械方面/轮腿结构/零件-关节电机架(内).SLDPRT
5.00 x 100.0 x 290.0 mm
