Tylenoler/Hyperion/机械方面/云台机构/Pitch轴/零件-pitch轴云台侧板（电机）.SLDPRT

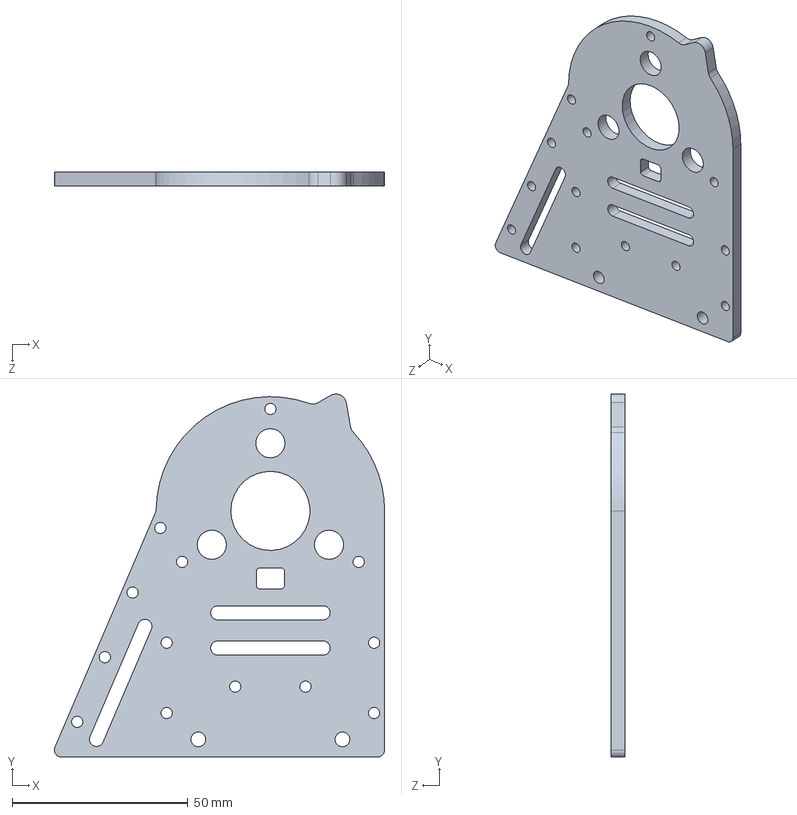
[picture p244: CAD file, 2024-02-10]
机械方面/云台机构/Pitch轴/零件-pitch轴云台侧板（电机）.SLDPRT
94.0 x 103.3 x 4.00 mm
