Tylenoler/Hyperion/机械方面/云台机构/发射机构(对抗赛通用单枪)/25mm lens.alpha1.0(1).SLDPRT

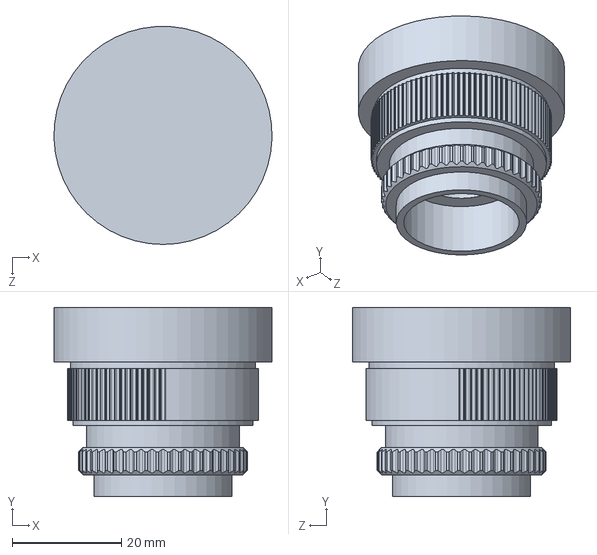
[picture p245: CAD file, 2024-02-18]
机械方面/云台机构/发射机构(对抗赛通用单枪)/25mm lens.alpha1.0(1).SLDPRT
40.0 x 34.7 x 40.0 mm
