Tylenoler/Hyperion/机械方面/云台机构/发射机构/零件-弹舱-放样弹舱底.SLDPRT

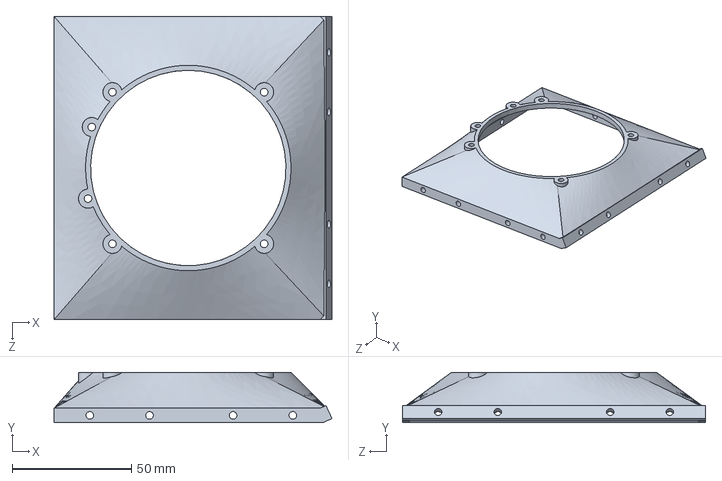
[picture p246: CAD file, 2024-02-10]
机械方面/云台机构/发射机构/零件-弹舱-放样弹舱底.SLDPRT
116.4 x 21.0 x 127.0 mm
