Tylenoler/Hyperion/机械方面/电气部分/emergency-stop-switch-2.snapshot.23/CHAVE STOP.SLDPRT

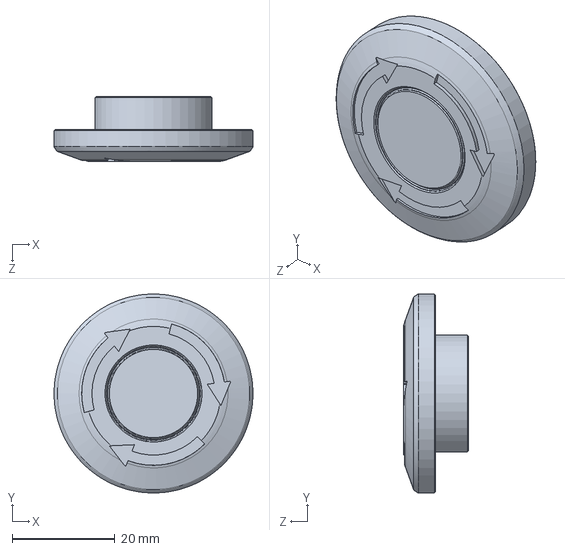
[picture p247: CAD file, 2024-02-10]
机械方面/电气部分/emergency-stop-switch-2.snapshot.23/CHAVE STOP.SLDPRT
38.8 x 38.8 x 12.7 mm
