Tylenoler/Hyperion/机械方面/电气部分/零件-屏幕-微雪LED点阵显示屏RGB-Matrix-P3-64x32.SLDPRT

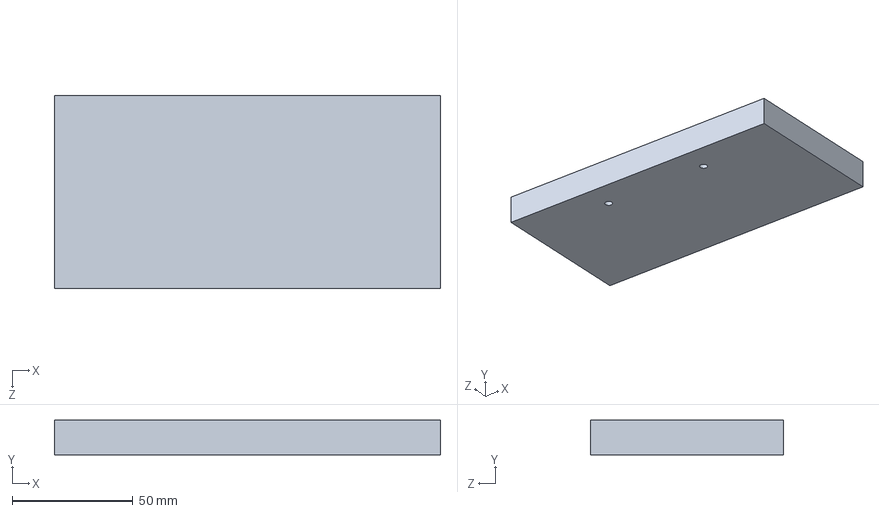
[picture p248: CAD file, 2024-02-08]
机械方面/电气部分/零件-屏幕-微雪LED点阵显示屏RGB-Matrix-P3-64x32.SLDPRT
160.0 x 14.5 x 80.0 mm
