Tylenoler/Hyperion/机械方面/主架部分/零件-车架-前装甲板.SLDPRT

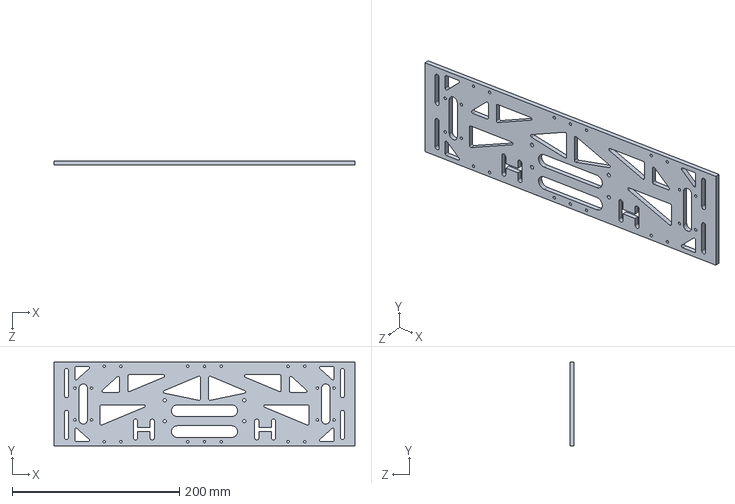
[picture p249: CAD file, 2024-02-28]
机械方面/主架部分/零件-车架-前装甲板.SLDPRT
360.0 x 100.0 x 5.00 mm
