Tylenoler/Hyperion/机械方面/云台机构/发射机构(对抗赛通用单枪)/零件-弹舱下.SLDPRT

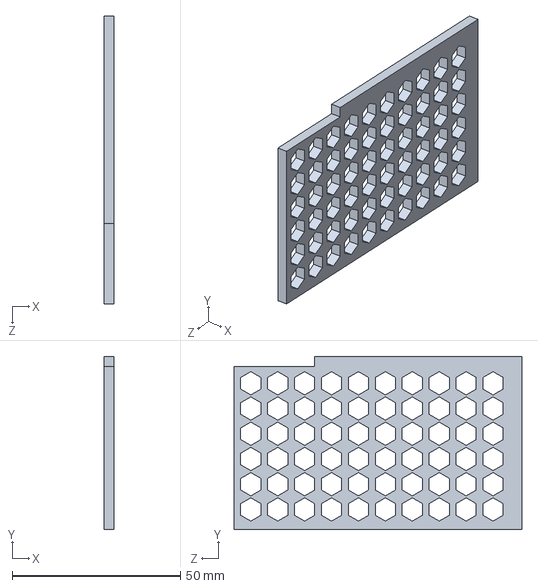
[picture p250: CAD file, 2024-02-18]
机械方面/云台机构/发射机构(对抗赛通用单枪)/零件-弹舱下.SLDPRT
3.00 x 51.5 x 85.6 mm
