Tylenoler/Hyperion/机械方面/云台机构/发射机构/零件-6706ZZ薄壁轴承30X37X4.SLDPRT

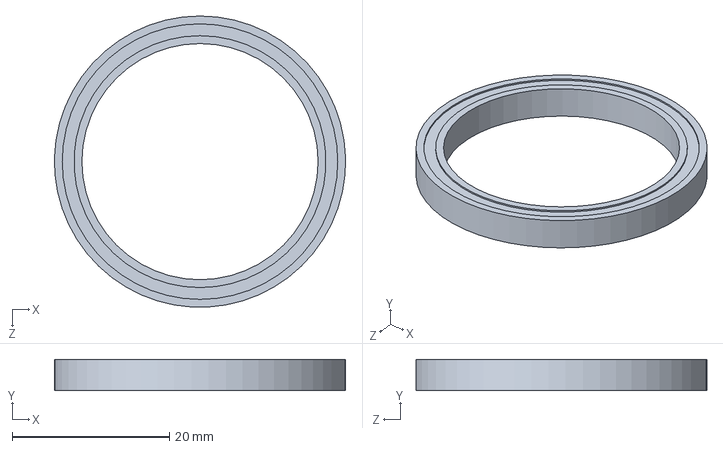
[picture p251: CAD file, 2024-02-10]
机械方面/云台机构/发射机构/零件-6706ZZ薄壁轴承30X37X4.SLDPRT
37.0 x 4.00 x 37.0 mm
