Tylenoler/Hyperion/机械方面/云台机构/Pitch轴/零件-支持件.SLDPRT

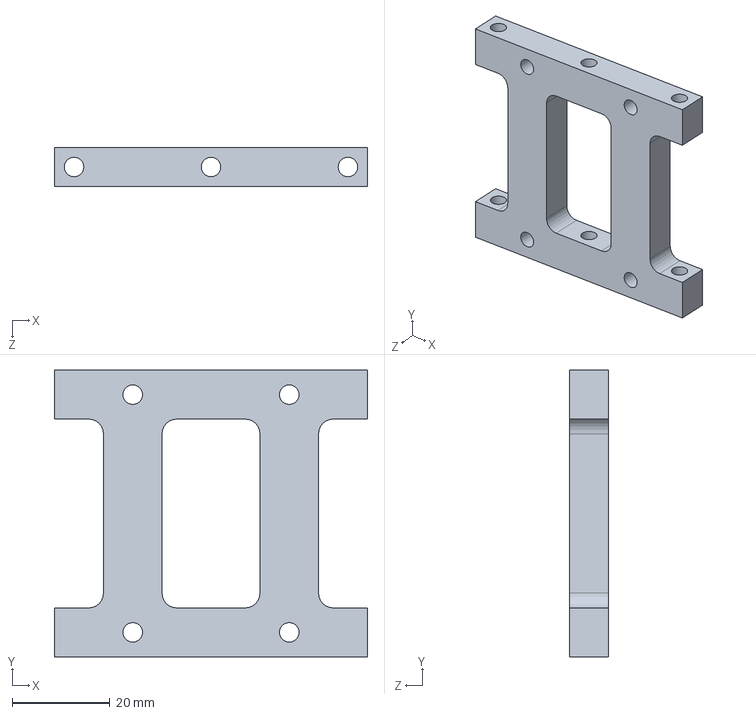
[picture p252: CAD file, 2024-02-10]
机械方面/云台机构/Pitch轴/零件-支持件.SLDPRT
64.0 x 58.6 x 8.00 mm
