Tylenoler/Hyperion/机械方面/云台机构/发射机构(对抗赛通用单枪)/步兵发射功能集成件.SLDPRT

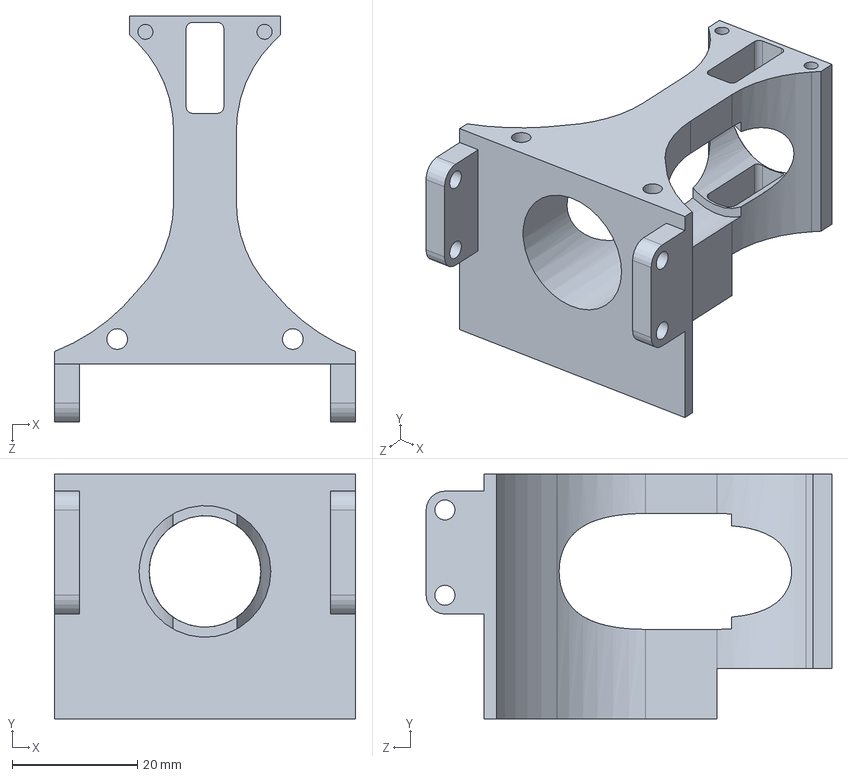
[picture p253: CAD file, 2024-02-18]
机械方面/云台机构/发射机构(对抗赛通用单枪)/步兵发射功能集成件.SLDPRT
48.0 x 39.0 x 64.7 mm
