Tylenoler/Hyperion/机械方面/云台机构/发射机构/零件-大号拨盘八爪拨盘柱体.SLDPRT

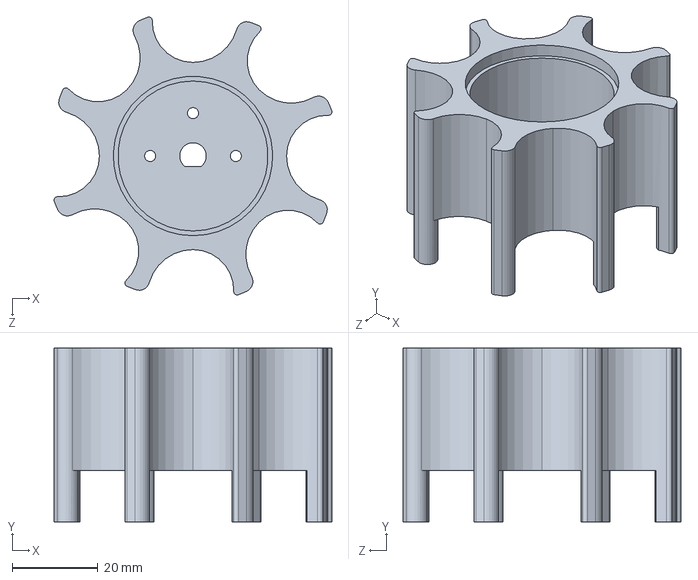
[picture p254: CAD file, 2024-02-10]
机械方面/云台机构/发射机构/零件-大号拨盘八爪拨盘柱体.SLDPRT
64.9 x 40.5 x 64.9 mm
