Tylenoler/Hyperion/机械方面/电气部分/emergency-stop-switch-2.snapshot.23/TERMINAL FIXO.SLDPRT

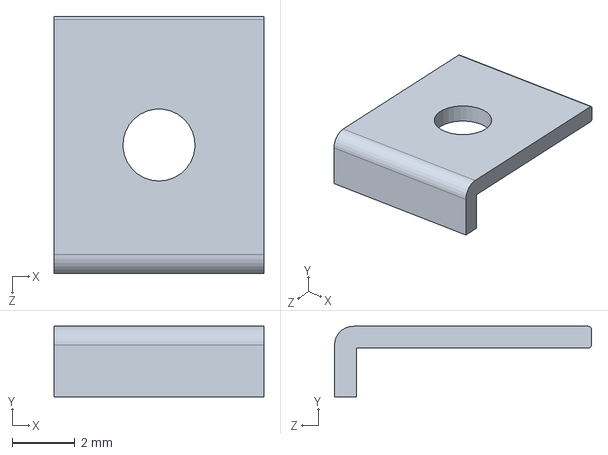
[picture p255: CAD file, 2024-02-10]
机械方面/电气部分/emergency-stop-switch-2.snapshot.23/TERMINAL FIXO.SLDPRT
6.70 x 2.25 x 8.20 mm
