Tylenoler/Hyperion/机械方面/云台机构/Pitch轴/零件-6020联轴器压片.SLDPRT

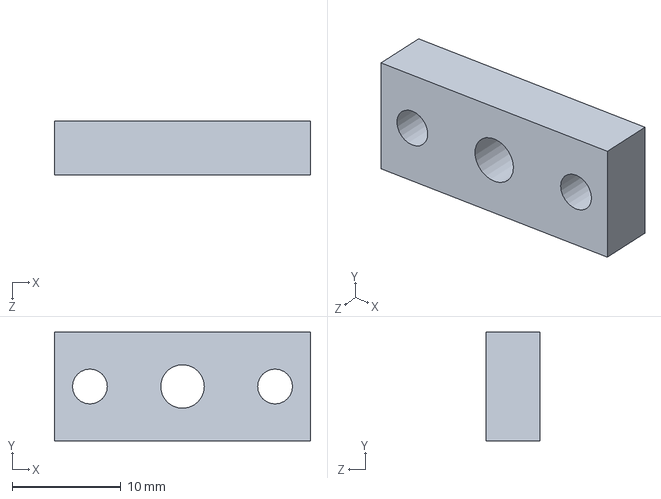
[picture p257: CAD file, 2024-02-10]
机械方面/云台机构/Pitch轴/零件-6020联轴器压片.SLDPRT
23.5 x 10.0 x 5.00 mm
