Tylenoler/Hyperion/机械方面/云台机构/发射机构(对抗赛通用单枪)/3508摩擦轮.SLDPRT

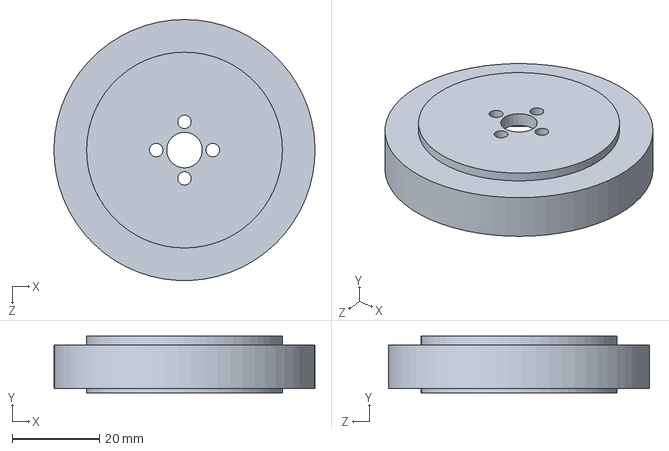
[picture p258: CAD file, 2024-02-18]
机械方面/云台机构/发射机构(对抗赛通用单枪)/3508摩擦轮.SLDPRT
60.0 x 13.0 x 60.0 mm
