Tylenoler/Hyperion/机械方面/主架部分/零件-顶面急停位置填充.SLDPRT

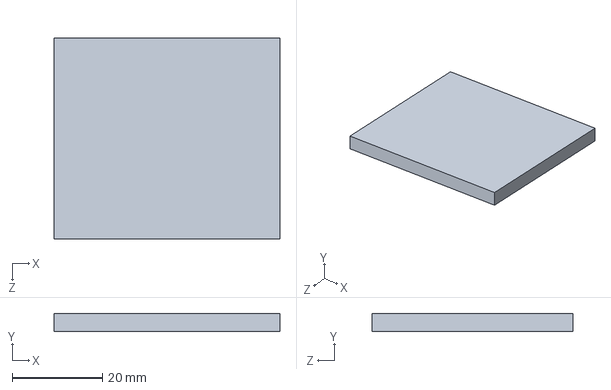
[picture p259: CAD file, 2024-02-18]
机械方面/主架部分/零件-顶面急停位置填充.SLDPRT
50.0 x 4.00 x 44.5 mm
