Tylenoler/Hyperion/机械方面/云台机构/发射机构/零件-大号弹仓挡边层.SLDPRT

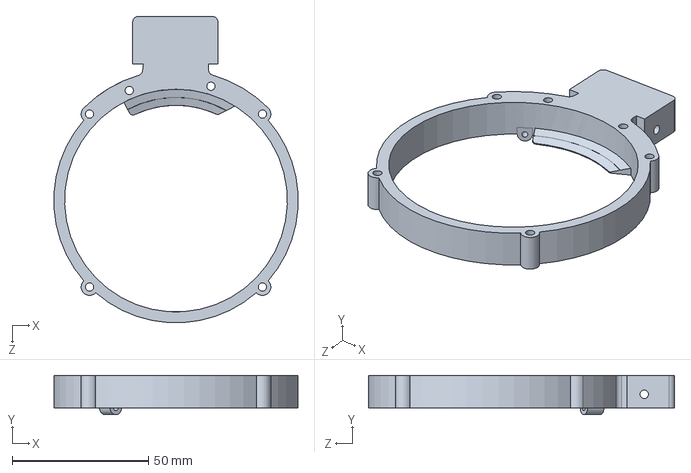
[picture p260: CAD file, 2024-02-10]
机械方面/云台机构/发射机构/零件-大号弹仓挡边层.SLDPRT
89.6 x 14.5 x 112.4 mm
