Tylenoler/Hyperion/机械方面/电气部分/emergency-stop-switch-2.snapshot.23/HASTE.SLDPRT

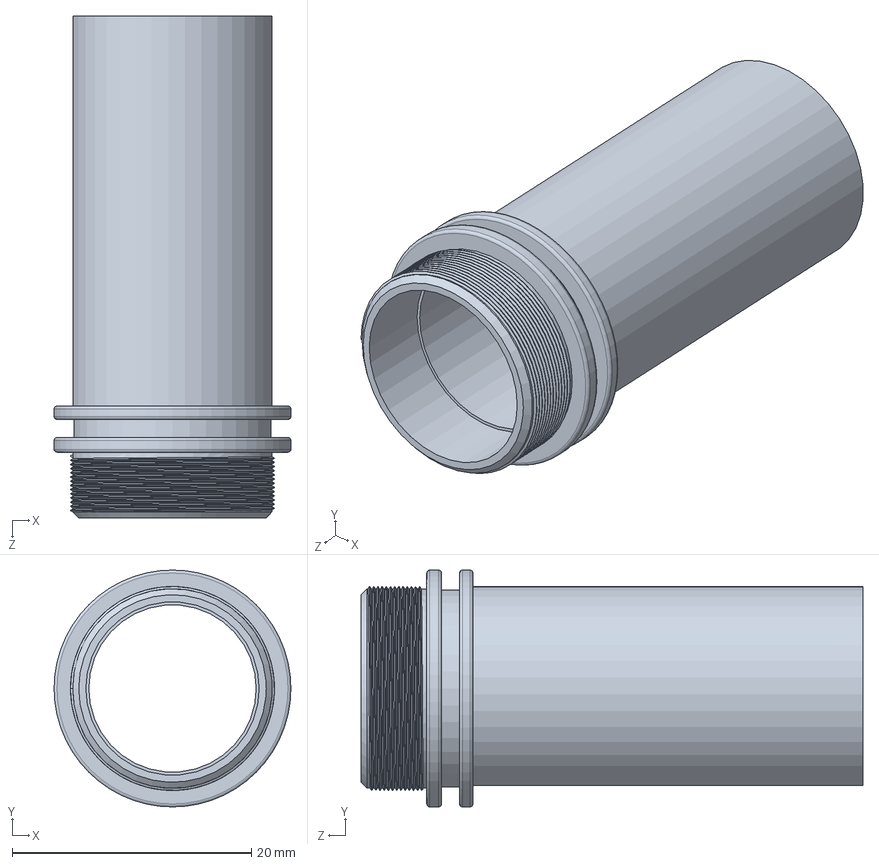
[picture p261: CAD file, 2024-02-10]
机械方面/电气部分/emergency-stop-switch-2.snapshot.23/HASTE.SLDPRT
19.8 x 19.8 x 42.0 mm
