Tylenoler/Hyperion/机械方面/主架部分/零件-车架-底部-侧面壳.SLDPRT

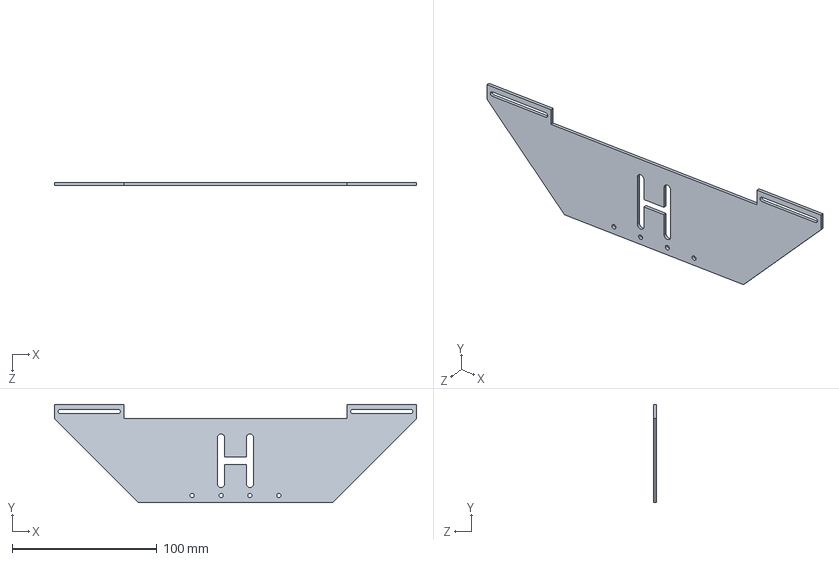
[picture p262: CAD file, 2024-02-18]
机械方面/主架部分/零件-车架-底部-侧面壳.SLDPRT
250.0 x 68.0 x 2.00 mm
