Tylenoler/Hyperion/机械方面/云台机构/发射机构(对抗赛通用单枪)/尼龙柱m3-35.SLDPRT

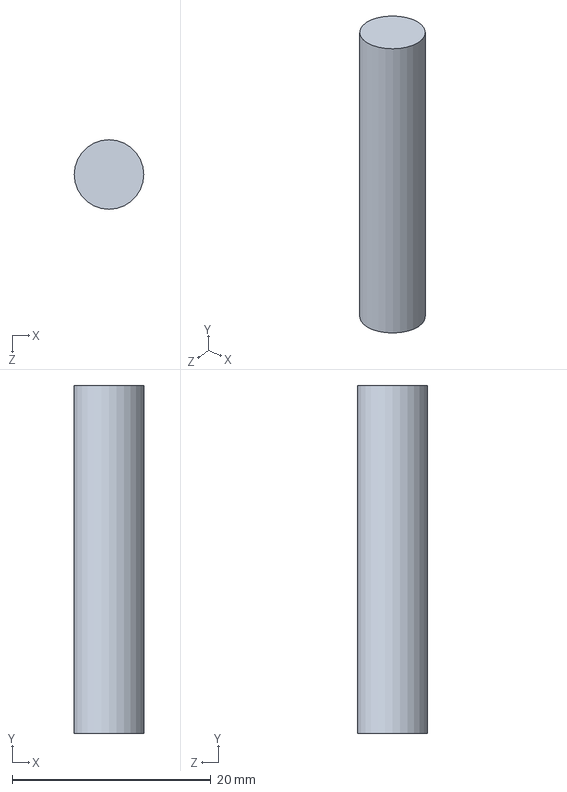
[picture p263: CAD file, 2024-02-18]
机械方面/云台机构/发射机构(对抗赛通用单枪)/尼龙柱m3-35.SLDPRT
7.00 x 35.0 x 7.00 mm
