Tylenoler/Hyperion/机械方面/云台机构/发射机构/零件-弹舱-弹舱侧板.SLDPRT

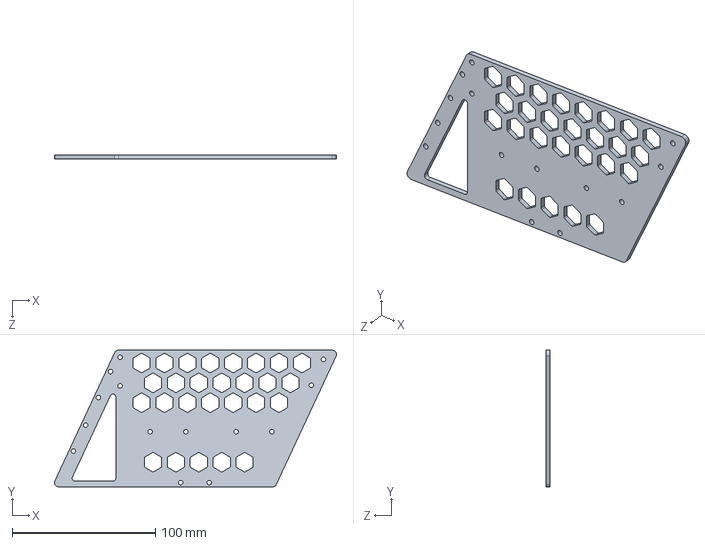
[picture p264: CAD file, 2024-02-10]
机械方面/云台机构/发射机构/零件-弹舱-弹舱侧板.SLDPRT
197.0 x 95.5 x 3.00 mm
