Tylenoler/Hyperion/机械方面/电气部分/emergency-stop-switch-2.snapshot.23/MOLA.SLDPRT

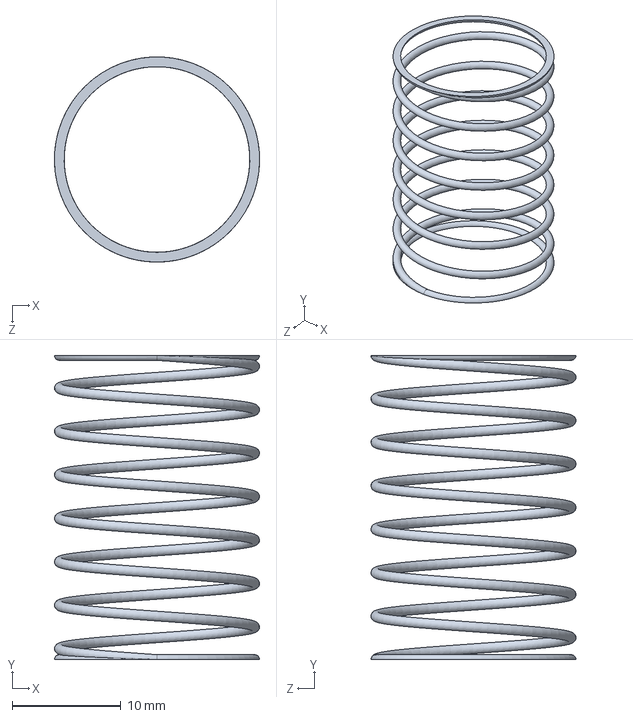
[picture p265: CAD file, 2024-02-10]
机械方面/电气部分/emergency-stop-switch-2.snapshot.23/MOLA.SLDPRT
18.9 x 28.0 x 18.9 mm
