Tylenoler/Hyperion/机械方面/主架部分/零件-控制按钮安装架.SLDPRT

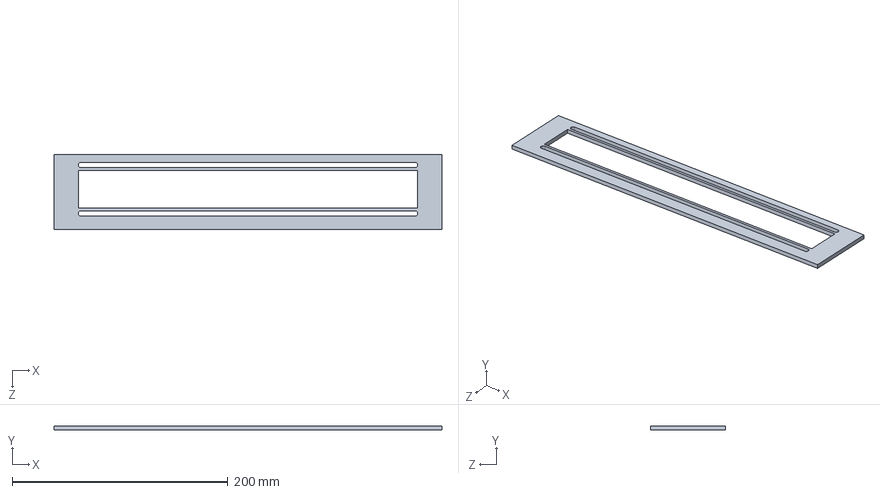
[picture p266: CAD file, 2024-02-10]
机械方面/主架部分/零件-控制按钮安装架.SLDPRT
360.0 x 4.00 x 70.0 mm
