Tylenoler/Hyperion/机械方面/云台机构/发射机构(对抗赛通用单枪)/红点安装板.SLDPRT

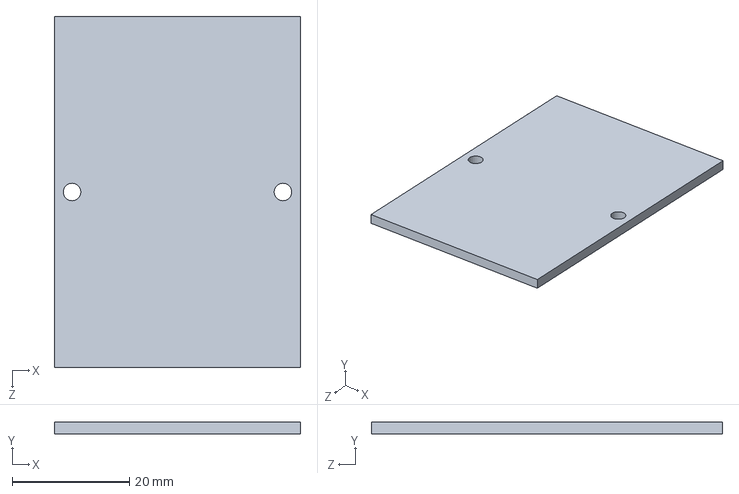
[picture p267: CAD file, 2024-02-18]
机械方面/云台机构/发射机构(对抗赛通用单枪)/红点安装板.SLDPRT
42.0 x 2.00 x 60.0 mm
