Tylenoler/Hyperion/机械方面/云台机构/发射机构/零件-发射机构-陀螺仪防护板.SLDPRT

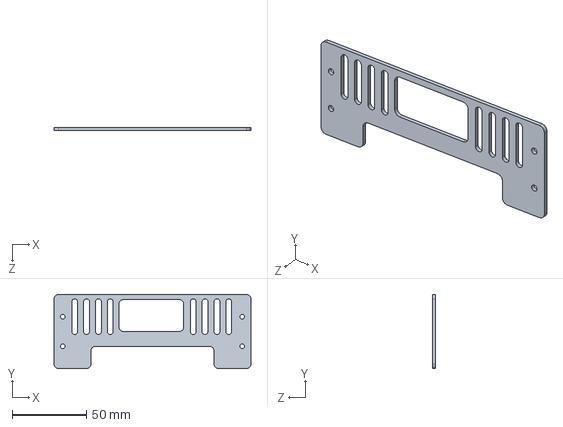
[picture p268: CAD file, 2024-02-10]
机械方面/云台机构/发射机构/零件-发射机构-陀螺仪防护板.SLDPRT
133.0 x 50.0 x 2.00 mm
