Tylenoler/Hyperion/机械方面/主架部分/零件-标准件-AP-20 x 20 x 250.SLDPRT

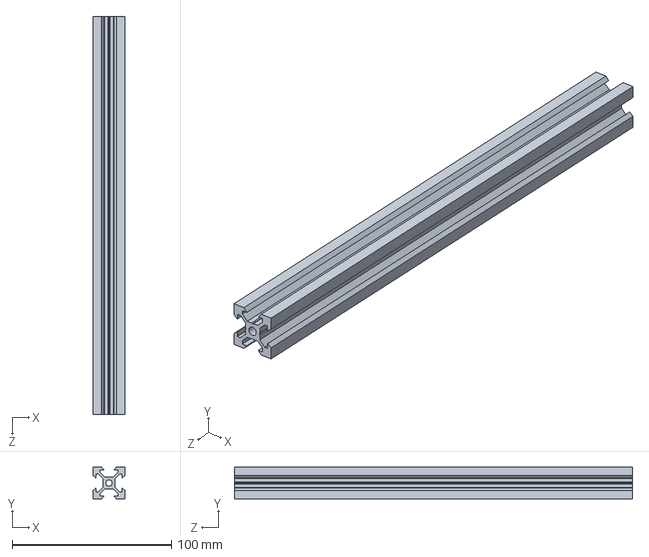
[picture p269: CAD file, 2024-02-08]
机械方面/主架部分/零件-标准件-AP-20 x 20 x 250.SLDPRT
20.0 x 20.0 x 250.0 mm
