Tylenoler/Hyperion/机械方面/云台机构/发射机构(对抗赛通用单枪)/11.29无枪口.SLDPRT

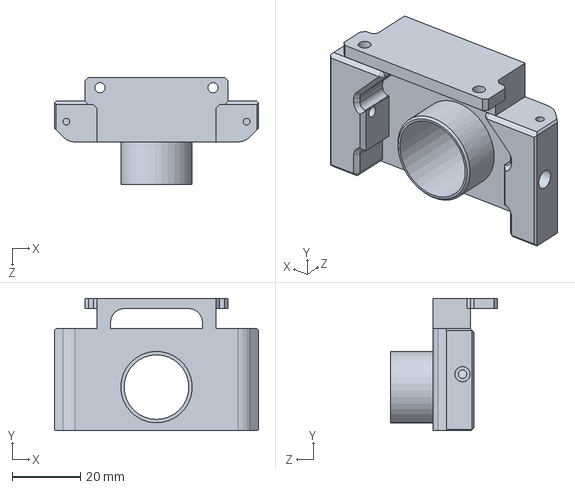
[picture p270: CAD file, 2024-02-18]
机械方面/云台机构/发射机构(对抗赛通用单枪)/11.29无枪口.SLDPRT
60.0 x 38.9 x 31.5 mm
