Tylenoler/Hyperion/机械方面/云台机构/发射机构/零件-上供弹-微动开关-摩擦管-29.1.SLDPRT

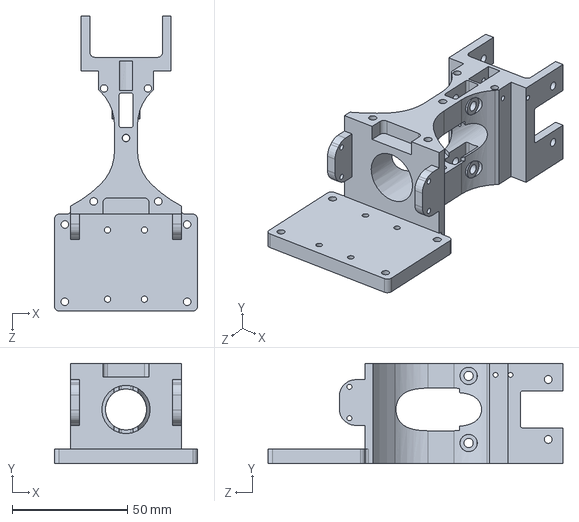
[picture p271: CAD file, 2024-02-10]
机械方面/云台机构/发射机构/零件-上供弹-微动开关-摩擦管-29.1.SLDPRT
62.0 x 43.5 x 127.9 mm
