Tylenoler/Hyperion/机械方面/主架部分/零件-车架-屏幕底部防撞.SLDPRT

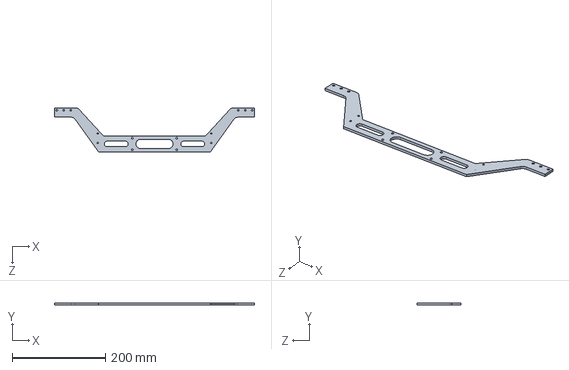
[picture p272: CAD file, 2024-02-08]
机械方面/主架部分/零件-车架-屏幕底部防撞.SLDPRT
430.0 x 4.00 x 95.0 mm
