Tylenoler/Hyperion/机械方面/云台机构/发射机构(对抗赛通用单枪)/pitch轴限位板.SLDPRT

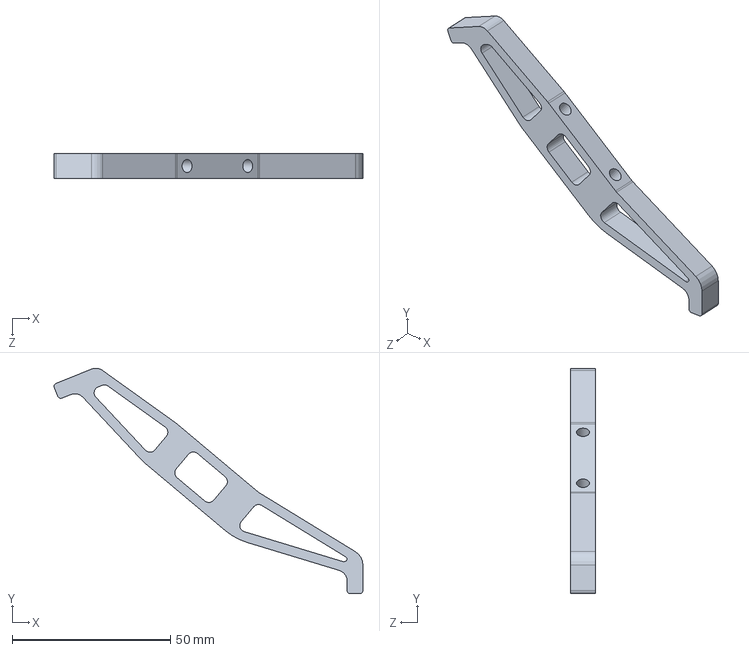
[picture p273: CAD file, 2024-02-18]
机械方面/云台机构/发射机构(对抗赛通用单枪)/pitch轴限位板.SLDPRT
97.5 x 71.2 x 8.00 mm
