Tylenoler/Hyperion/机械方面/云台机构/发射机构/零件-大号弹仓上部壁面.SLDPRT

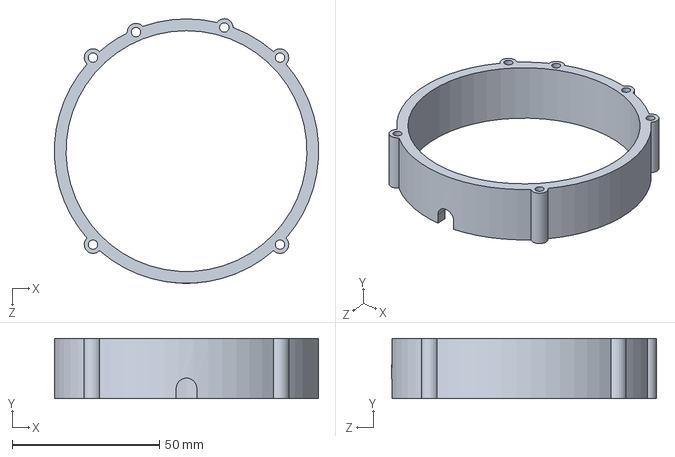
[picture p274: CAD file, 2024-02-10]
机械方面/云台机构/发射机构/零件-大号弹仓上部壁面.SLDPRT
89.7 x 20.5 x 89.9 mm
