Tylenoler/Hyperion/机械方面/云台机构/发射机构(对抗赛通用单枪)/6x10x10螺母座.SLDPRT

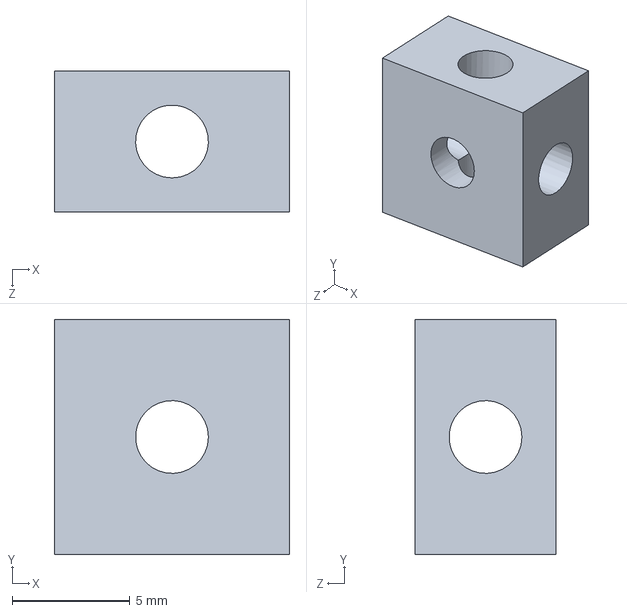
[picture p275: CAD file, 2024-02-18]
机械方面/云台机构/发射机构(对抗赛通用单枪)/6x10x10螺母座.SLDPRT
10.0 x 10.0 x 6.00 mm
