Tylenoler/Hyperion/机械方面/云台机构/发射机构/零件-大号弹仓底部壁面.SLDPRT

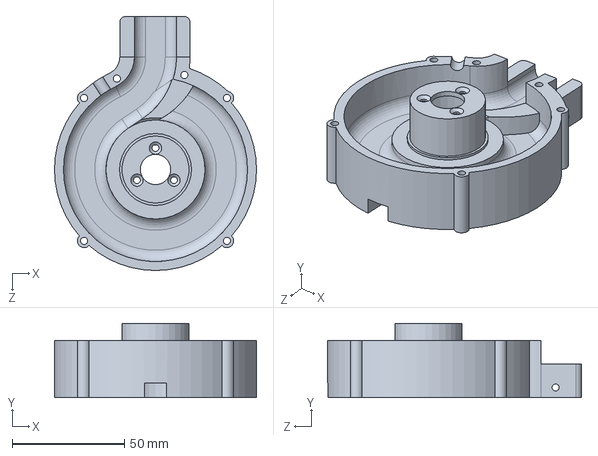
[picture p276: CAD file, 2024-02-10]
机械方面/云台机构/发射机构/零件-大号弹仓底部壁面.SLDPRT
89.8 x 33.0 x 112.9 mm
