Tylenoler/Hyperion/机械方面/主架部分/零件-标准件-AP-20 x 20 x 120.SLDPRT

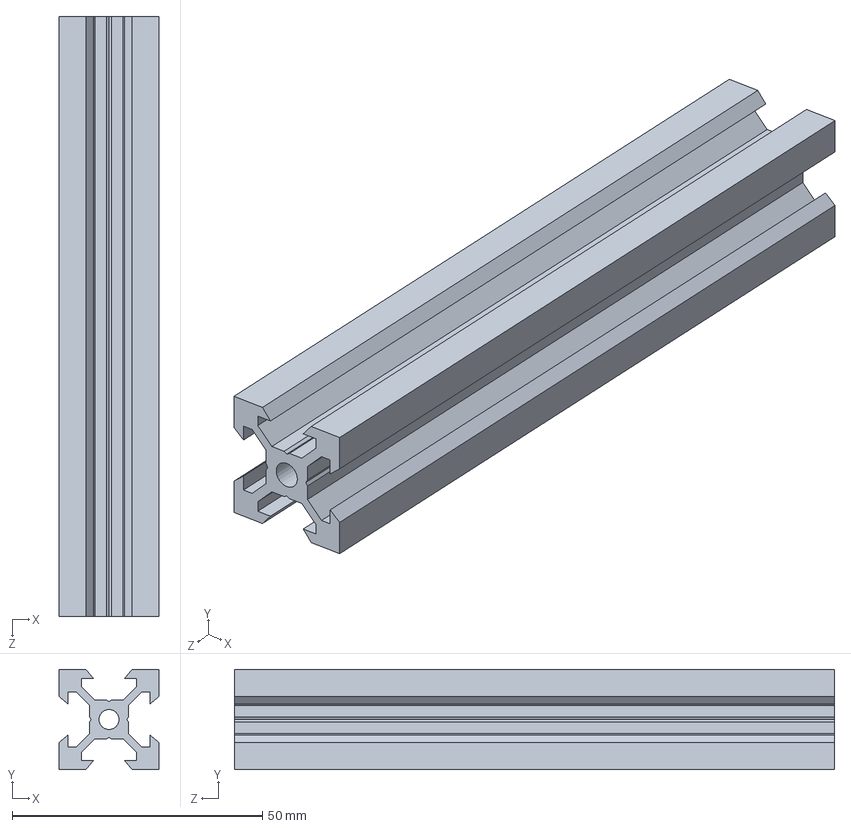
[picture p277: CAD file, 2024-02-08]
机械方面/主架部分/零件-标准件-AP-20 x 20 x 120.SLDPRT
20.0 x 20.0 x 120.0 mm
