Tylenoler/Hyperion/机械方面/云台机构/发射机构(对抗赛通用单枪)/拨弹轮壳.SLDPRT

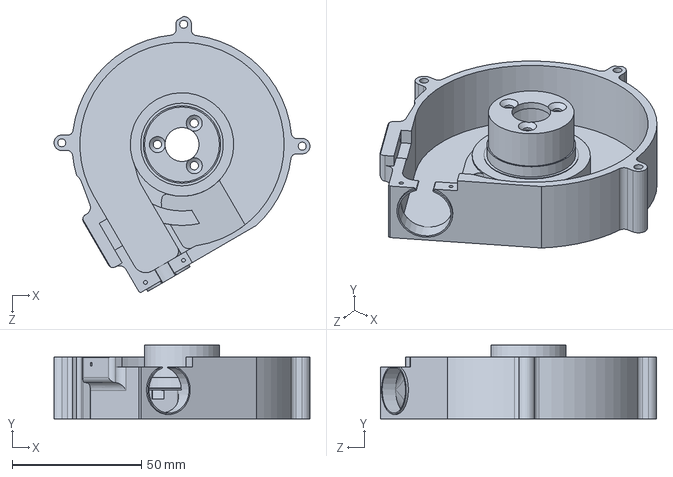
[picture p278: CAD file, 2024-02-18]
机械方面/云台机构/发射机构(对抗赛通用单枪)/拨弹轮壳.SLDPRT
99.0 x 28.5 x 106.7 mm
