Tylenoler/Hyperion/机械方面/云台机构/发射机构/零件-弹舱-弹舱前板.SLDPRT

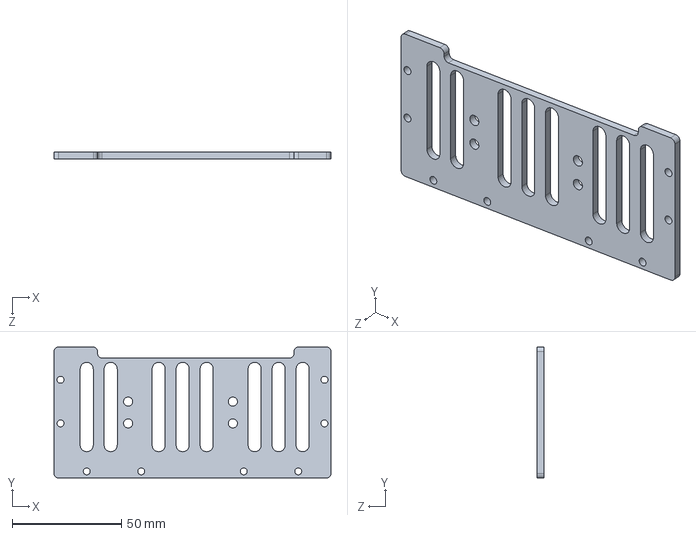
[picture p279: CAD file, 2024-02-10]
机械方面/云台机构/发射机构/零件-弹舱-弹舱前板.SLDPRT
127.0 x 60.0 x 3.00 mm
