Tylenoler/Hyperion/机械方面/云台机构/发射机构(对抗赛通用单枪)/弹舱盖限位.SLDPRT

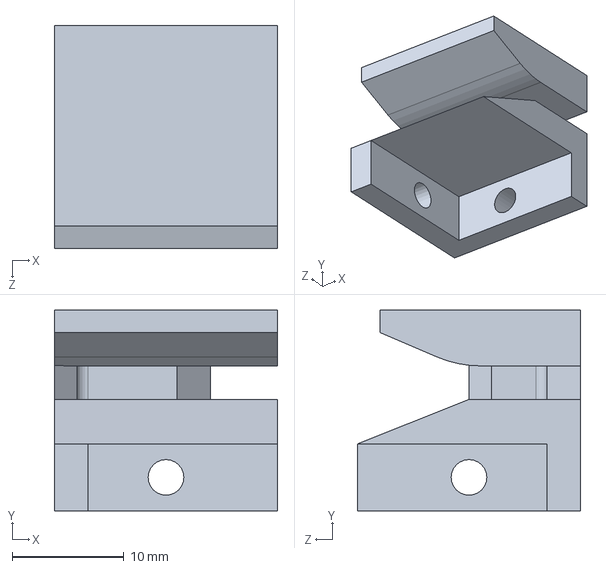
[picture p281: CAD file, 2024-02-18]
机械方面/云台机构/发射机构(对抗赛通用单枪)/弹舱盖限位.SLDPRT
20.0 x 18.0 x 20.0 mm
