Tylenoler/Hyperion/机械方面/云台机构/发射机构/零件-2006连轴器.SLDPRT

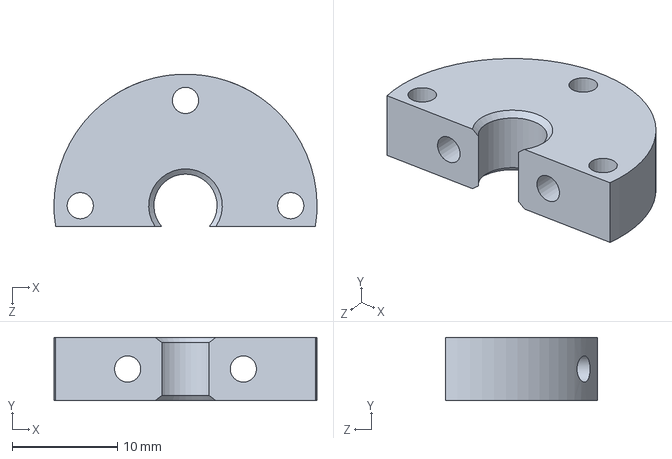
[picture p282: CAD file, 2024-02-10]
机械方面/云台机构/发射机构/零件-2006连轴器.SLDPRT
25.0 x 6.00 x 14.5 mm
