Tylenoler/Hyperion/机械方面/主架部分/零件-前后万向轮安装板.SLDPRT

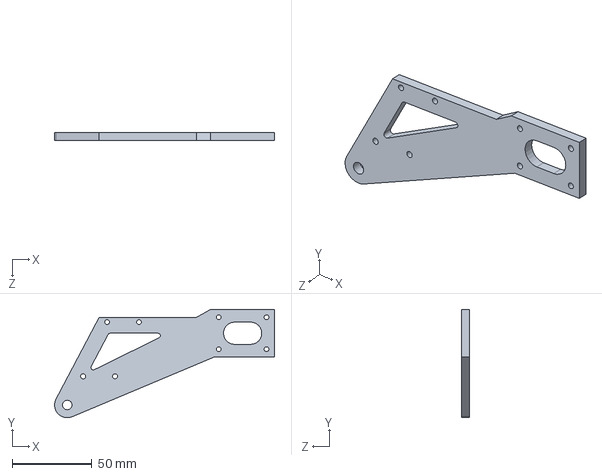
[picture p283: CAD file, 2024-02-08]
机械方面/主架部分/零件-前后万向轮安装板.SLDPRT
138.0 x 68.0 x 5.00 mm
