Tylenoler/Hyperion/机械方面/云台机构/发射机构(对抗赛通用单枪)/第二层板（3mm）.SLDPRT

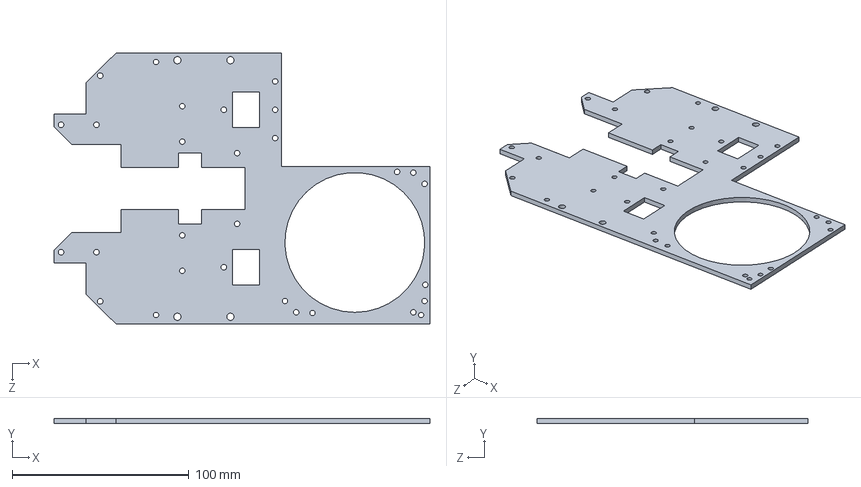
[picture p284: CAD file, 2024-02-18]
机械方面/云台机构/发射机构(对抗赛通用单枪)/第二层板（3mm）.SLDPRT
212.5 x 3.00 x 153.0 mm
