Tylenoler/Hyperion/机械方面/主架部分/零件-标准件-Angle Bracket 2020.SLDPRT

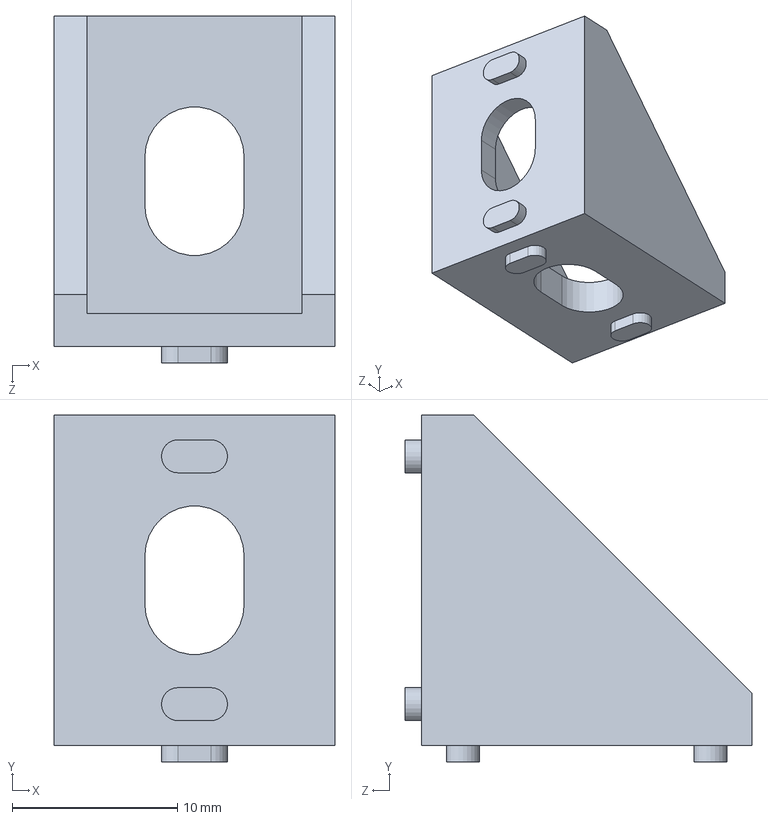
[picture p286: CAD file, 2024-02-08]
机械方面/主架部分/零件-标准件-Angle Bracket 2020.SLDPRT
17.0 x 21.0 x 21.0 mm
