Tylenoler/Hyperion/机械方面/云台机构/发射机构(对抗赛通用单枪)/4mm轴肩螺栓.SLDPRT

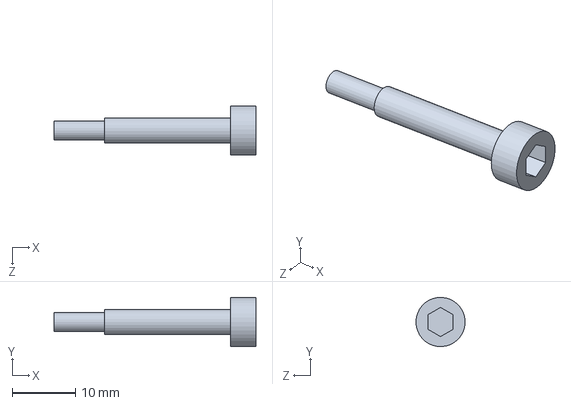
[picture p287: CAD file, 2024-02-18]
机械方面/云台机构/发射机构(对抗赛通用单枪)/4mm轴肩螺栓.SLDPRT
32.0 x 7.79 x 7.78 mm
