Tylenoler/Hyperion/机械方面/云台机构/yaw轴/装配体-yaw轴装配.SLDASM

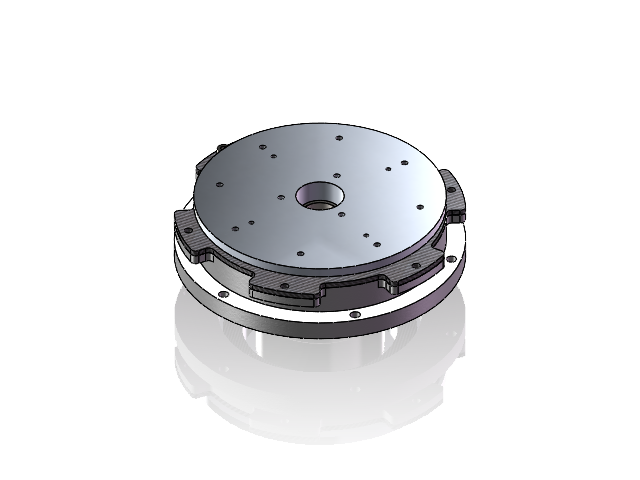
[picture p288: CAD file, 2024-02-18]
机械方面/云台机构/yaw轴/装配体-yaw轴装配.SLDASM
yaw轴轴承座
6818轴承
轴承外圈压片
M4X12
M4防松螺母
GM6020 直流无刷电机
轴承内圈加工
轴承内圈压片
