Tylenoler/Hyperion/机械方面/云台机构/发射机构/装配体-发射机构.SLDASM

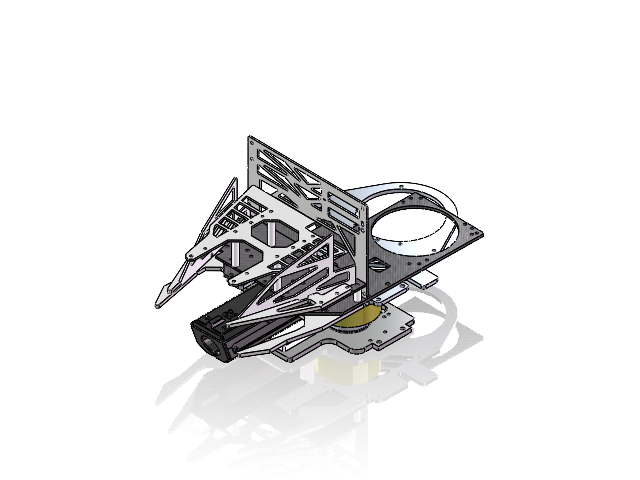
[picture p289: CAD file, 2024-02-18]
机械方面/云台机构/发射机构/装配体-发射机构.SLDASM
零件-RoboMaster M3508直流无刷减速电机 x 2
零件-摩擦轮60mm x 2
零件-测速模块
零件-厚底板
零件-上供弹-微动开关-摩擦管-29.1
零件-拨盘连接板向后3mm
尼龙柱m3-15 x 2
双枪步兵图传安装板
测速保护下板 x 2
测速防撞上板 x 2
前弹舱板（长）
前侧保护板 x 2
尼龙柱m3-35 x 4
图传底板
