Tylenoler/Hyperion/机械方面/云台机构/电气/NUC/装配体-miniPC-NUC.SLDASM

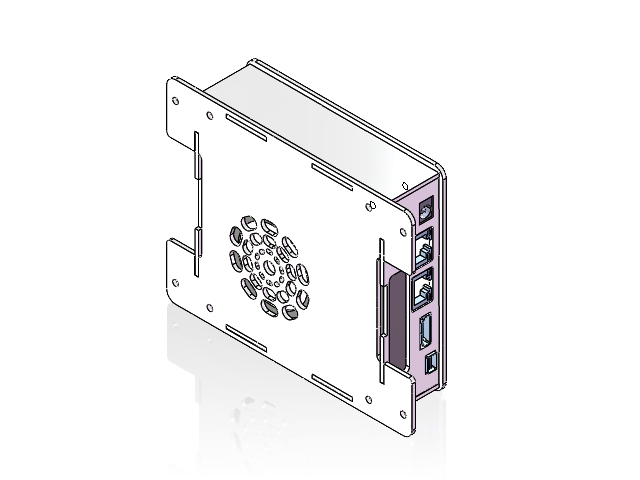
[picture p290: CAD file, 2024-02-10]
机械方面/云台机构/电气/NUC/装配体-miniPC-NUC.SLDASM
M3×10铜柱-2
M3×16铜柱-2
安装板-2
进风板-2
侧板-2 x 2
主板_官方-2
非通风板-2
通风板-2
