Tylenoler/Hyperion/机械方面/云台机构/Pitch轴/装配体-pitch轴.SLDASM

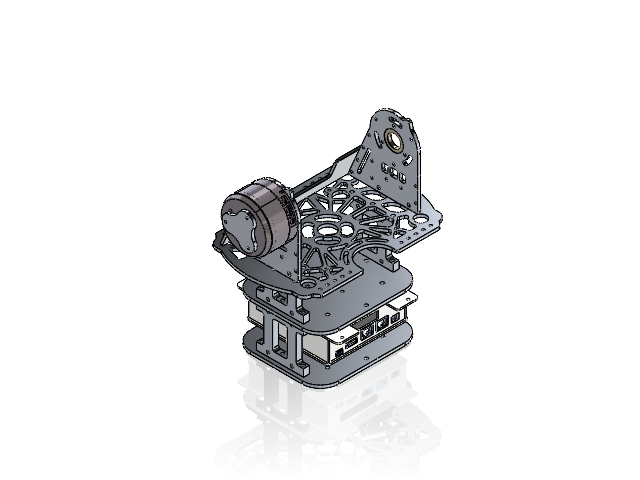
[picture p291: CAD file, 2024-02-18]
机械方面/云台机构/Pitch轴/装配体-pitch轴.SLDASM
零件-Yaw轴云台架底座 x 2
M3×10铜柱-2
M3×16铜柱-2
安装板-2
进风板-2
侧板-2 x 2
主板_官方-2
非通风板-2
通风板-2
零件-支持件 x 4
零件-电机-6020 直流无刷电机
零件-pitch轴6020电机联轴器
零件-6020联轴器压片
零件-法兰轴承 17x26x5-2
零件-NUC上固定板
零件-pitch轴云台侧板（无电机）
零件-pitch轴云台侧板（电机）
零件-发射机构防护前板
