Tylenoler/Hyperion/机械方面/轮腿结构/麦克纳姆轮组部分/装配体-127mm麦克纳姆轮组.SLDASM

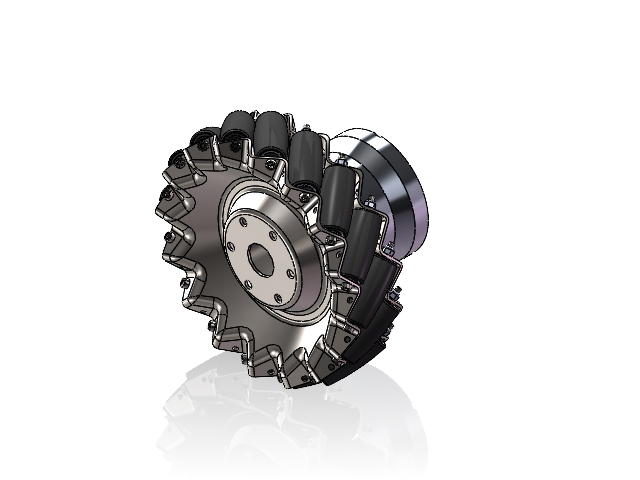
[picture p294: CAD file, 2024-02-25]
机械方面/轮腿结构/麦克纳姆轮组部分/装配体-127mm麦克纳姆轮组.SLDASM
零件-电机-12-24V空心杯转子钕强磁无刷电机
148mm麦轮右
