Tylenoler/Hyperion/机械方面/轮腿结构/装配体-右轮腿-152mm.SLDASM

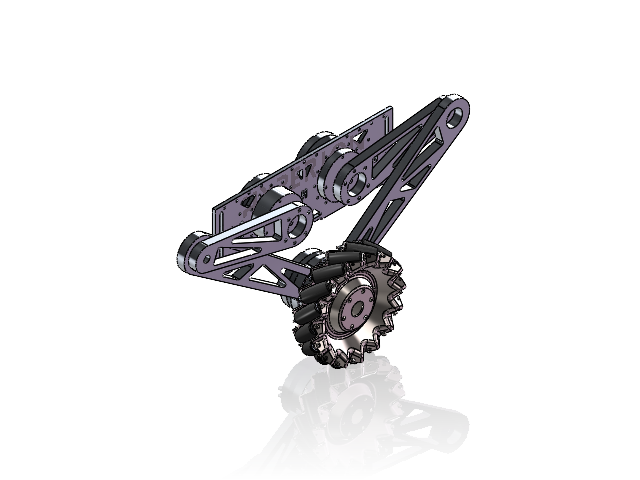
[picture p296: CAD file, 2024-02-25]
机械方面/轮腿结构/装配体-右轮腿-152mm.SLDASM
零件-关节电机架(内)
零件-电机-12-24V空心杯转子钕强磁无刷电机 x 3
零件-leg-knee-motor x 2
零件-leg-wheel x 2
148mm麦轮右
