Tylenoler/Hyperion/机械方面/主架部分/装配体-无壳主架.SLDASM

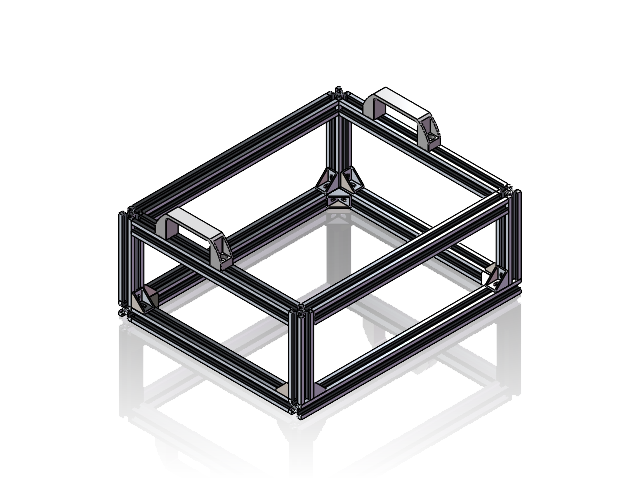
[picture p297: CAD file, 2024-02-18]
机械方面/主架部分/装配体-无壳主架.SLDASM
零件-标准件-AP-20 x 20 x 350 x 2
零件-标准件-AP-20 x 20 x 250 x 4
零件-标准件-AP-20 x 20 x 120 x 4
零件-标准件-Angle Bracket 2020 x 8
零件-标准件-AP-20 x 20 x 310 x 2
