Tylenoler/Hyperion/机械方面/云台机构/发射机构/装配体-发射机构-弹舱.SLDASM

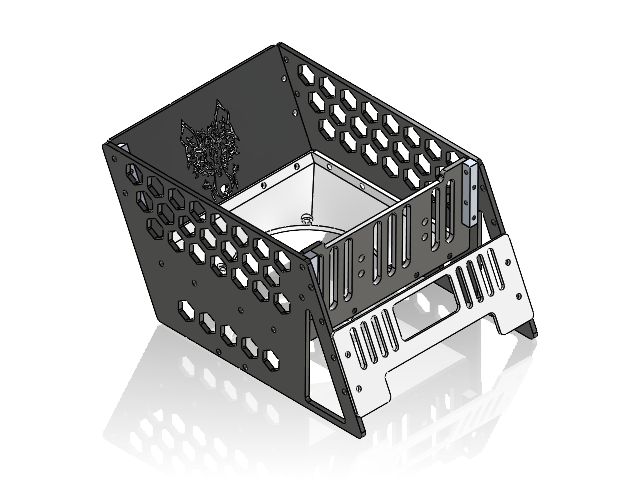
[picture p298: CAD file, 2024-02-10]
机械方面/云台机构/发射机构/装配体-发射机构-弹舱.SLDASM
放样弹舱底
弹舱侧板 x 2
弹舱前板
23赛季-转接件 x 3
弹舱后板2.0
零件-发射机构-陀螺仪防护板
