Tylenoler/Hyperion/机械方面/主架部分/装配体-带壳主架.SLDASM

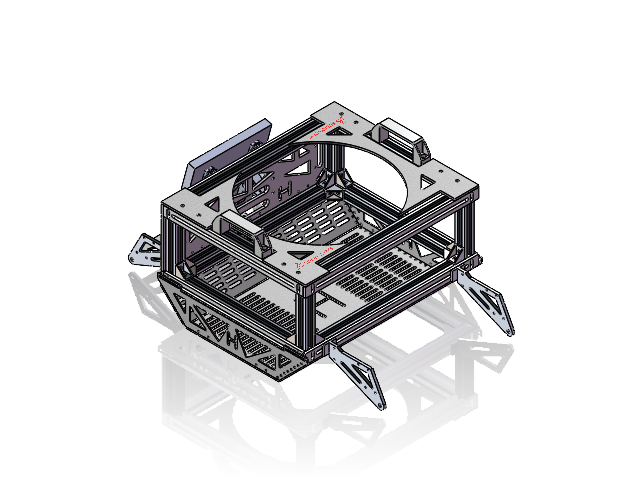
[picture p299: CAD file, 2024-02-08]
机械方面/主架部分/装配体-带壳主架.SLDASM
零件-标准件-AP-20 x 20 x 350 x 2
零件-标准件-AP-20 x 20 x 250 x 4
零件-标准件-Angle Bracket 2020 x 12
零件-标准件-AP-20 x 20 x 120 x 4
零件-标准件-AP-20 x 20 x 310 x 2
90mm Alu handle For 20x20 Profile.step x 2
零件-车架-前装甲板
零件-车架-快装板20X350 x 4
零件-车架-快装板20X290 x 4
零件-车架-底部-侧面壳 x 2
零件-车架-底部-前斜装甲板
零件-车架-底层-底板
零件-车架-上层-顶壳(X2) x 2
零件-屏幕-支撑架 x 2
零件-屏幕-微雪LED点阵显示屏RGB-Matrix-P2.5-64x64
零件-车架-前后万向轮安装板 x 4
零件-车架-屏幕底部防护
