Tylenoler/Hyperion/(list of files, cad)

Other CAD files:
机械方面/云台机构/云台/装配体-云台.SLDASM
机械方面/云台机构/电气/装配体-miniPC-NUC.SLDASM
机械方面/轮腿结构/麦克纳姆轮组部分/麦克纳姆轮/148mm麦轮右.SLDPRT
机械方面/电气部分/rocker-switch-34.snapshot.8 (2)/Rocker Switch_Green.stp
机械方面/电气部分/零件-屏幕-陶晶驰10寸.SLDPRT
机械方面/电气部分/rocker-switch-34.snapshot.8 (2)/Rocker Switch_Red.stp
机械方面/主架部分/零件-车架-底部-前斜装甲板.SLDPRT
机械方面/电气部分/emergency-stop-switch-2.snapshot.23/CHAVE RUN.SLDPRT
机械方面/轮腿结构/麦克纳姆轮组部分/Mecanum Final/Wheel Final.STEP
机械方面/电气部分/yw1l-mf2eq-af2eq.STEP
机械方面/轮腿结构/麦克纳姆轮组部分/零件-电机-12-24V空心杯转子钕强磁无刷电机.SLDPRT
机械方面/主架部分/零件-车架-后装甲板 -右 .SLDPRT
机械方面/云台机构/Pitch轴/零件-pitch轴云台侧板（无电机）.SLDPRT
机械方面/电气部分/emergency-stop-switch-2.snapshot.23/COVER-VERMELHO.SLDPRT
机械方面/云台机构/发射机构(对抗赛通用单枪)/M3508直流无刷减速电机.SLDPRT
机械方面/主架部分/零件-标准件-90mm Alu handle For 20x20 Profile.step
机械方面/主架部分/零件-标准件-AP-20 x 20 x 100.SLDPRT
机械方面/主架部分/零件-标准件-AP-20 x 20 x 350.SLDPRT
机械方面/主架部分/零件-车架-上层-顶壳(未开孔).SLDPRT
机械方面/云台机构/yaw轴/M4X12.SLDPRT
机械方面/云台机构/发射机构(对抗赛通用单枪)/21RM上供弹步兵-02.02.02.0012(散热片).SLDPRT
机械方面/云台机构/发射机构(对抗赛通用单枪)/21RM上供弹步兵-02.02.02.0013(紫外灯板).SLDPRT
机械方面/云台机构/发射机构(对抗赛通用单枪)/5mm基板.SLDPRT
机械方面/云台机构/发射机构(对抗赛通用单枪)/6x6x40铝排.SLDPRT
机械方面/云台机构/发射机构(对抗赛通用单枪)/M3-15+6.SLDPRT
机械方面/云台机构/发射机构(对抗赛通用单枪)/M3-30+6.SLDPRT
机械方面/云台机构/发射机构(对抗赛通用单枪)/PITCH轴转接件.SLDPRT
机械方面/云台机构/发射机构(对抗赛通用单枪)/充能安装片.SLDPRT
机械方面/云台机构/发射机构(对抗赛通用单枪)/前侧保护板.SLDPRT
机械方面/云台机构/发射机构(对抗赛通用单枪)/前弹舱板（长）.SLDPRT
机械方面/云台机构/发射机构(对抗赛通用单枪)/单发限位-手工裁剪.SLDPRT
机械方面/云台机构/发射机构(对抗赛通用单枪)/单轴舵机.SLDPRT
机械方面/云台机构/发射机构(对抗赛通用单枪)/右上侧弹舱板（宽）.SLDPRT
机械方面/云台机构/发射机构(对抗赛通用单枪)/右下侧弹舱板（宽）.SLDPRT
机械方面/云台机构/发射机构(对抗赛通用单枪)/图传固定架.SLDPRT
机械方面/云台机构/发射机构(对抗赛通用单枪)/图传安装板2.SLDPRT
机械方面/云台机构/发射机构(对抗赛通用单枪)/多功能支架.SLDPRT
机械方面/云台机构/发射机构(对抗赛通用单枪)/尼龙柱m3-15.SLDPRT
机械方面/云台机构/发射机构(对抗赛通用单枪)/左侧弹舱板（宽）.SLDPRT
机械方面/云台机构/发射机构(对抗赛通用单枪)/弹舱.SLDPRT
机械方面/云台机构/发射机构(对抗赛通用单枪)/弹舱侧底板.SLDPRT
机械方面/云台机构/发射机构(对抗赛通用单枪)/弹舱前侧板.SLDPRT
机械方面/云台机构/发射机构(对抗赛通用单枪)/弹舱盖板.SLDPRT
机械方面/云台机构/发射机构(对抗赛通用单枪)/拨弹轮 v59.SLDPRT
机械方面/云台机构/发射机构(对抗赛通用单枪)/拨弹轴上面的小黑板.SLDPRT
机械方面/云台机构/发射机构(对抗赛通用单枪)/拨弹连接.SLDPRT
机械方面/云台机构/发射机构(对抗赛通用单枪)/摩擦轮挡板.SLDPRT
机械方面/云台机构/发射机构(对抗赛通用单枪)/摩擦轮胶轮（溪地）.SLDPRT
机械方面/云台机构/发射机构(对抗赛通用单枪)/摩擦轮芯（溪地）.SLDPRT
机械方面/云台机构/发射机构(对抗赛通用单枪)/测速保护下板.SLDPRT
机械方面/云台机构/发射机构(对抗赛通用单枪)/测速防撞上板.SLDPRT
机械方面/云台机构/发射机构(对抗赛通用单枪)/金属主舵盘.SLDPRT
机械方面/云台机构/发射机构(对抗赛通用单枪)/零件-云台机构-弹舱侧板.SLDPRT
机械方面/云台机构/发射机构(对抗赛通用单枪)/零件-发射机构-二层板（3mm）.SLDPRT
机械方面/电气部分/emergency-stop-switch-2.snapshot.23/WASHER ESTRELADA.SLDPRT
机械方面/电气部分/emergency-stop-switch-2.snapshot.23/screw.SLDPRT
机械方面/电气部分/emergency-stop-switch-2.snapshot.23/washer.SLDPRT
机械方面/电气部分/rocker-switch-34.snapshot.8 (2)/Rocker Switch_Black.SLDASM
机械方面/电气部分/rocker-switch-34.snapshot.8 (2)/Rocker Switch_Green.SLDASM
机械方面/电气部分/rocker-switch-34.snapshot.8 (2)/Rocker Switch_Red.SLDASM
机械方面/轮腿结构/麦克纳姆轮组部分/Mecanum Final/Wheel Final.SLDASM
机械方面/轮腿结构/麦克纳姆轮组部分/零件-M3 x 4 Set Screw.step.SLDPRT
