Tylenoler/Hyperion/(commit log)

2024-01-29 made some change
    [规划购买物品清单.xlsx]
2024-01-30 make some changes
    [规划购买物品清单.xlsx]
2024-02-03 add xmind
    [规划购买物品清单.xlsx]
2024-02-03 add Mechanical part changes
    [.RoboMaster M3508直流无刷减速电机屁股-kuo.SLDPRT, 12V2600mAh安全电池E326S.SLDPRT, 17mm小弹丸.SLDPRT, 2 5 2.5轴承.SLDPRT, 2-5-2.5小轴承.SLDPRT, 2006电机联轴器.SLDPRT, 24V6100mAh磷酸铁锂电池P761S.SLDPRT, 30-6-9导轮.SLDPRT]
2024-02-08 daily modifications
    [.RoboMaster M3508直流无刷减速电机屁股-kuo.SLDPRT, 12-24V空心杯转子钕强磁无刷电机.SLDPRT, 12V2600mAh安全电池E326S.SLDPRT, 148mm麦轮右.SLDPRT, 148mm麦轮左.SLDPRT, 17mm小弹丸.SLDPRT, 2 5 2.5轴承.SLDPRT, 2-5-2.5小轴承.SLDPRT]
2024-02-10 0209Daily Modifications
    [6818轴承.SLDPRT, ANEL RETAINER.SLDPRT, CHAVE RUN.SLDPRT, CHAVE STOP.SLDPRT, CONTRA-PORCA.SLDPRT, COVER-VERDE.SLDPRT, COVER-VERMELHO.SLDPRT, EMERGENCY-STOP.SLDPRT]
2024-03-02 change location
    [装配-毕业设计部分.SLDASM]
